alexeyfedorenkofau/Ur-Pak-1269/ИД/Завзаказ/1269/ВД/Пояснение к заказу на Юр.docx

Пояснение к заказу на Юр-Пак.

Состав поставки:

- Шкаф управления главным приводом и приводами намотки;

- Пульт управления приводами намотки ПУ-ПН;

- Пульт управления главным приводом ПУ-ГП;

- Выносной пульт для заправки продукта ВП;

- два индуктивных датчика в квадратном формате.

Требования по шкафу управления.

Включение цепей управления выполняется при помощи переключателя с ключом. Все кнопки аварийной остановки (включая и существующие) интегрируются в схему. Для подключения существующих кнопок установить несколько клемм (например 4 или6 шт.)

Главный привод.

2 режима работы. «НАЛАДКА» и «РАБОТА». Выбор режима выполняется при помощи трехпозиционного переключателя. В режиме «НАЛАДКА» включение от кнопок ПУ-ГП. Обязательная блокировка – при включении главного привода должна быть включена электрическая муфта (предусмотреть различные напряжения управления катушкой муфты. 220В АС, 24В DC и 110 В АС (напряжение берем из существующего шкафа). Регулирование скорости выполняется при помощи 3-х позиционного переключателя с возвратом в среднюю точку (скорость БОЛЬШЕ и МЕНЬШЕ). В Режиме «РАБОТА» включение выполняется нажатием кнопки «ВКЛ. ГЛ. ПРИВОД». Блокировка по тормозу сохраняется.

Контроль включения тормоза выполняется при помощи индуктивного датчика.

При пропадании во время работы сигнала о включении тормоза, главный привод выключается, и система формирует сигнал «АВАРИЯ».

При аварии ЧРС главного привода система формирует сигнал «АВАРИЯ ЧРС».

Режим заправки продукта выполняется при помощи ВП (программируем режим JOG на частотном регуляторе). Значение частоты вращения при заправке определяется во время пуско-наладки.

И читайте ТЗ на машину.

Привода намотки (2 привода).

2 режима работы. «НАЛАДКА» и «РАБОТА». Выбор режима выполняется при помощи трехпозиционного переключателя.

Выбор работающего привода намотки «1 – 1_2 – 2». Выбор при помощи трехпозиционного переключателя. Включение от кнопок ПУ-ПН. В режиме «НАЛАДКА» регулирование скорости выполняется при помощи 3-х позиционного переключателя с возвратом в среднюю точку (скорость БОЛЬШЕ и МЕНЬШЕ). В режиме «РАБОТА» работает ПИД регулятор. Задание на ПИД регулятор задается при помощи резистора. Обратная связь от переменного резистора ЗАКАЗЧИКА.

Если во время работы происходит авария ЧРС приводов намотки – система формирует «АВАРИЮ».

И читайте ТЗ на машину.

По пультам ПУ-ГП и ПУ-ПН я нарисую их схему и расстановку, а вы возможно переведете ее в удобный для цеха вид.
