alexeyfedorenkofau/Ur-Pak-1269/ИД/Завзаказ/1269/КД/1269-1 Шафа/1269-1_ПАСПОРТ v2026 УХЛ4 IP30,31.docx

ISO 9001:2015

ТОВ «Призма Енерджи Груп» т./ф. (057) 752-04-08

Україна, 61037, м. Харків т. (057) 752-04-09

Проспект Героїв Харкова, буд. 199, літ. «АГ-2»

ПАСПОРТ

Шафа управління головним приводом та приводами намотування ФМ ВТ6

ВАХА.656441.946 ПС

ТУ У27.1-38279751-001:20220

Харків 2026 р.

1 ЗАГАЛЬНІ ВІДОМОСТІ ПРО ВИРІБ

Назва виробу | Шафа управління головним приводом та приводами намотування ФМ ВТ6 (далі – виріб)
Позначення | ВАХА.656441.946
Завод-виробник | ТОВ «Призма Енерджи Груп»
Заводський номер | 1269-1
Дата виготовлення | 06.01.2026
Технічні умови | ТУ У27.1-38279751-001:20220

2 ОСНОВНІ ТЕХНІЧНІ ДАНІ Й ХАРАКТЕРИСТИКИ

Номінальна напруга головного кола, В | ~400±10%
Частота, Гц | 50±1Гц
Номінальний струм головного кола, А | 250
Номінальна напруга допоміжного кола, В | ~230±10%/24VDC
Частота, Гц | 50±1Гц/--
Опір ізоляції, МОм, не менш | 1
Ступінь захисту (згідно ДСТУ EN 60529:2018) | IP31
Клас нагрівостійкості ізоляції | В
Клас захисту від ураження електричним струмом (згідно ГОСТ 12.2.007.0-75) | 1
Стійкість до дії механічних чинників зовнішнього середовища М2 (згідно ГОСТ 17516.1) | М2
Маса, кг
Габаритні розміри, мм | (2000+200)x1000x600

3 Умови експлуатації та зберігання

3.1 Виріб має кліматичне виконання УХЛ 4 згідно ГОСТ 15150.

3.2 Місце встановлення виробу має бути захищене від попадання води, масла, емульсії, а також від безпосередньої дії сонячної радіації.

#### 3.3 Виріб повинен зберігатися в штатній тарі в приміщеннях за наступних умов:

- температура повітря довкілля від +1° С до +40°С;

- відносна вологість повітря не більше 90% при температурі +35° С;

- місце зберігання виробу має бути захищене від потрапляння води, мастила, емульсії.

- у приміщеннях для зберігання не повинно бути агресивних домішок, що викликають корозію.

#### 3.4 Електрична мережа для живлення виробу має відповідати вимогам ГОСТ 13109.

4 КОМПЛЕКТНІСТЬ

Найменування | Найменування | Кількість | Примітка
ВАХА.656441.946 | Шафа управління головним приводом та приводами намотування ФМ ВТ6 | 1 | Зав. № 1269-1
ВАХА.656441.946 Е3 | Шафа управління головним приводом та приводами намотування ФМ ВТ6 Схема електрична принципова | 1
ВАХА.656441.946 ПЕ3 | Шафа управління головним приводом та приводами намотування ФМ ВТ6 Перелік елементів | 1
ВАХА.656441.946 ВЗ | Шафа управління головним приводом та приводами намотування ФМ ВТ6 Вигляд загальний | 1
ВАХА.656441.946 ПС | Паспорт | 1
| Ключ від замка шафи | 1

5 ГАРАНТІЙНІ ЗОБОВ'ЯЗАННЯ

5.1 Підприємство-Виробник гарантує відповідність якості виробу вимогам

ТУ У27.1-38279751-001:20220 і цього паспорта за умов виконання вимог транспортування, зберігання, порядку встановлення та експлуатації впродовж 12 місяців з дня введення в експлуатацію, але не більш ніж 18 місяців з дня відвантаження Замовнику.

5.2 Протягом гарантійного терміну підприємство-Виробник зобов'язується здійснювати гарантійний ремонт виробу у випадку виявлення браку підприємства-Виробника. Підприємство-Виробник при цьому залишає за собою право на заміну комплектуючих на рівноцінні (без погіршення параметрів виробу).

5.3 Гарантія діє за умов надання Замовником оригіналу паспорта на виріб, завіреного печаткою підприємства-Виробника.

5.4 У випадку оформлення рекламації на відмову виробу Замовник зобов'язаний у найкоротший термін сповістити про це підприємство-Виробник.

5.5 Виробник залишає за собою право перервати дію гарантії у разі вияву наступних фактів та (або) впливу на працездатність виробу наступних чинників та обставин:

- наявність у зовнішньому вигляді виробу слідів пошкоджень, що сталися за умов транспортування самовивозом;

- неналежні умови зберігання та експлуатації виробу;

- виконання монтажних робіт з встановлення та підключення виробу організаціями, які не мають ліцензії на проведення даного виду робіт;

- наявність пошкоджень обладнання виробу та зменшення ступеню захисту його оболонки в результаті неякісного монтажу виробу на об’єкті Замовника;

- додаткове розміщення Замовником у виробі обладнання, яке не входить до складу ВАХА.656441.946 ПЕ3

- виконання Замовником самостійного ремонту та внесення змін в електричну схему виробу;

- демонтаж Замовником частин устаткування виробу, що вийшли з ладу, без присутності при цьому представника від підприємства-Виробника.

- порушення правил експлуатації і режимів роботи, наведених у паспорті на виріб;

## 6 ВІДОМОСТІ ТА ПРАВИЛА ПРИЙМАННЯ

## 6.1 Відділом технічного контролю ТОВ «Призма Енерджи Груп» були проведені вхідний контроль матеріалів, покупних комплектуючих виробів і приймально-здавальні випробування виробу.

6.2 Вхідний контроль матеріалів, покупних комплектуючих виробів проведено відповідно до вимог ДСТУ ISO 9001:2015 за переліком продукції, що підлягає вхідному контролю, затвердженим у встановленому порядку.

6.3 Правила випробувань і приймання - згідно до чинного ТУ У27.1-38279751-001:20220.

6.4 Шафа управління головним приводом та приводами намотування ФМ ВТ6 ВАХА.656441.946 відповідає вимогам ТУ У27.1-38279751-001:20220 і визнано придатним до експлуатації.

Дата випуску 06.01.2026

Підпис осіб, відповідальних за приймання ____________

7 Підготовка ВИРоБу до використання

7.1 Заходи безпеки при підготовці виробу до використання.

7.1.1 Монтаж (демонтаж) і технічне обслуговування виробу мають проводитися із забезпеченням заходів безпеки, передбачених «Правилами технической эксплуатации электроустановок потребителей» (ПТЭЭП), «Правилами безопасной эксплуатации электроустановок потребителей» (ПБЭЭП), «Правилами безопасной эксплуатации электроустановок потребителей» (НПАОП 40.1-1.21-98)

7.1.2 Перед введенням виробу в роботу необхідно ознайомитись з технічною документацією на виріб.

7.2 Після встановлення виробу на місці необхідно закріпити його, підключити до контуру заземлення приміщення, перевірити усі контактні з'єднання та підтягнути ті, що прослаблено.

7.3 Підключити виріб відповідно до схеми зовнішніх підключень.

8 Заходи безпеки при використанні

8.1 Експлуатація виробу і технічне обслуговування повинні проводитися з забезпеченням заходів безпеки, передбачених «Правилами технической эксплуатации электроустановок потребителей» (ПТЭЭП), «Правилами безопасной эксплуатации электроустановок потребителей» (ПБЭЭП), «Правилами безопасной эксплуатации электроустановок потребителей» (НПАОП 40.1-1.21-98) електротехнічним персоналом з кваліфікаційною групою не нижче за III, який пройшов перевірку згідно з вимогами НПАОП 0.00-4.12-05 «Типовое положение про порядок проведения обучения и проверки знаний по вопросам охраны труда».

8.2 При використанні виробу необхідно періодично перевіряти з'єднання затискача заземлення виробу з контуром заземлення приміщення та надійність підключення.

8.3 У разі зникнення напруги на електроустановці, оперативний персонал має бути готовий до появи напруги у будь-який час без попередження.

9 ВИМОГИ ДО ЕКСПЛУАТАЦІЇ

9.1 При експлуатації виробу Забороняється:

- Допускати до роботи осіб, які не ознайомлені з експлуатаційною документацію на виріб і не мають належної форми допуску до робіт;

- Підключати виріб до мережі живлення без попереднього його заземлення;

- Приєднувати кабелі до працюючого виробу;

- Від’єднувати кабелі від працюючого виробу;

- Відкривати працюючий виріб;

- Проводити зміну режиму роботи (РУЧН.-0-АВТ.) при ввімкненому обладнанні;

- Проводити заміну електрообладнання та апаратів ВИРоБу, а також вносити зміни в електричну схему;

- Піддавати апарати ВИРоБу дії зовнішніх чинників (механічних, ХІМІЧНИХ, термічних та ін.), які можуть впливати на працездатність ВИРоБу;

- Перешкоджати циркуляції повітря всерединиі шафи виробу (затуляти вентиляційні рЕшітки).

- одночасна робота двох вводiв для шаф з пристроями «авр» ТА ЗМІНА НАЛАШТУВАНЬ РЕЛЕ, ЩО ВХОДЯТ ДО СКЛАДУ «авр».

- ПОРУШЕННЯ ОРИГIНАЛЬНОї ПЛОМБИ «ПРИЗМА ЕНЕРДЖИ ГРУП»

9.2 Впродовж дії гарантійного обслуговування також Забороняється:

- Змінювати налаштування регулятора реактивної потужності

9.3 У разі невиконання вимог п.п. 9.1, Виробник залишає за собою право зняти виріб з гарантійного обслуговування.

10 ТЕХНІЧНЕ ОБСЛУГОВУВАННЯ (ТО)

10.1 Для проведення ТО виробу виконайте наступні роботи :

- зніміть напругу з виробу та виключіть можливість її раптової подачі;

- відкрийте двері шафи;

- перевірте відсутність напруги на вхідних затискачах виробу індикатором напруги або переносним вольтметром;

- від'єднайте зовнішні кабелі, які підключені до виробу;

- очистіть внутрішню поверхню шафи від пилу та бруду за допомогою пилососа, пензлика, тканини;

- перевірте відсутність механічних пошкоджень провідників, корозії, слідів підгоряння і при виявленні вказаних пошкоджень усуньте їх;

- підтягніть ослаблені кріпильні і контактні з'єднання;

- перевірте вручну чіткість спрацьовування автоматичних вимикачів при включенні і відключенні;

- замініть несправні автоматичні вимикачі;

- перевірте стан лакофарбових покриттів, пошкоджені покриття відновіть.

10.2 Проведіть контроль перехідного опору між контактом затискача заземлення та металоконструкцією кожної шафи (норма - не більше 0,1 Ω).

10.3 Проведіть перевірку електричного опору ізоляції головних кіл, кіл контролю і сигналізації виробу відносно корпусу виробу (мегаомметром на 500 В), для чого виконайте зазначений нижче обсяг робіт в наступній послідовності:

- від’єднайте від шинки заземлення всі дроти внутрішнього монтажу;

- включіть всі автоматичні вимикачі виробу;

- вийміть з виробу пристрої, що містять напівпровідникові прилади;

- з'єднайте разом струмоведучі елементи вхідних і вихідних електричних кіл, використовуючи мідний луджений дріт, і виміряйте опір ізоляції між ними і контактом затискача для заземлення конструкції шафи.

10.4 Відновіть монтажні з'єднання у виробі.

10.5 Періодичність проведення ТО:

Види робіт | Періодичність | Примітки
Візуальний огляд комплектуючих і видалення пилу | 1 раз на 3 місяці | Або по мірі забруднення
Перевірка стану контактних з'єднань автоматичних вимикачів і плавких вставок | 1 раз на 3 місяці
Огляд і перевірка надійності контактних з’єднань шин (перевірка відсутності нагрівання в місцях з'єднання) | 1 раз на 6 місяців
Перевірка контрольно-вимірювальної й світлосигнальної апаратури | 1 раз на 6 місяців
Перевірка надійності контакту з’єднання захисного заземлення та корпусу шафи | 1 раз на 6 місяців
Вимір опору заземлюючого пристрою | 1 раз на 6 місяців | УВАГА: Виконується атестованим персоналом
Перевірка повного опору петлі «фаза-нуль» | 1 раз на рік

11 ВІДОМОСТІ ПРО РЕКЛАМАЦІЇ

Дата рекламації | Номер рекламаційного акта | Короткий зміст рекламації | Міри, прийняті по рекламації | Посада. ФІБ підпис
