alexeyfedorenkofau/Ur-Pak-1269/ИД/Завзаказ/1269/ВД/2025_11_17_ФГМ.- ИД в схему.xlsx

Sheet: Вариант №2 (2)
АРТИКУЛ | 30% | EUR | 50.00 | 43.00 | UAH | кол. | скидка | ПРАЙС |  | ЗАКУПКА |  | ↓ | ↑
 | НАИМЕНОВАНИЕ | без НДС | c НДС | USD c НДС | c НДС | шт | % | цена | сумма | цена | сумма | 695426.59 | 847550.00
 | Шкаф управления |  |  |  |  | 1 |  | 635832.36 |  | 491746.43 |  | 506146.43 | 639280.00 | 532733.3333
 | Конструктив
 | 2000х800х400
XL55-2084 | Шафа XL55-2084 | 398.38 |  |  |  | 1 | 10% | 23902.81 | 23902.81 | 21512.53 | 21512.53
XL-UM1 | Куток монтажний XL-UM1 | 12.94 |  |  |  | 2 | 10% | 776.65 | 1553.30 | 698.99 | 1397.97
XL-RV18 | Рейка вертикальна XL-RV18 | 40.46 |  |  |  | 1 | 10% | 2427.43 | 2427.43 | 2184.69 | 2184.69
XL-MM28 | Міст монтажний XL-MM28 | 14.97 |  |  |  | 5 | 10% | 897.90 | 4489.51 | 808.11 | 4040.56
XL-MM48 | Міст монтажний XL-MM48 | 23.08 |  |  |  | 2 | 10% | 1384.71 | 2769.41 | 1246.24 | 2492.47
XL-RH14 | Рейка горизонтальна XL-RH14 | 20.63 |  |  |  | 3 | 10% | 1237.80 | 3713.40 | 1114.02 | 3342.06
XL-UM2 | Куток монтажний XL-UM2 | 9.51 |  |  |  | 3 | 10% | 570.86 | 1712.57 | 513.77 | 1541.31
XLE-CB14 | Панель бокова цоколя XLE-CB14 | 5.73 |  |  |  | 1 | 10% | 343.98 | 343.98 | 309.58 | 309.58
XLE-CT18 | Панель торцева цоколя XLE-CT18 | 23.14 |  |  |  | 1 | 10% | 1388.14 | 1388.14 | 1249.33 | 1249.33
XLE-U10 | Кутовий елемент цоколя XLE-U10 | 28.28 |  |  |  | 1 | 10% | 1696.80 | 1696.80 | 1527.12 | 1527.12
XL-RB12 | Рим-болт XL-RB12 | 20.00 |  |  |  | 1 | 10% | 1200.00 | 1200.00 | 1080.00 | 1080.00
XL-UU20 | Куток універсальний XL-UU20 | 43.78 |  |  |  | 1 | 10% | 2626.88 | 2626.88 | 2364.19 | 2364.19
NSYCVF300M230PF | ВЕНТИЛЯТОР 297M3Ч 230В | 114.27 |  |  |  | 1 | 35% | 6856.28 | 6856.28 | 4456.58 | 4456.58
NSYCAG291LPF | РЕШІТКА ВИПУСКНА 291X291 | 32.99 |  |  |  | 2 | 20% | 1979.40 | 3958.80 | 1583.52 | 3167.04
NSYCCOTHO | ТЕРМОСТАТ ВЕНТИЛЯТОРА °C | 10.37 | 0.01 |  |  | 1 | 20% | 622.95 | 622.95 | 498.36 | 498.36 |  |  | 47824.24
 | Питание
 | Рубильник 250 А +.боковая ручка+ штанга 200 мм |  |  |  | 9500.00 | 1 | 0% | 9500.00 | 9500.00 | 9500.00 | 9500.00
 | РБД-250 |  |  |  | 500.00 | 3 | 0% | 500.00 | 1500.00 | 500.00 | 1500.00
 | Разное |  |  |  | 10000.00 | 1 | 0% | 10000.00 | 10000.00 | 10000.00 | 10000.00
 | Работа
 | Цех |  |  |  | 8000.00 | 1 | 0%
 | Техотдел |  |  |  | 4800.00 | 1 | 0%
 | ОТК |  |  |  | 1600.00 | 1 | 0%
 | Главный привод 22 кВт
 | Поз. , Норія, 30 кВт
GV3P65 | АВТ. ВИМ З КОМБ.РОЗЧЕП.65А ГВИНТ.ЗАТИСК. | 173.95 |  |  |  | 1 | 35% | 10436.74 | 10436.74 | 6783.88 | 6783.88
GVAE1 | ДОДАТ.БЛОК КОНТАКТІВ НО АБО НЗ | 5.72 |  |  |  | 1 | 35% | 343.20 | 343.20 | 223.08 | 223.08
atv930D30N4 | ПЕРЕТВОРЮВАЧ ЧАСТОТИ ATV930 30кВт 380В | 2732.40 |  |  |  | 1 | 35% | 163944.00 | 163944.00 | 106563.60 | 106563.60
A9K02106 | Автоматичний вимикач K60N 1P 6A C 6кA | 4.26 |  |  |  | 1 | 35% | 255.60 | 255.60 | 166.14 | 166.14
3012325 | FBSC: Захисний ковпачок | 0.94 |  |  |  | 1 | 35% | 56.40 | 56.40 | 36.66 | 36.66
4520016 | Провід H07V-K 1X16 чорний (струм 85 А) | 4.61 |  |  |  | 12 | 20% | 276.50 | 3318.00 | 221.20 | 2654.40
BM00614 | Наконечник, 16 мм2 |  | 0.08 |  |  | 24 | 20% | 4.15 | 99.64 | 3.32 | 79.71
3044199 | Прохідна клема 16 мм.кв. UT 16 | 1.62 |  |  |  | 3 | 35% | 97.17 | 291.51 | 63.16 | 189.48
3044212 | Клема заземлення 16 мм.кв. UT 16-PE | 4.72 |  |  |  | 1 | 35% | 283.27 | 283.27 | 184.13 | 184.13
0829144 | Маркування для клем UCT-TM 12 | 0.20 |  |  |  | 4 | 35% | 12.00 | 48.00 | 7.80 | 31.20
3047206 | Кінцева кришка D-UT 16 | 0.53 |  |  |  | 1 | 35% | 31.60 | 31.60 | 20.54 | 20.54
3022218 | Кінцевий тримач CLIPFIX 35 | 0.48 |  |  |  | 1 | 35% | 29.04 | 29.04 | 18.88 | 18.88
0811969 | Тримач маркування KLM 3 | 0.23 |  |  |  | 1 | 35% | 14.03 | 14.03 | 9.12 | 9.12
5031388 | Листи з маркувальними етикетками BMK 20X 8 YE | 1.00 |  |  |  | 3 | 35% | 60.00 | 180.00 | 39.00 | 117.00
4510011 | Провід H05V-K 1X0,5 чорний у бухтах по 100 м | 0.22 |  |  |  | 30 | 20% | 13.00 | 390.00 | 10.40 | 312.00
BM00601 | Наконечник, 0,5 мм2 |  | 0.01 |  |  | 20 | 20% | 0.71 | 14.17 | 0.57 | 11.34
3210499 | PT 2,5-3L Прохідна клема | 2.68 |  |  |  | 3 | 35% | 160.61 | 481.84 | 104.40 | 313.20
0828744 | Маркування для клем UCT-TMF 5 | 0.06 |  |  |  | 6 | 35% | 3.60 | 21.60 | 2.34 | 14.04
3211647 | Кінцева кришка D-PT 2,5-3L | 0.52 |  |  |  | 1 | 35% | 30.99 | 30.99 | 20.14 | 20.14
3044092 | Клема заземлення 2,5 мм.кв. UT 2,5-PE | 1.83 |  |  |  | 1 | 35% | 109.63 | 109.63 | 71.26 | 71.26
0828734 | Маркування для клем UCT-TM 5 | 0.05 |  |  |  | 2 | 35% | 3.00 | 6.00 | 1.95 | 3.90
3047028 | Кінцева кришка D-UT 2,5/10 | 0.34 |  |  |  | 1 | 35% | 20.65 | 20.65 | 13.42 | 13.42
3022218 | Кінцевий тримач CLIPFIX 35 | 0.48 |  |  |  | 1 | 35% | 29.04 | 29.04 | 18.88 | 18.88
0811969 | Тримач маркування KLM 3 | 0.23 |  |  |  | 1 | 35% | 14.03 | 14.03 | 9.12 | 9.12
5031388 | Листи з маркувальними етикетками BMK 20X 8 YE | 1.00 |  |  |  | 3 | 35% | 60.00 | 180.00 | 39.00 | 117.00
1163116 | WMS-OT HF 2,4 (EX4)RL: Маркувальний кембрік 120 метрів. | 1.36 |  |  |  | 1 | 35% | 81.43 | 81.43 | 52.93 | 52.93
 | Поз. , Норія, 18,5 кВт
GV3P40 | АВТ. ВИМ З КОМБ.РОЗЧЕП.40А ГВИНТ.ЗАТИСК. | 163.40 |  |  |  | 2 | 35% | 9803.95 | 19607.90 | 6372.57 | 12745.14
GVAE1 | ДОДАТ.БЛОК КОНТАКТІВ НО АБО НЗ | 5.72 |  |  |  | 2 | 35% | 343.20 | 686.40 | 223.08 | 446.16
atv930D18N4 | ПЕРЕТВОРЮВАЧ ЧАСТОТИ ATV930 18,5кВт 380В | 1995.11 |  |  |  | 2 | 25% | 119706.60 | 239413.20 | 89779.95 | 179559.90
A9K02106 | Автоматичний вимикач K60N 1P 6A C 6кA | 4.26 |  |  |  | 2 | 35% | 255.60 | 511.20 | 166.14 | 332.28
ZB5AD3 | ГОЛОВКА ДЛЯ ПЕРЕМИКАЧА | 5.23 |  |  |  | 2 | 35% | 313.80 | 627.60 | 203.97 | 407.94
ZB5AZ009 | ФІКСУЮЧА ПЛАСТИНА ХВ5А | 1.20 |  |  |  | 2 | 35% | 72.00 | 144.00 | 46.80 | 93.60
ZBE101 | БЛОК-КОНТ для XB5, 1НО | 2.94 |  |  |  | 6 | 35% | 176.40 | 1058.40 | 114.66 | 687.96
4520014 | Провід H07V-K 1X6 чорний (струм 46 А) | 1.72 |  |  |  | 24 | 20% | 103.50 | 2484.00 | 82.80 | 1987.20
BM00610 | Наконечник, 6 мм2 |  | 0.04 |  |  | 48 | 20% | 2.01 | 96.36 | 1.61 | 77.09
3044199 | Прохідна клема 16 мм.кв. UT 16 | 1.62 |  |  |  | 6 | 35% | 97.17 | 583.02 | 63.16 | 378.96
3044212 | Клема заземлення 16 мм.кв. UT 16-PE | 4.72 |  |  |  | 2 | 35% | 283.27 | 566.54 | 184.13 | 368.25
0829144 | Маркування для клем UCT-TM 12 | 0.20 |  |  |  | 8 | 35% | 12.00 | 96.00 | 7.80 | 62.40
3047206 | Кінцева кришка D-UT 16 | 0.53 |  |  |  | 2 | 35% | 31.60 | 63.20 | 20.54 | 41.08
3022218 | Кінцевий тримач CLIPFIX 35 | 0.48 |  |  |  | 2 | 35% | 29.04 | 58.08 | 18.88 | 37.75
0811969 | Тримач маркування KLM 3 | 0.23 |  |  |  | 2 | 35% | 14.03 | 28.06 | 9.12 | 18.24
5031388 | Листи з маркувальними етикетками BMK 20X 8 YE | 1.00 |  |  |  | 6 | 35% | 60.00 | 360.00 | 39.00 | 234.00
4510011 | Провід H05V-K 1X0,5 чорний у бухтах по 100 м | 0.22 |  |  |  | 60 | 20% | 13.00 | 780.00 | 10.40 | 624.00
BM00601 | Наконечник, 0,5 мм2 |  | 0.01 |  |  | 40 | 20% | 0.71 | 28.34 | 0.57 | 22.67
3210499 | PT 2,5-3L Прохідна клема | 2.68 |  |  |  | 6 | 35% | 160.61 | 963.68 | 104.40 | 626.39
0828744 | Маркування для клем UCT-TMF 5 | 0.06 |  |  |  | 12 | 35% | 3.60 | 43.20 | 2.34 | 28.08
3211647 | Кінцева кришка D-PT 2,5-3L | 0.52 |  |  |  | 2 | 35% | 30.99 | 61.98 | 20.14 | 40.28
3044092 | Клема заземлення 2,5 мм.кв. UT 2,5-PE | 1.83 |  |  |  | 2 | 35% | 109.63 | 219.25 | 71.26 | 142.51
0828734 | Маркування для клем UCT-TM 5 | 0.05 |  |  |  | 4 | 35% | 3.00 | 12.00 | 1.95 | 7.80
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
 | Робота з программування |  |  |  | 50000.00 | 1 | 0% | 50000.00 | 50000.00 | 50000.00 | 50000.00 |  |  | 86000 | 71666.66667
 | Робота з программування |  |  |  | 16000.00 | 1 | 0% | 16000.00 | 16000.00 | 16000.00 | 16000.00 |  |  | 72000 | 14400 | 86400
 | Пуско-налогоджувальні роботи |  |  |  | 20000.00 | 1 | 0% | 20000.00 | 20000.00 | 20000.00 | 20000.00 |  |  | 36000 | 7200 | 43200
 | Шеф-монтаж |  |  |  | 20000.00 | 1 | 0% | 20000.00 | 20000.00 | 20000.00 | 20000.00 |  |  |  | 21600 | 129600
 | Командировочные расходы |  |  |  | 20000.00 | 1 | 0% | 20000.00 | 20000.00 | 20000.00 | 20000.00
 | Кабель |  |  |  |  | 1 |  | 0.00 |  | 0.00 |  | 0.00 | 0.00
 | Для приводов намотки КГ НВ 4х6 |  |  |  |  | 22 | 0% | 0.00 | 0.00 | 0.00 | 0.00 |  |  | 86000 | 71666.66667
 | Для главного привода КГ НВ 4х10 |  |  |  |  | 15 | 0% | 0.00 | 0.00 | 0.00 | 0.00 |  |  | 72000 | 14400 | 86400
 | Датчик инжуктивній 3х1 єкран |  |  |  |  | 25 | 0% | 0.00 | 0.00 | 0.00 | 0.00 |  |  | 36000 | 7200 | 43200
 | Виносний пульт |  |  |  |  | 1 | 0% | 0.00 | 0.00 | 0.00 | 0.00 |  |  |  | 21600 | 129600
 | Командировочные расходы |  |  |  |  | 1 | 0% | 0.00 | 0.00 | 0.00 | 0.00
 | Розподільна клема PTFIX 6/18X2,5 BU

Sheet: Вариант №2 (3)
АРТИКУЛ
 | НАИМЕНОВАНИЕ | шт
 | Шкаф управления | 1
 | Конструктив
 | 2000х800х400
 | Шафа 2000х800х400 КУБ IP 54 | 1
NSYCVF300M230PF | ВЕНТИЛЯТОР 297M3Ч 230В | 1
NSYCAG291LPF | РЕШІТКА ВИПУСКНА 291X291 | 2
NSYCCOTHO | ТЕРМОСТАТ ВЕНТИЛЯТОРА °C | 1
GV3P65 | АВТ. ВИМ З КОМБ.РОЗЧЕП.65А ГВИНТ.ЗАТИСК. | 1
atv930D30N4 | ПЕРЕТВОРЮВАЧ ЧАСТОТИ ATV930 30кВт 380В | 1
GV3P40 | АВТ. ВИМ З КОМБ.РОЗЧЕП.40А ГВИНТ.ЗАТИСК. | 2
atv930D18N4 | ПЕРЕТВОРЮВАЧ ЧАСТОТИ ATV930 18,5кВт 380В | 2
TM241CE40T | ПЛК M241 40 ВХ/ВИХ ТРАНЗ 2RS485 1ETH | 1
TM3DI16 | МОДУЛЬ TM3 16 ВХ =24В | 1
TM3AI8 | МОДУЛЬ TM3 8 АНАЛОГ ВХ 12 БІТ | 1
TM3AQ4G | МОДУЛЬ TM3 4 АНАЛОГ ВИХ 12 БІТ ПРУЖ | 1
TM3XFHSC202G | МОДУЛЬ TM3 ЕКСПЕРТ, 2 ЛІЧ.+ПОДІЯ, ПРУЖ. (для енкодера) | 1
 | Разное (Монтажные материалы, маркировка, ввод питания в шкафа, промежуточные, клеммы, разработка схемы, проверка ОТК) | 1

Sheet: Кабель
Силовой
Главній привод | 4х6 мм2
Привод намотки | 4х4 мм2
Контрольній
Датчики

Sheet: Доработка 17_11
АРТИКУЛ | 30% | EUR | 50.00 | 43.00 | UAH | кол. | скидка | ПРАЙС |  | ЗАКУПКА |  | ↓ | ↑
 | НАИМЕНОВАНИЕ | без НДС | c НДС | USD c НДС | c НДС | шт | % | цена | сумма | цена | сумма | 22830.00 | 29680.00
 | Комплектация ПУ1 заправка |  |  |  |  | 1 |  | 22830.00 |  | 22830.00 |  | 22830.00 | 29680.00 | 24733.33333
DLAP2 B | Пульт RAVIOLI | 43.00 |  |  |  | 1 | 0% | 2580.00 | 2580.00 | 2580.00 | 2580.00 |  |  | 4946.666667
Разьем 4-пін |  | 45.00 |  |  |  | 1 | 0% | 2700.00 | 2700.00 | 2700.00 | 2700.00 |  |  | 29680 | 14840
Источник питания | NDR-24-120 | 60.00 |  |  |  | 1 | 0% | 3600.00 | 3600.00 | 3600.00 | 3600.00
 | клеммы соединительные |  |  |  | 500 | 5 | 0% | 500.00 | 2500.00 | 500.00 | 2500.00
 | Мотнатжні роботи |  |  |  | 10000.00 | 1 | 0% | 10000.00 | 10000.00 | 10000.00 | 10000.00
 | Реле времени |  | 29.00 |  |  | 1 | 0% | 1450.00 | 1450.00 | 1450.00 | 1450.00
 | Кабель |  |  |  |  | 1 |  | 0.00 |  | 0.00 |  | 0.00 | 0.00
 | Для приводов намотки КГ НВ 4х6 |  |  |  |  | 22 | 0% | 0.00 | 0.00 | 0.00 | 0.00
 | Для главного привода КГ НВ 4х10 |  |  |  |  | 15 | 0% | 0.00 | 0.00 | 0.00 | 0.00 |  |  |  |  | 0
 | Датчик индуктивній+резистор 3х1 єкран |  |  |  |  | 37 | 0% | 0.00 | 0.00 | 0.00 | 0.00 |  |  |  |  | 0
 | Пульт головного приводу |  |  |  |  | 1 | 0% | 0.00 | 0.00 | 0.00 | 0.00 |  |  |  |  | 0
 | Командировочные расходы |  |  |  |  | 1 | 0% | 0.00 | 0.00 | 0.00 | 0.00
