alexeyfedorenkofau/Ur-Pak-1269/(list of files, cad)

Other CAD files:
ИД/Завзаказ/1269/ВД/Разметка пультов.dwg
