alexeyfedorenkofau/Ur-Pak-1269/ИД/Завзаказ/1269/ВД/Разметка пультов-Модель.pdf

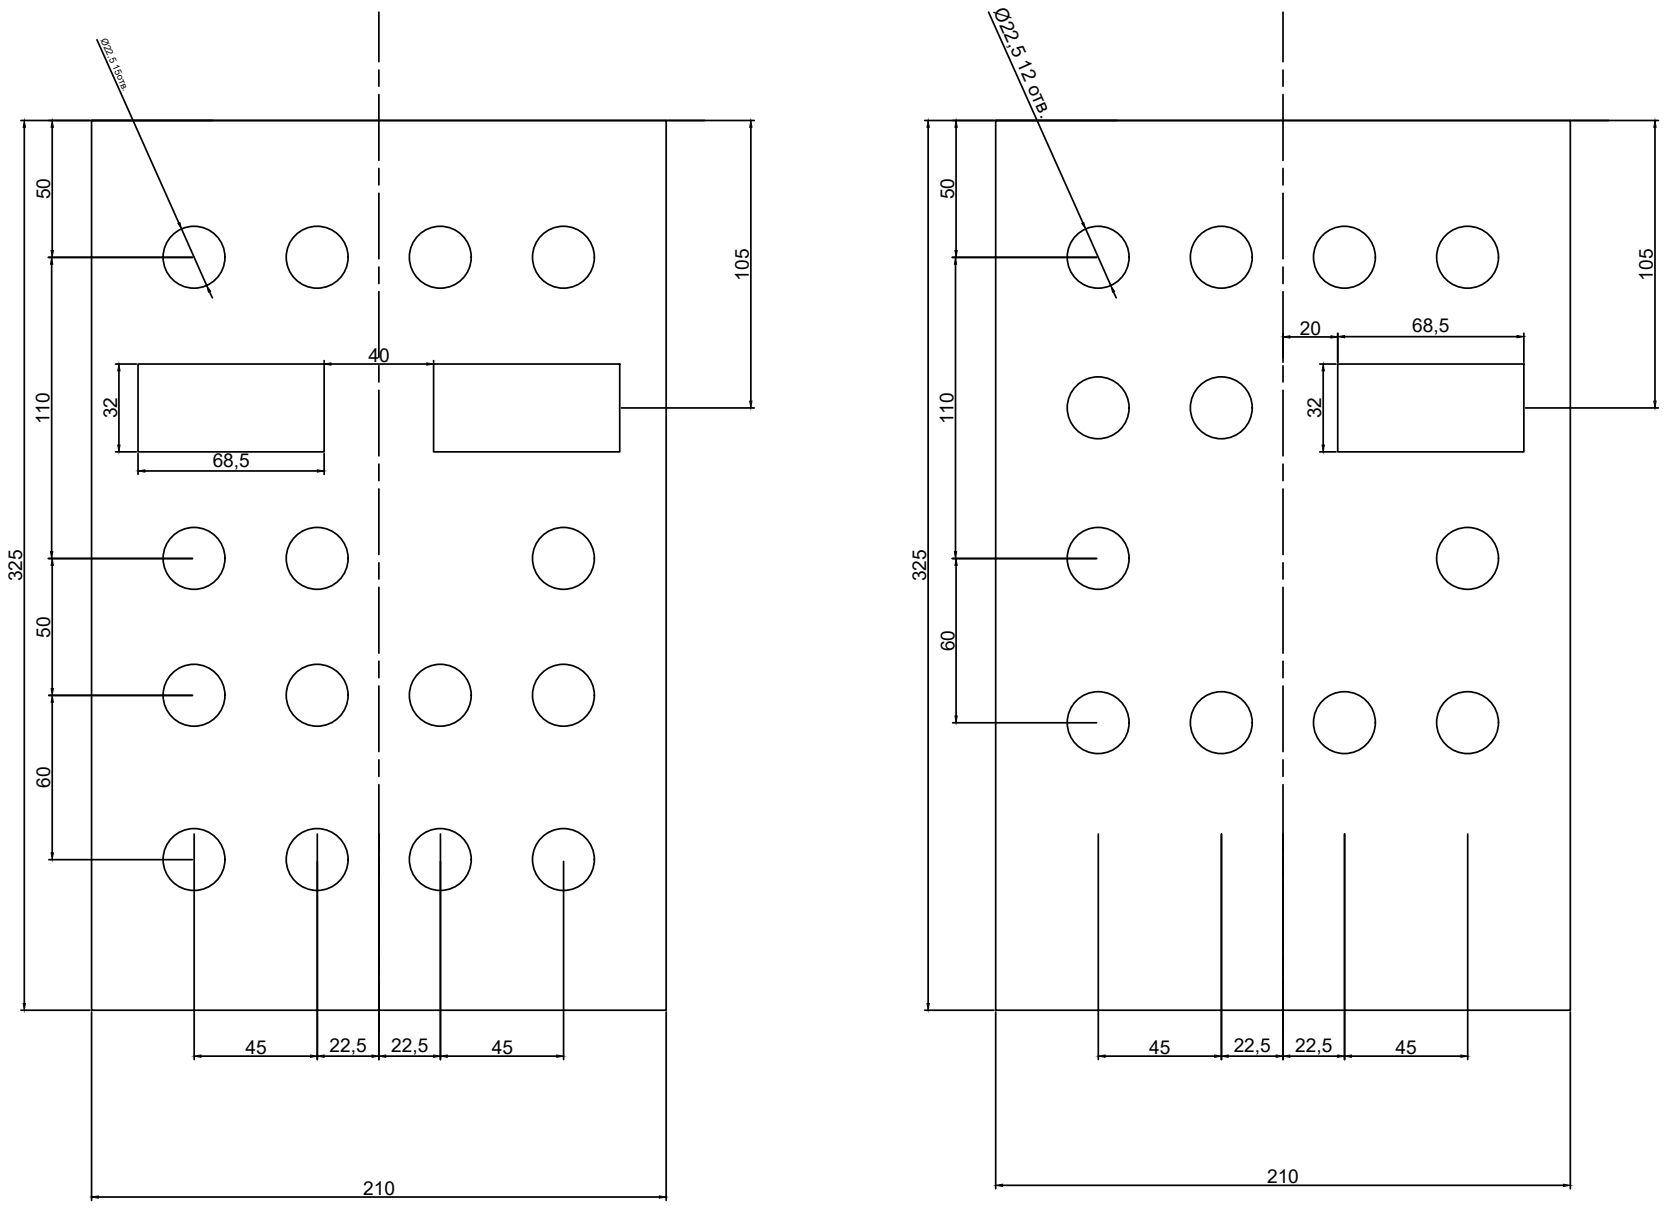
[picture p1: page 1]
Ø22,5 15отв.; 325 45 22,5 22,5 45 Ø22,5 12 отв.
