alexeyfedorenkofau/Ur-Pak-1269/ИД/Завзаказ/1269/КД/1269-1 Шафа/1269-1 Шафа керування.pdf

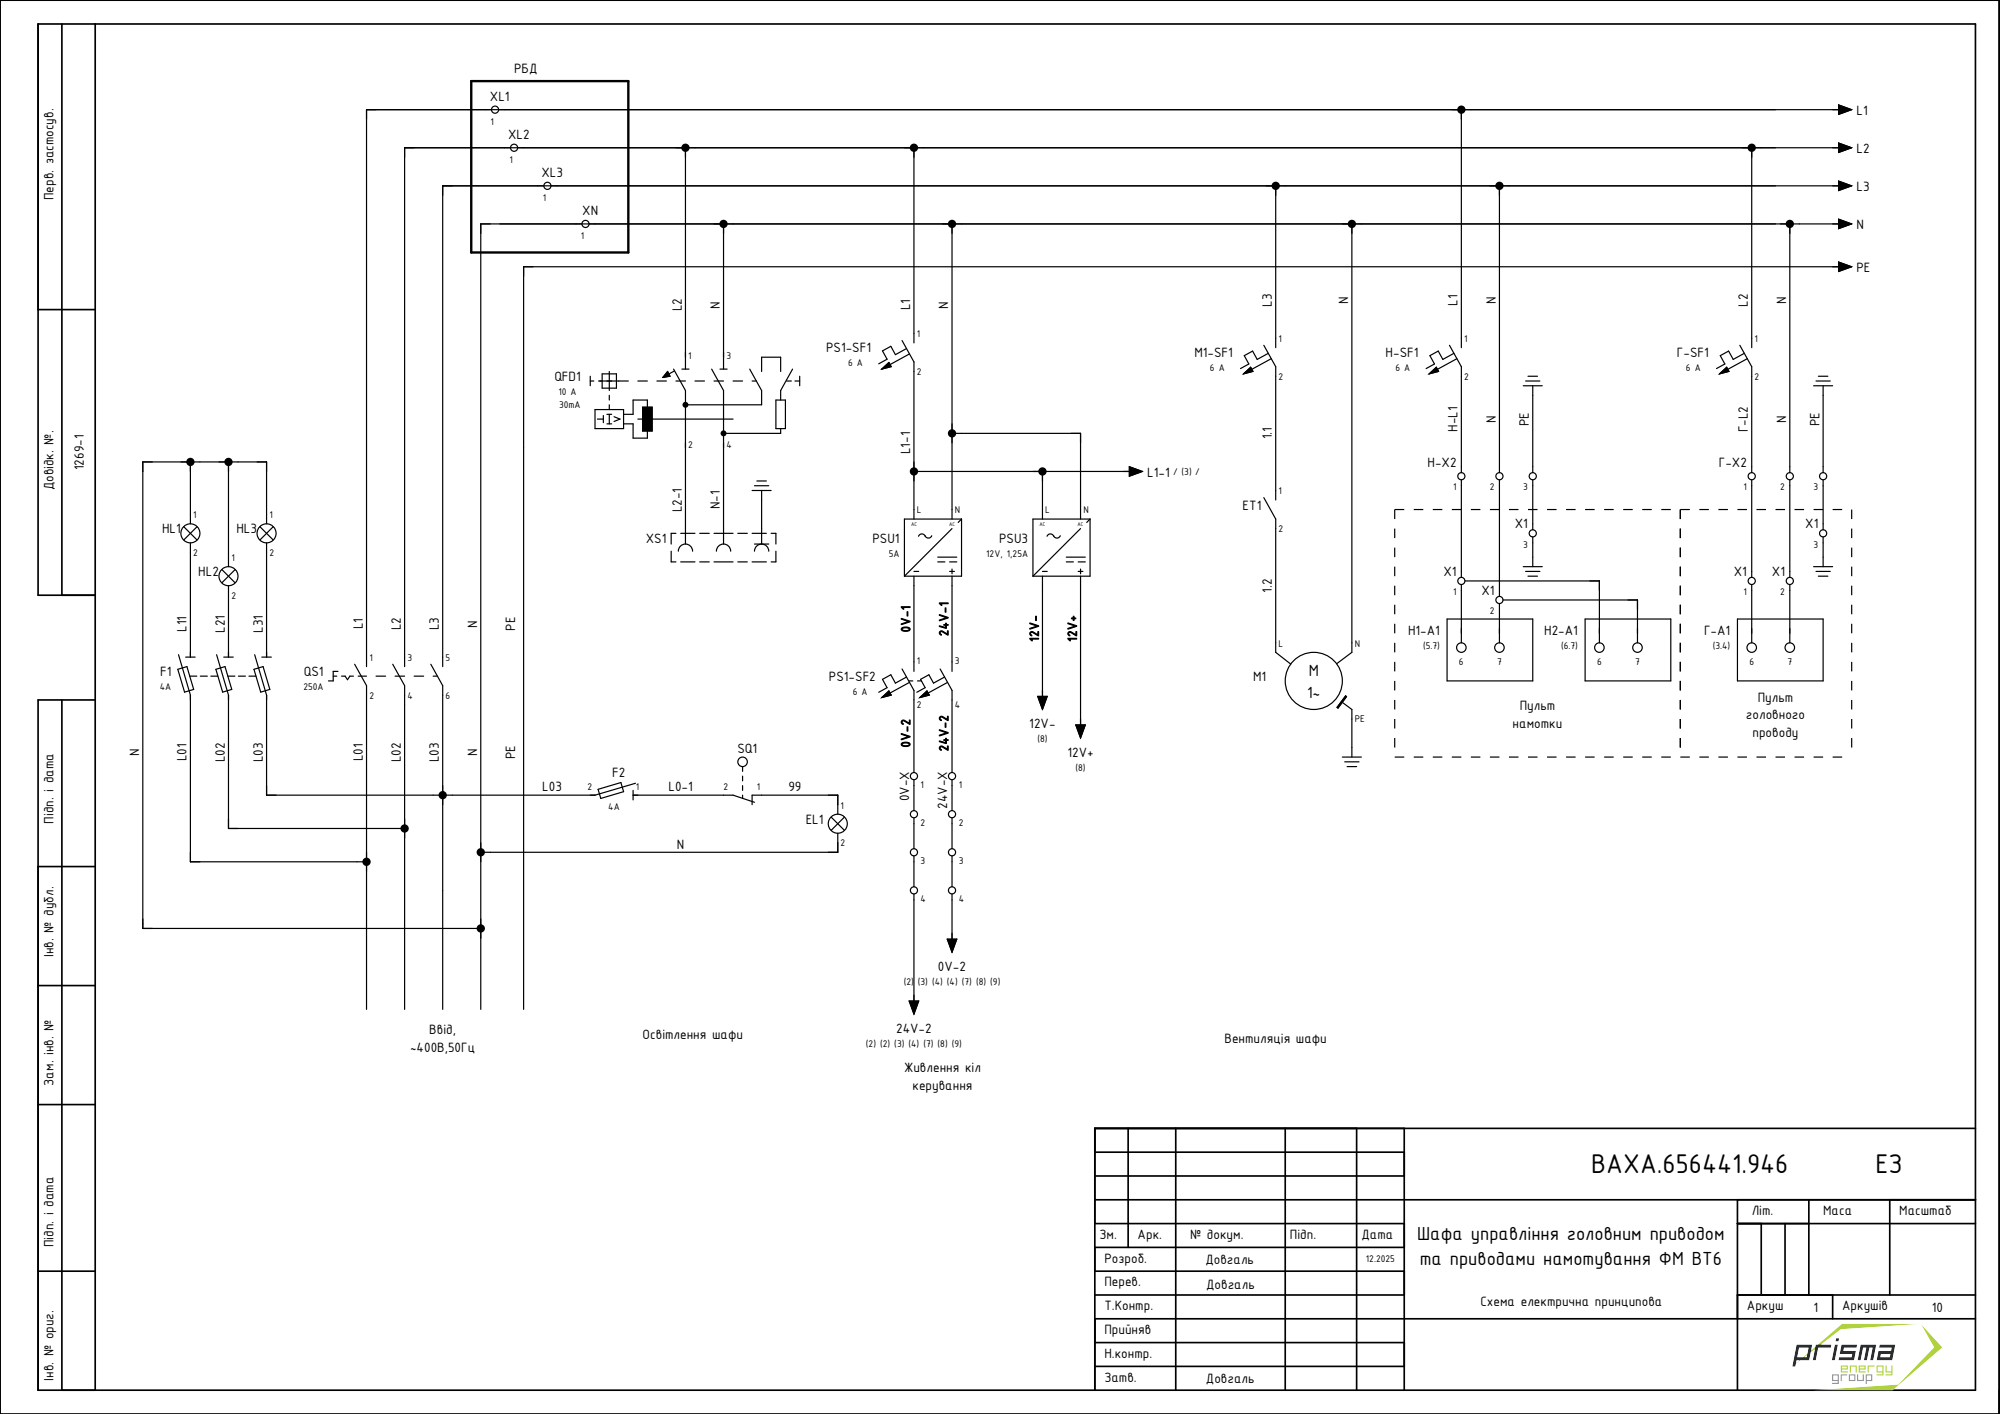
[picture p2: page 1]

Довідк. №. Перв. застосув. Інв. № ориг. Підп. і дата Зам. інв. № Інв. № дубл. Підп. і дата

ВАХА.656441.946 ЕЗ

Шафа управління головним приводом та приводами намотування ФМ ВТ6 | Літ. | Маса | Масштаб

Зм. | Арк. | № докум. | Підп. | Дата
Розроб. | | Довгаль | | 12.2025
Перев. | | Довгаль
Т.Контр. | | | | | Аркуш | 10 Схема електрична принципова Аркушів

Прийняв
Н.контр.
Затв. | Довгаль

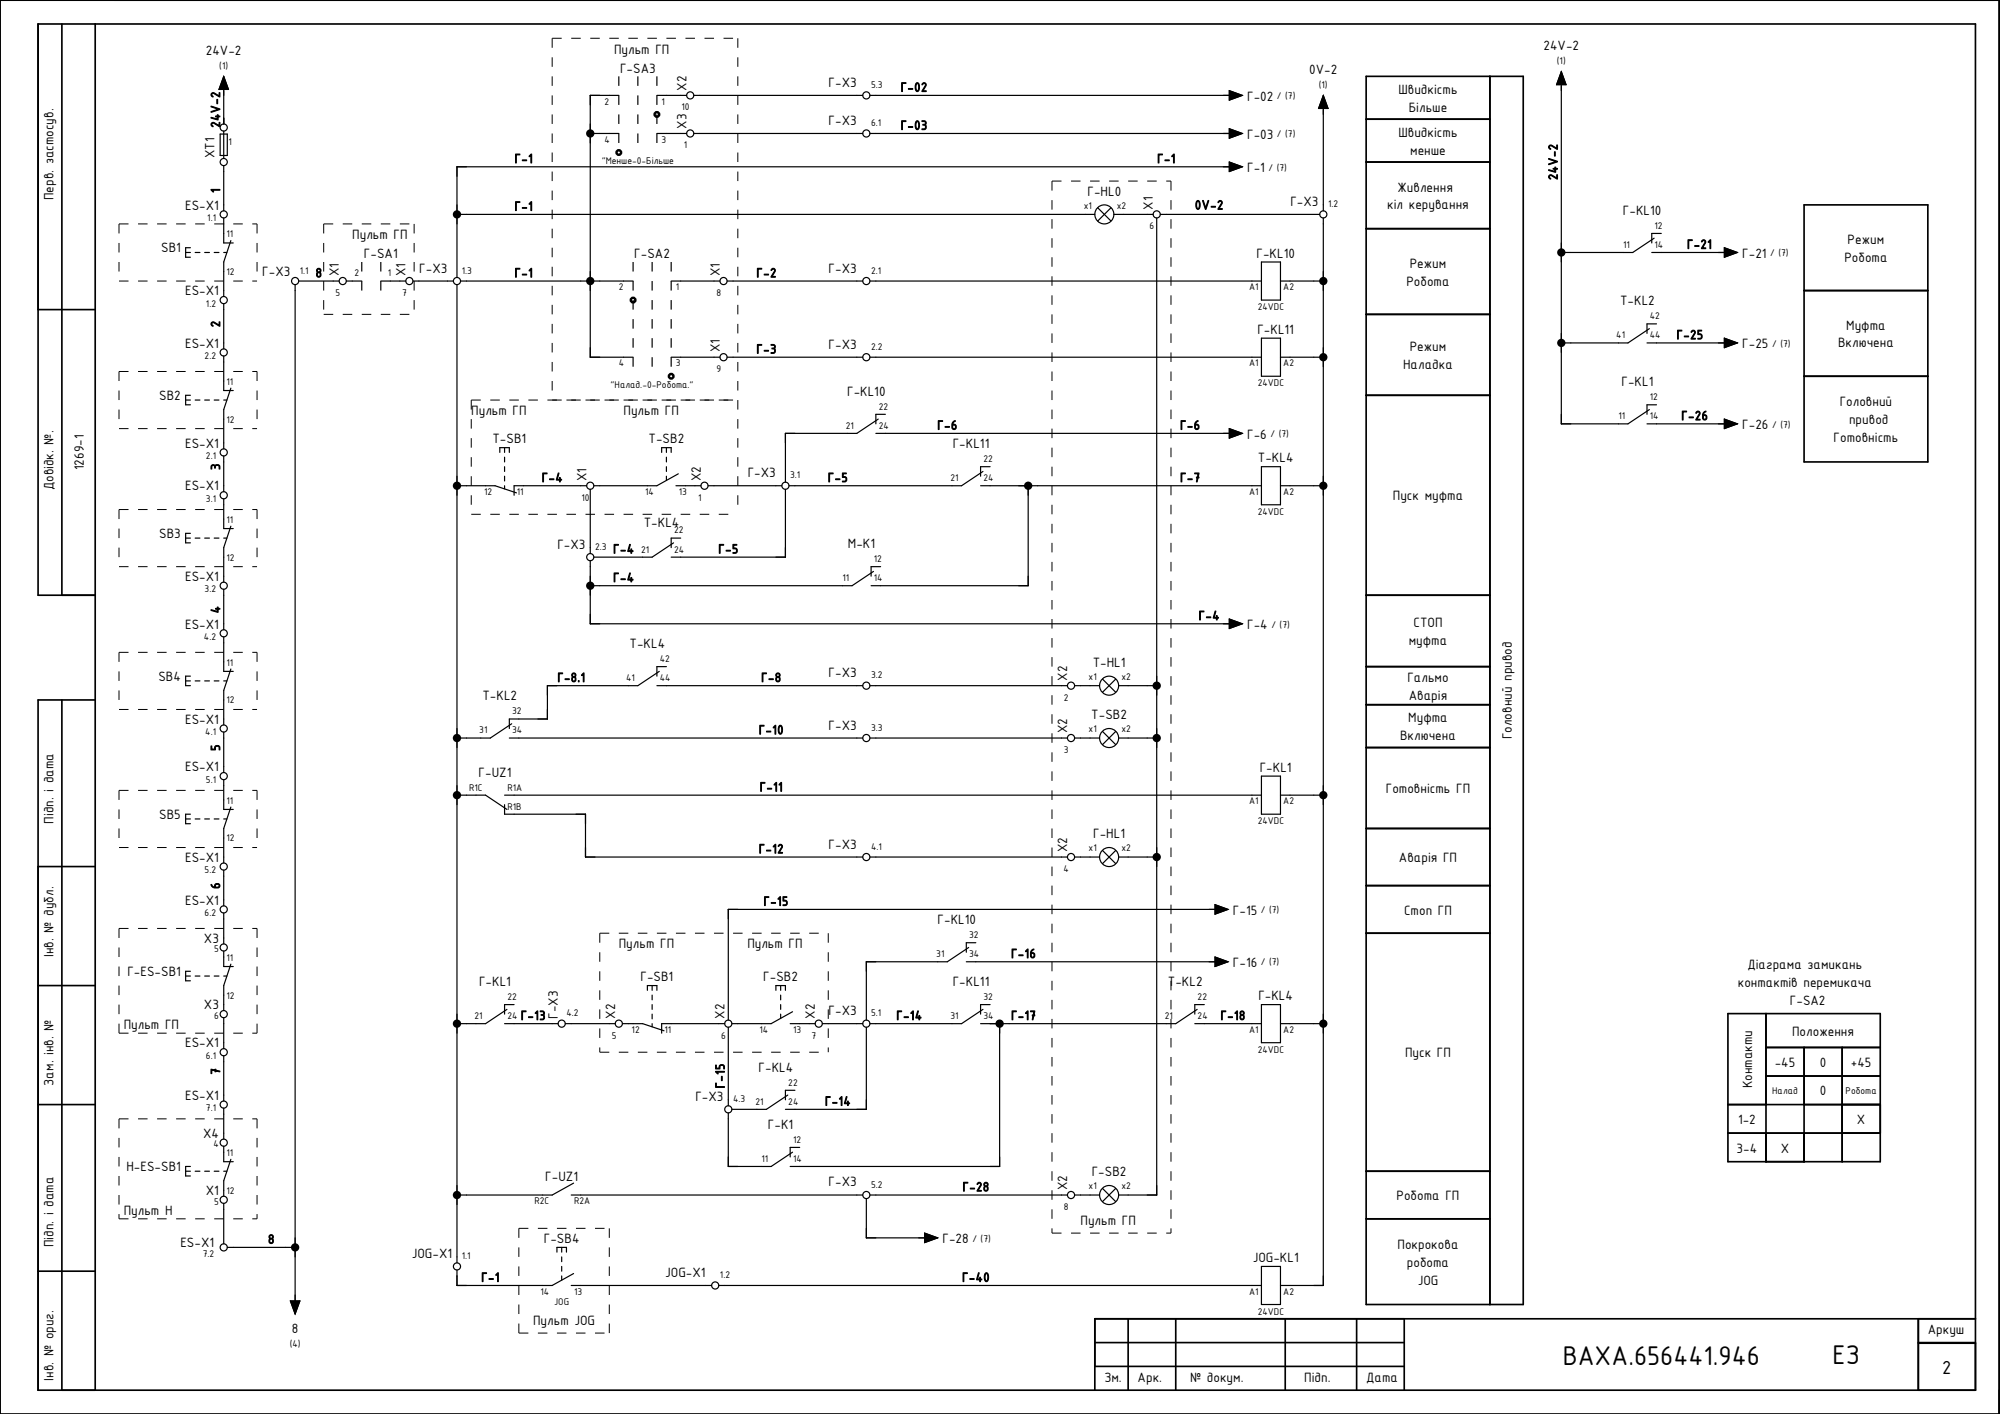
[picture p3: page 2]
Арк.; № докум.; Підп.; Дата; Аркуш; ВАХА.656441.946; Живлення кіл керування; Режим Робота; СТОП муфта; Пуск муфта; Стоп ГП; Робота ГП; Готовність ГП; Пуск ГП; Головний привод; Аварія ГП; Муфта Включена; Діаграма замикань контактів перемикача Г-SA2; Режим Наладка; Гальмо Аварія; Головний привод Готовність; Пульт ГП; Пульт Н; Пульт JOG; Покрокова робота JOG; Швидкість менше; Швидкість Більше; 24VDC; "Налад.-0-Робота."; JOG; JOG-X1 1.2; JOG-X1; JOG-KL1; "Менше-0-Більше

Пульт ГП | Г-SA3

Довідк. №. Перв. застосув. Інв. № ориг. Підп. і дата Зам. інв. № Інв. № дубл. Підп. і дата

3-4Контакти | Положення

Налад | 0 | Робота

8 Пульт ГП

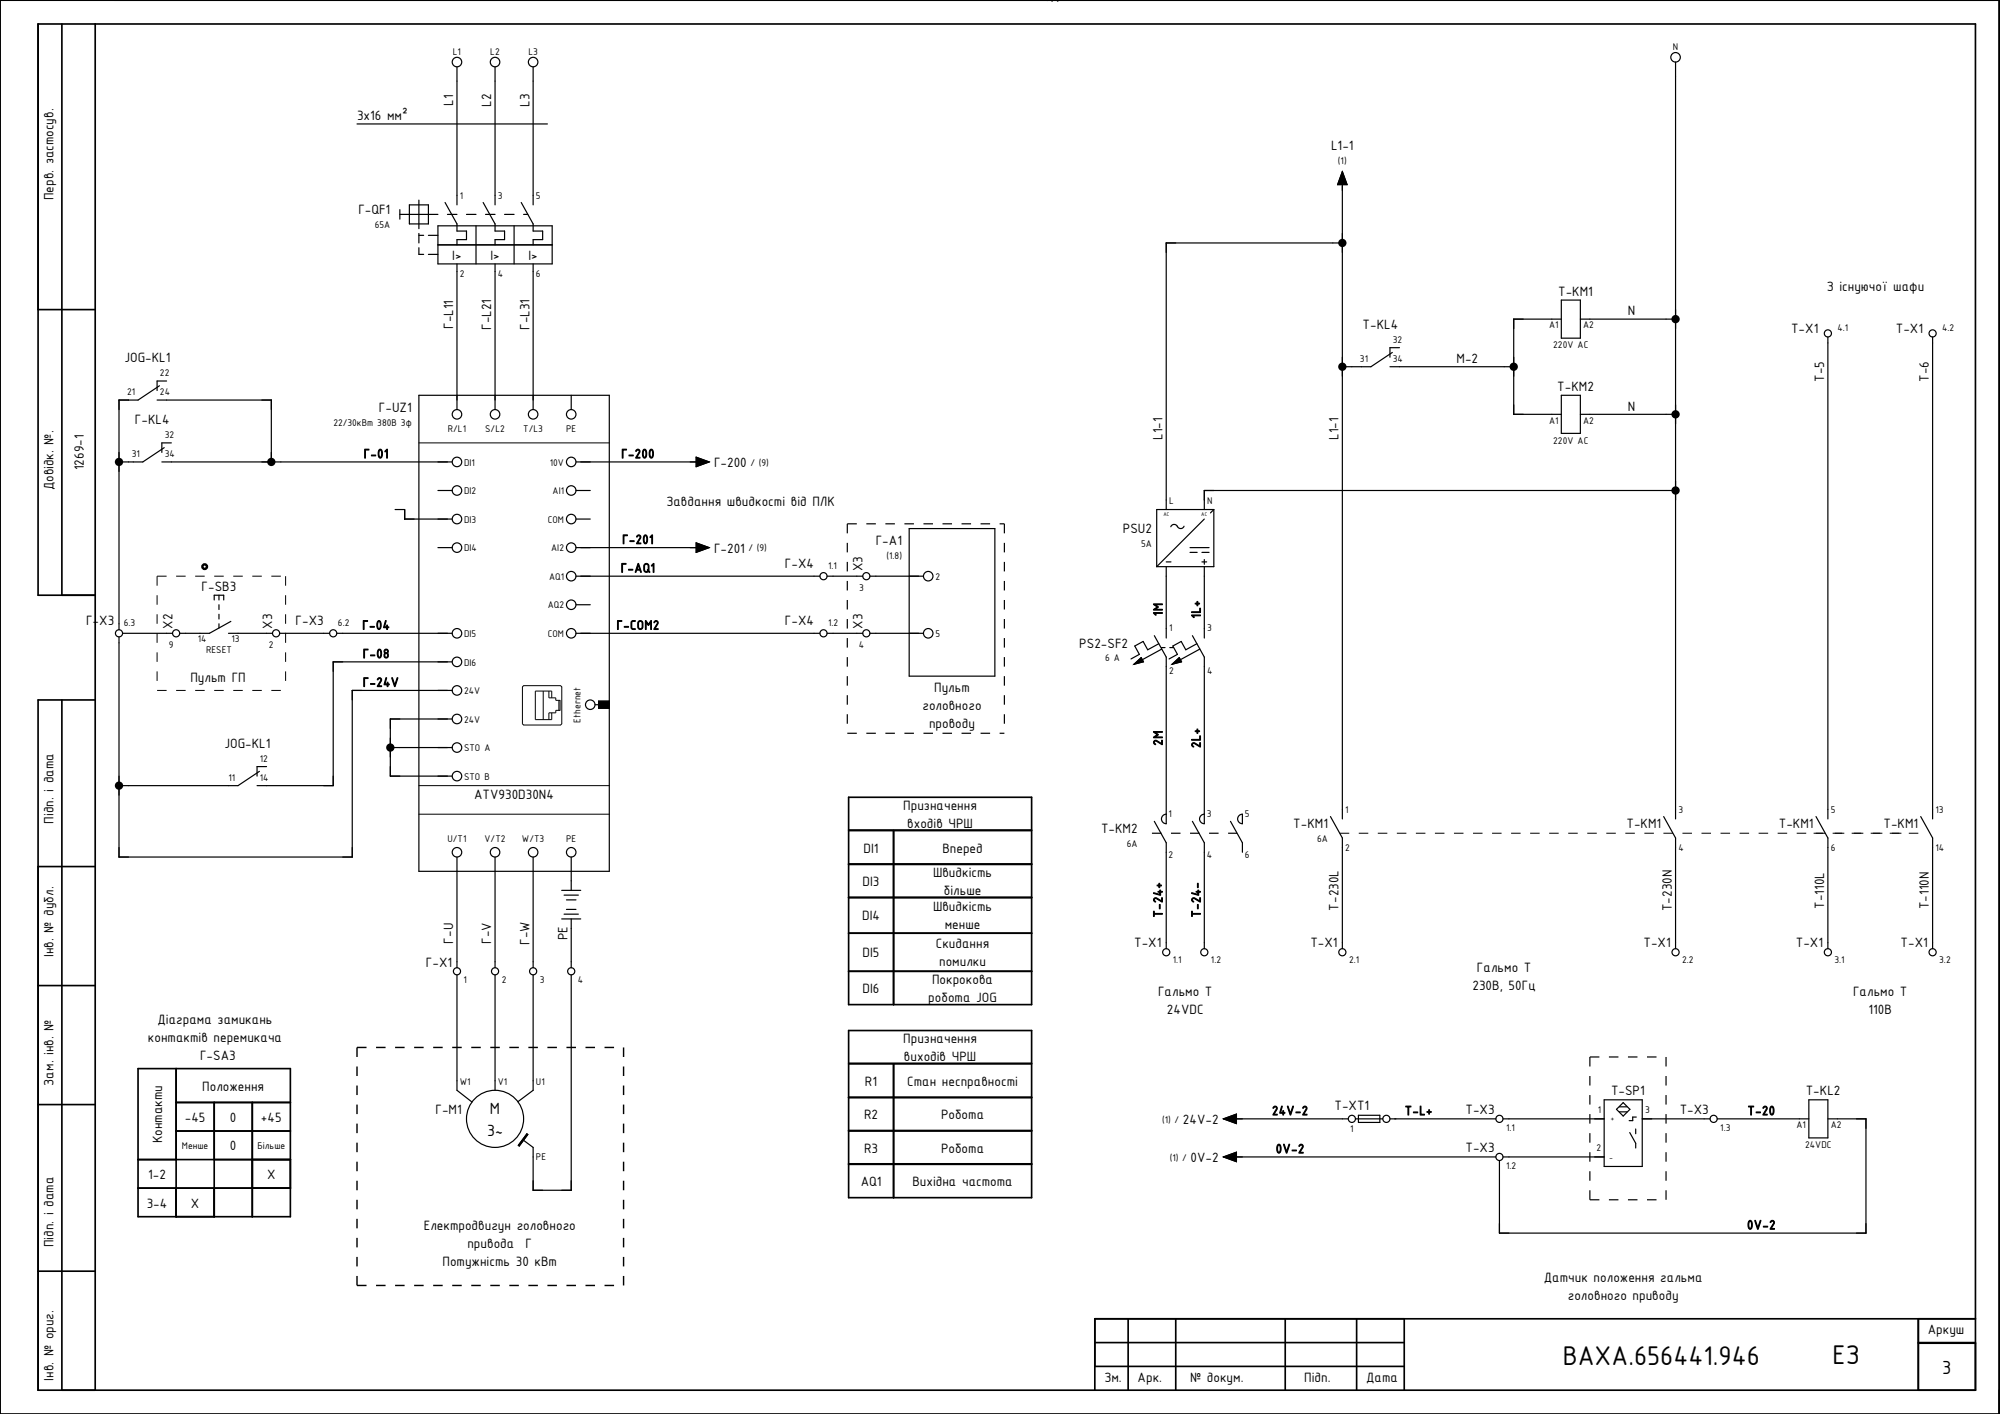
[picture p4: page 3]
Електродвигун головного привода Г Потужність 30 кВт; Гальмо Т; З існуючої шафи; Гальмо Т 24VDC; Призначення входів ЧРШ; Призначення виходів ЧРШ; Робота; Вихідна частота; Діаграма замикань контактів перемикача Г-SA3; Менше; Більше; Пульт головного проводу; Пульт ГП; 3x16 мм²; STO A; COM; 22/30кВт 380В 3ф; ATV930D30N4; Ethernet; ‎Г-COM2 Г-X3; PSU2; RESET; 24VDC; JOG-KL1; STO B

Довідк. №. Перв. застосув. Інв. № ориг. Підп. і дата Зам. інв. № Інв. № дубл. Підп. і дата

Завдання швидкості від ПЛК

DI1 | Вперед

DI3 | Швидкість більше

DI4 | Швидкість менше

DI5 | Скидання помилки

DI6 | Покрокова робота JOG

3-4Контакти | Положення

R1 | Стан несправності

Датчик положення гальма
головного приводу

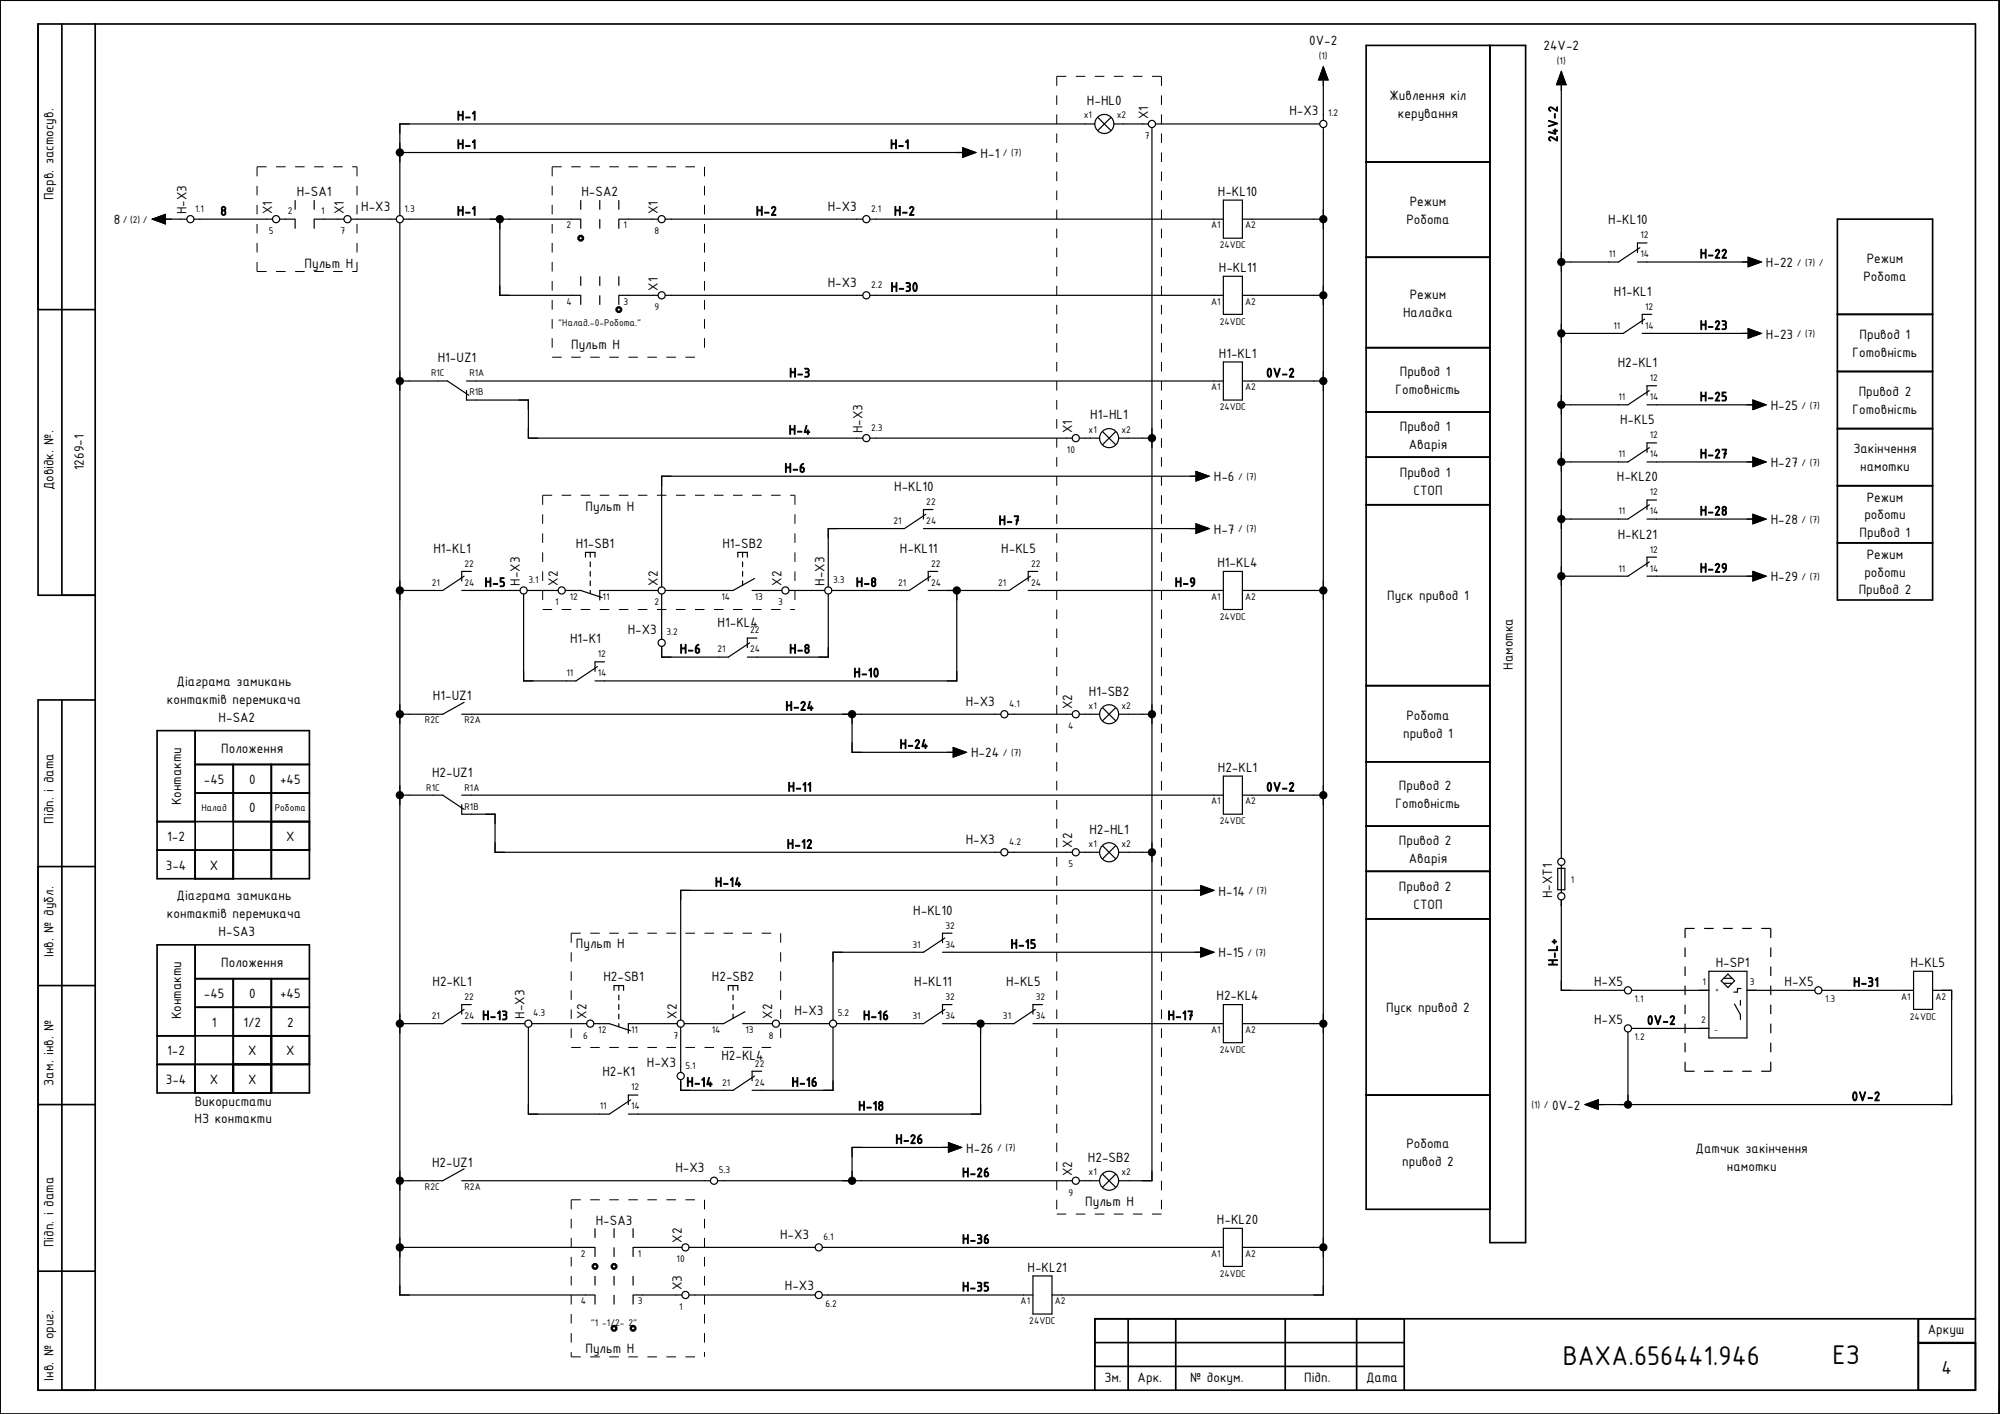
[picture p5: page 4]
Живлення кіл керування; Режим Робота; Привод 1 Готовність; Пуск привод 1; Намотка; Привод 1 Аварія; Робота привод 1; Пуск привод 2; Привод 2 Аварія; Привод 2 Готовність; Робота привод 2; Привод 1 СТОП; Привод 2 СТОП; Діаграма замикань контактів перемикача Н-SA2; Налад; Робота; 3-4Контакти; Положення; Режим Наладка; Датчик закінчення намотки; Закінчення намотки; Пульт Н; Режим роботи Привод 1; Режим роботи Привод 2; Діаграма замикань контактів перемикача Н-SA3; Використати НЗ контакти; 24VDC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

Довідк. №. Перв. застосув. Інв. № ориг. Підп. і дата Зам. інв. № Інв. № дубл. Підп. і дата

3-4Контакти | Положення

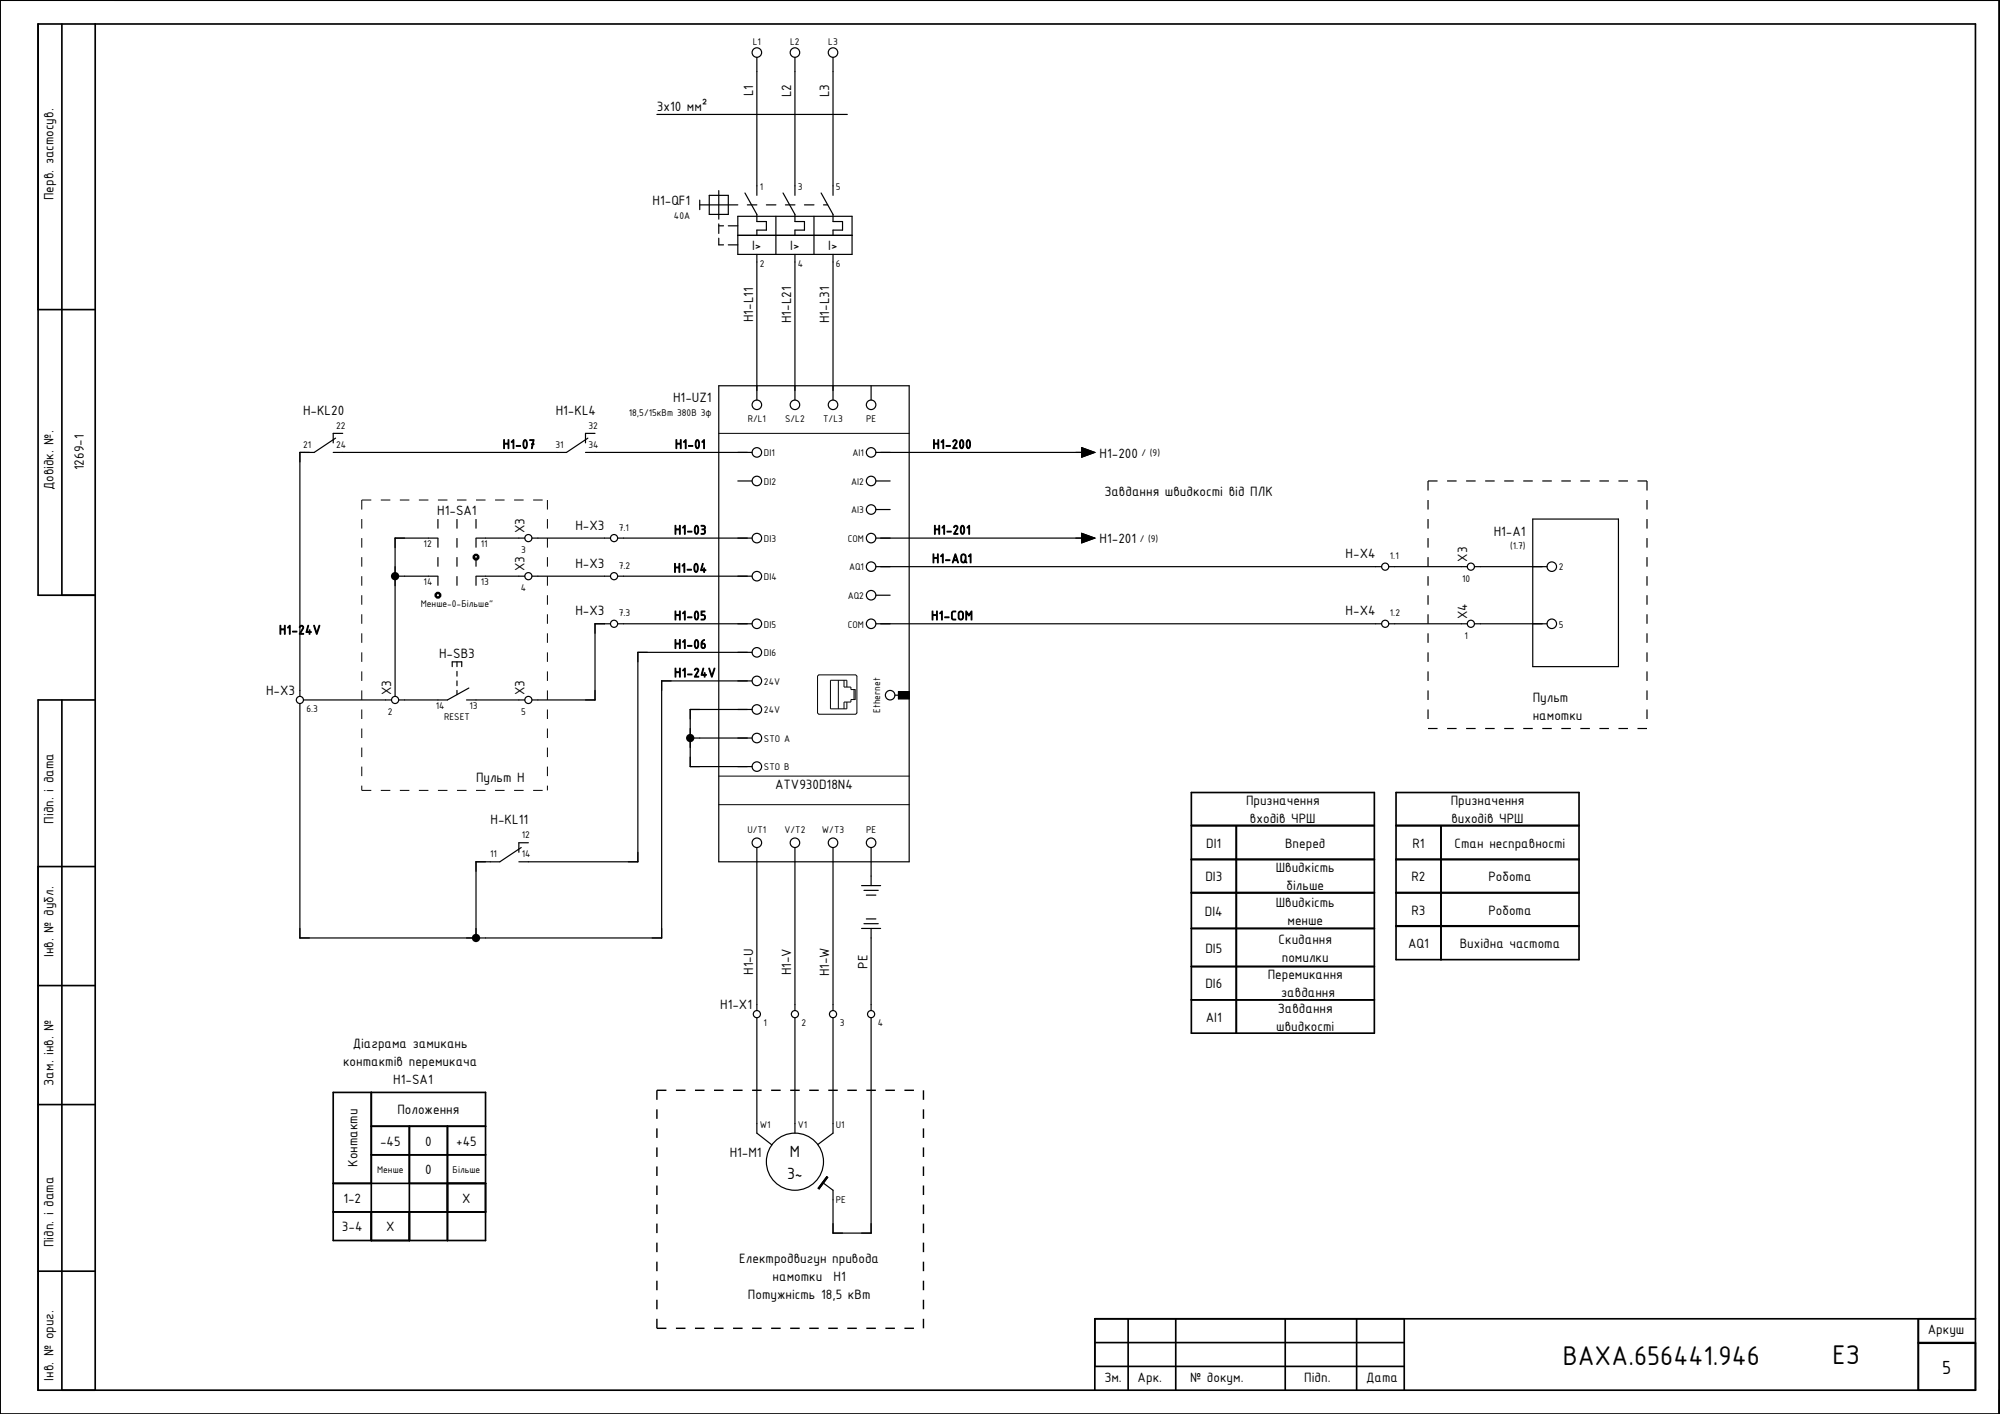
[picture p6: page 5]
Електродвигун привода намотки Н1 Потужність 18,5 кВт; Пульт намотки; Призначення входів ЧРШ; Вперед; Швидкість; менше; Скидання помилки; більше; Призначення виходів ЧРШ; Робота; Стан несправності; Вихідна частота; 3-4Контакти; Положення; Діаграма замикань контактів перемикача Н1-SA1; Пульт Н; 3x10 мм²; COM; 18,5/15кВт 380В 3ф; ATV930D18N4; Ethernet; ‎Н1-COM; Менше-0-Більше"; RESET; STO A; STO B

Довідк. №. Перв. застосув. Інв. № ориг. Підп. і дата Зам. інв. № Інв. № дубл. Підп. і дата

Завдання швидкості від ПЛК

DI6 | Перемикання завдання

AI1 | Завдання швидкості

Менше | | Більше

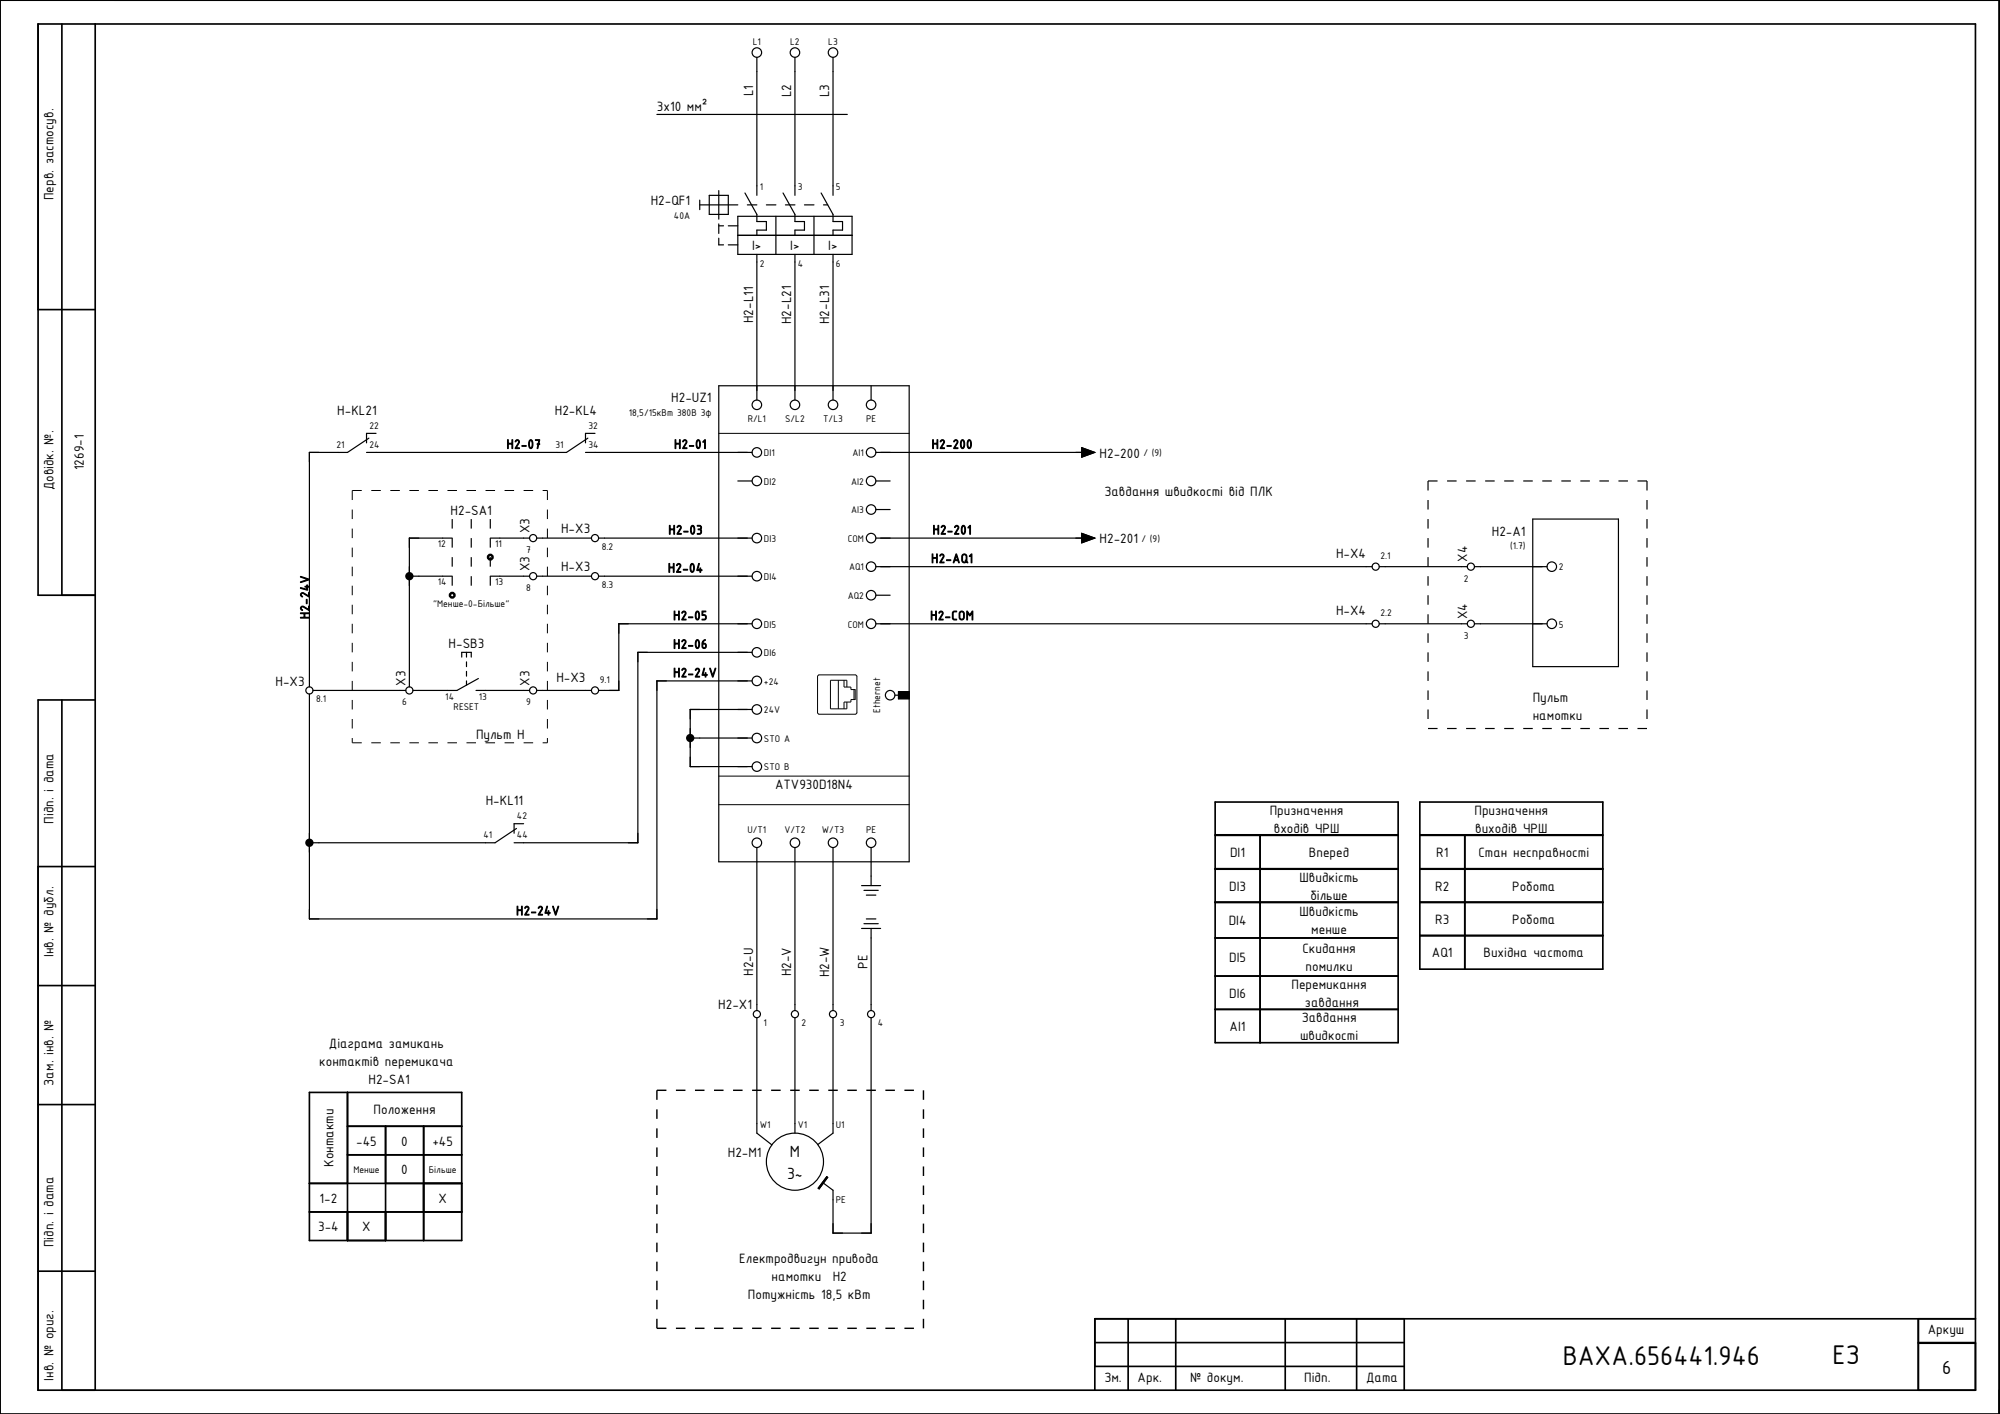
[picture p7: page 6]
Електродвигун привода намотки Н2 Потужність 18,5 кВт; 3-4Контакти; Положення; Діаграма замикань контактів перемикача Н2-SA1; Призначення входів ЧРШ; Вперед; Призначення виходів ЧРШ; Робота; Стан несправності; Вихідна частота; Швидкість; менше; Скидання помилки; більше; Пульт намотки; Пульт Н; 3x10 мм²; COM; 18,5/15кВт 380В 3ф; ATV930D18N4; Ethernet; ‎Н2-COM; "Менше-0-Більше"; RESET; STO A; STO B

Довідк. №. Перв. застосув. Інв. № ориг. Підп. і дата Зам. інв. № Інв. № дубл. Підп. і дата

Завдання швидкості від ПЛК

DI6 | Перемикання завдання

AI1 | Завдання швидкості

Менше | | Більше

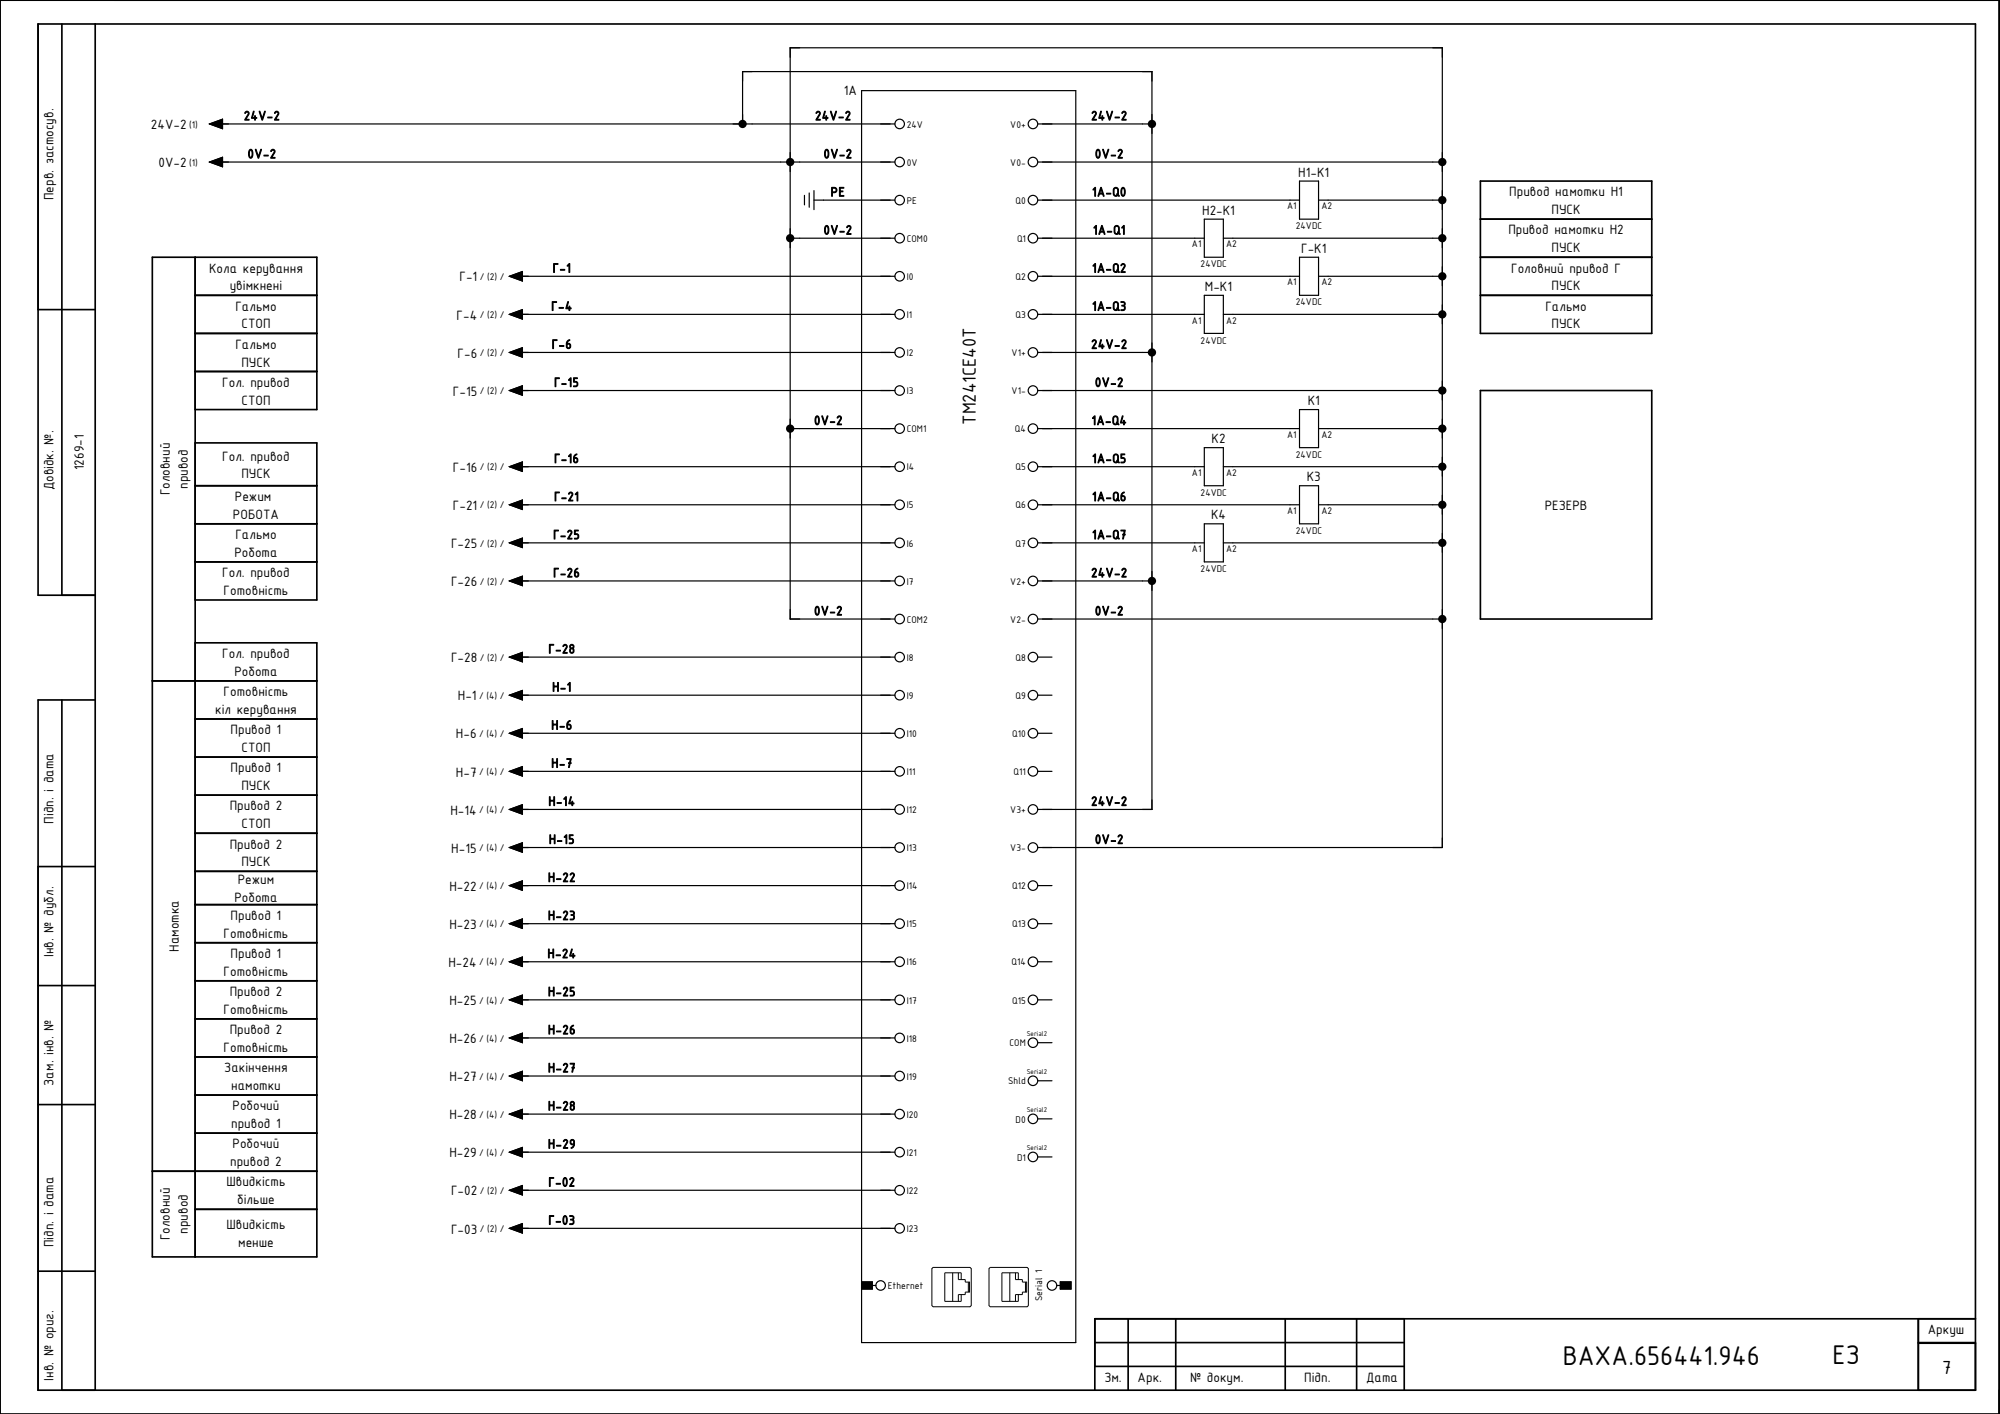
[picture p8: page 7]

Довідк. №. Перв. застосув. Інв. № ориг. Підп. і дата Зам. інв. № Інв. № дубл. Підп. і дата

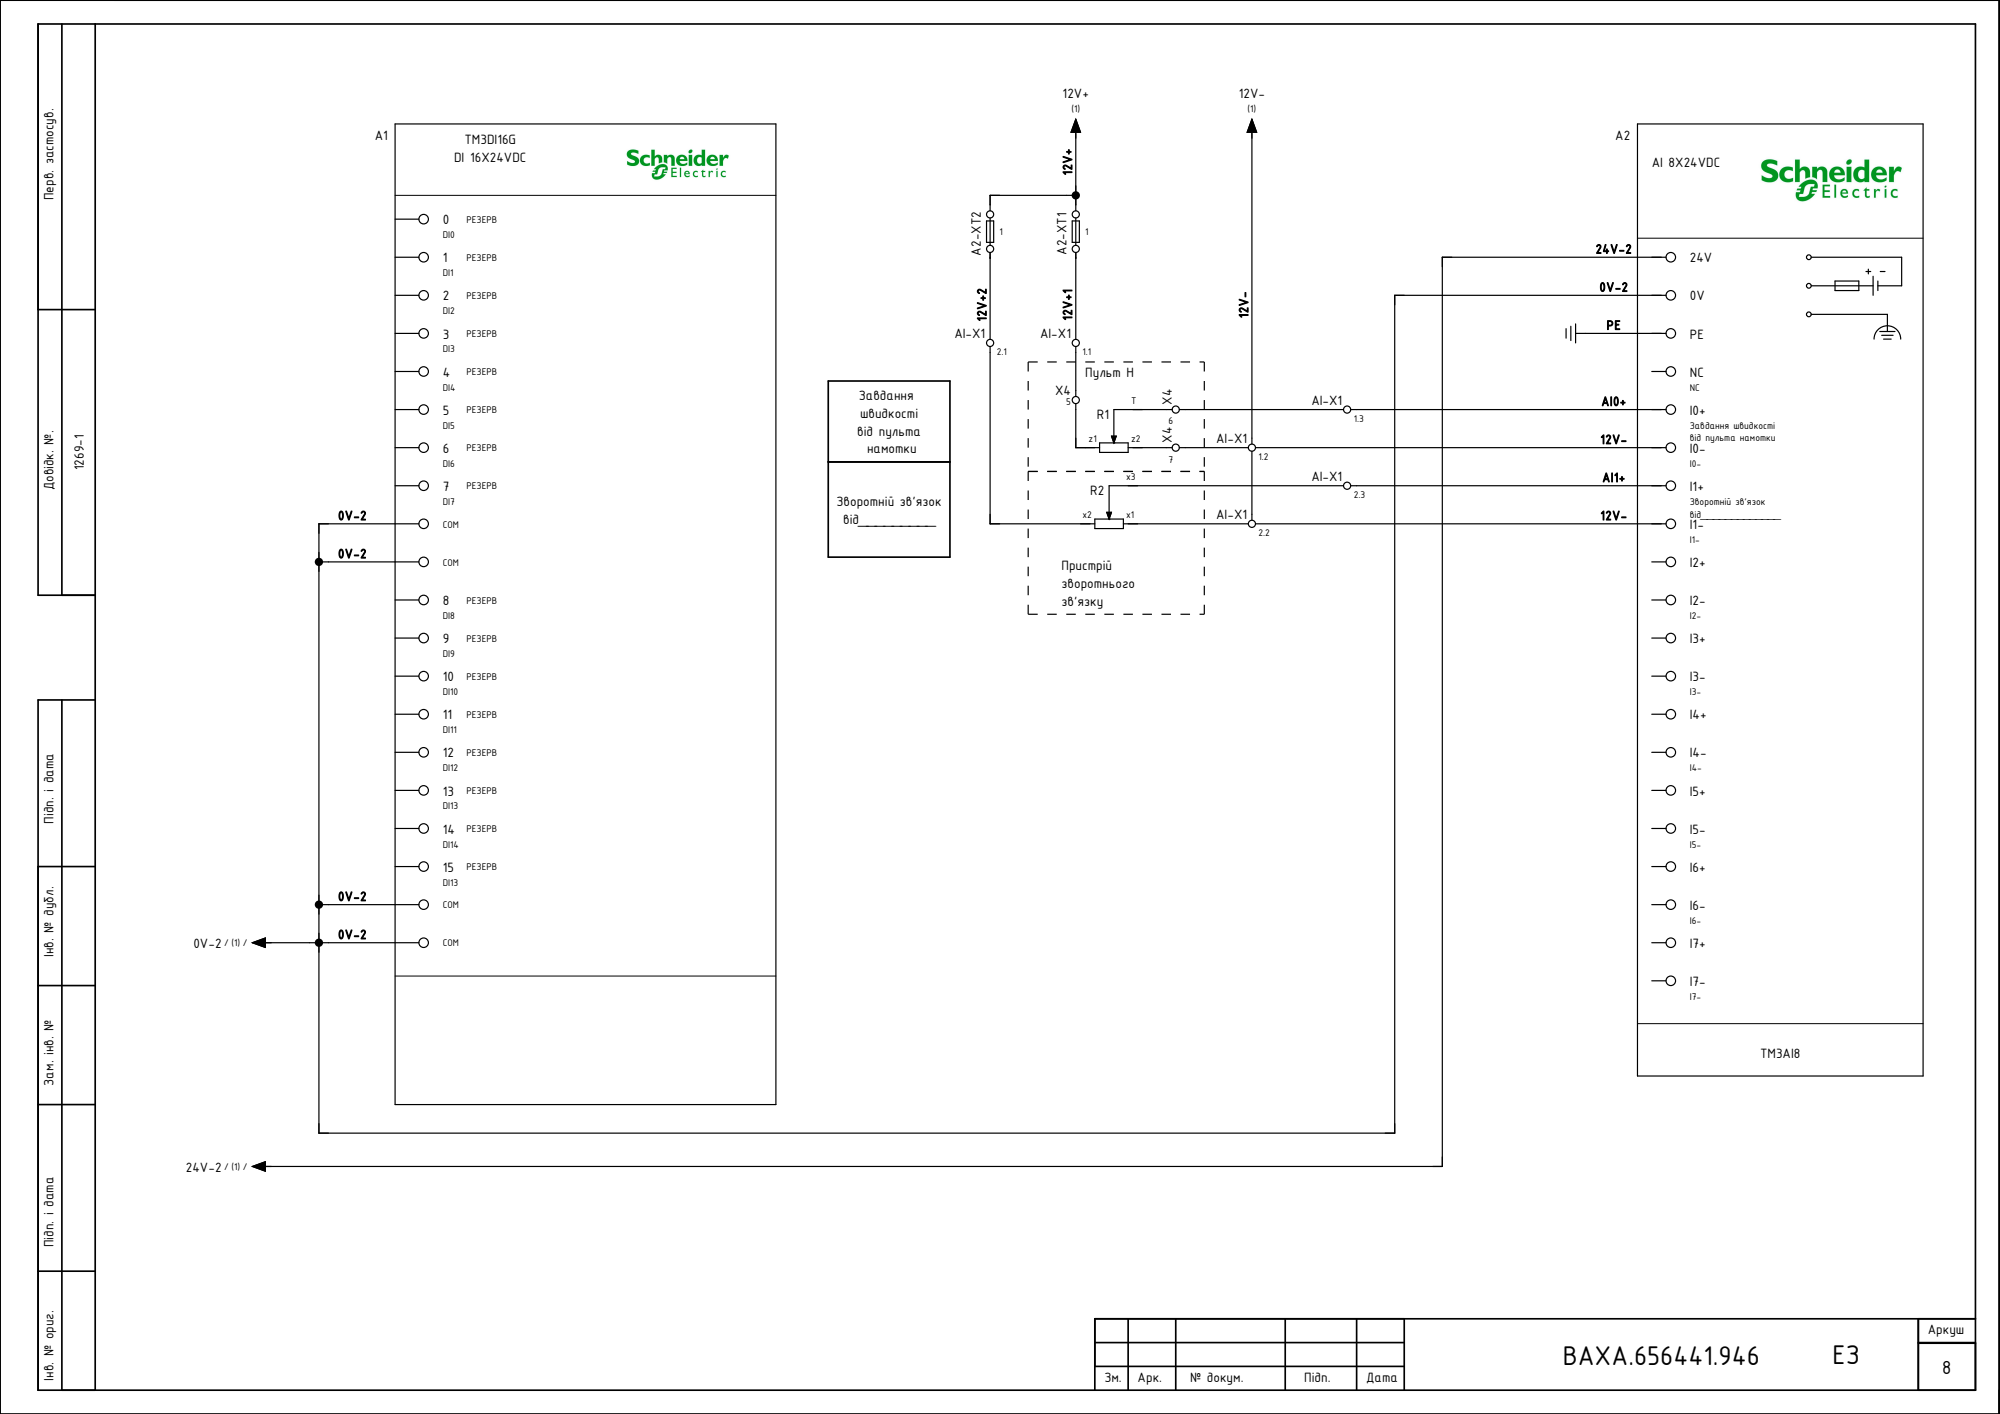
[picture p9: page 8]
AI 8X24VDC; Завдання швидкості від пульта намотки; Пульт Н; Пристрій зворотнього зв'язку; DI 16X24VDC; РЕЗЕРВ; 15 РЕЗЕРВ; COM; COM 8; 10 РЕЗЕРВ; 11 РЕЗЕРВ; 12 РЕЗЕРВ; 13 РЕЗЕРВ; 14 РЕЗЕРВ; Завдання швидкості; від пульта намотки; Зворотній зв'язок; від_____________

Довідк. №. Перв. застосув. Інв. № ориг. Підп. і дата Зам. інв. № Інв. № дубл. Підп. і дата

Зворотній зв'язок
від_________

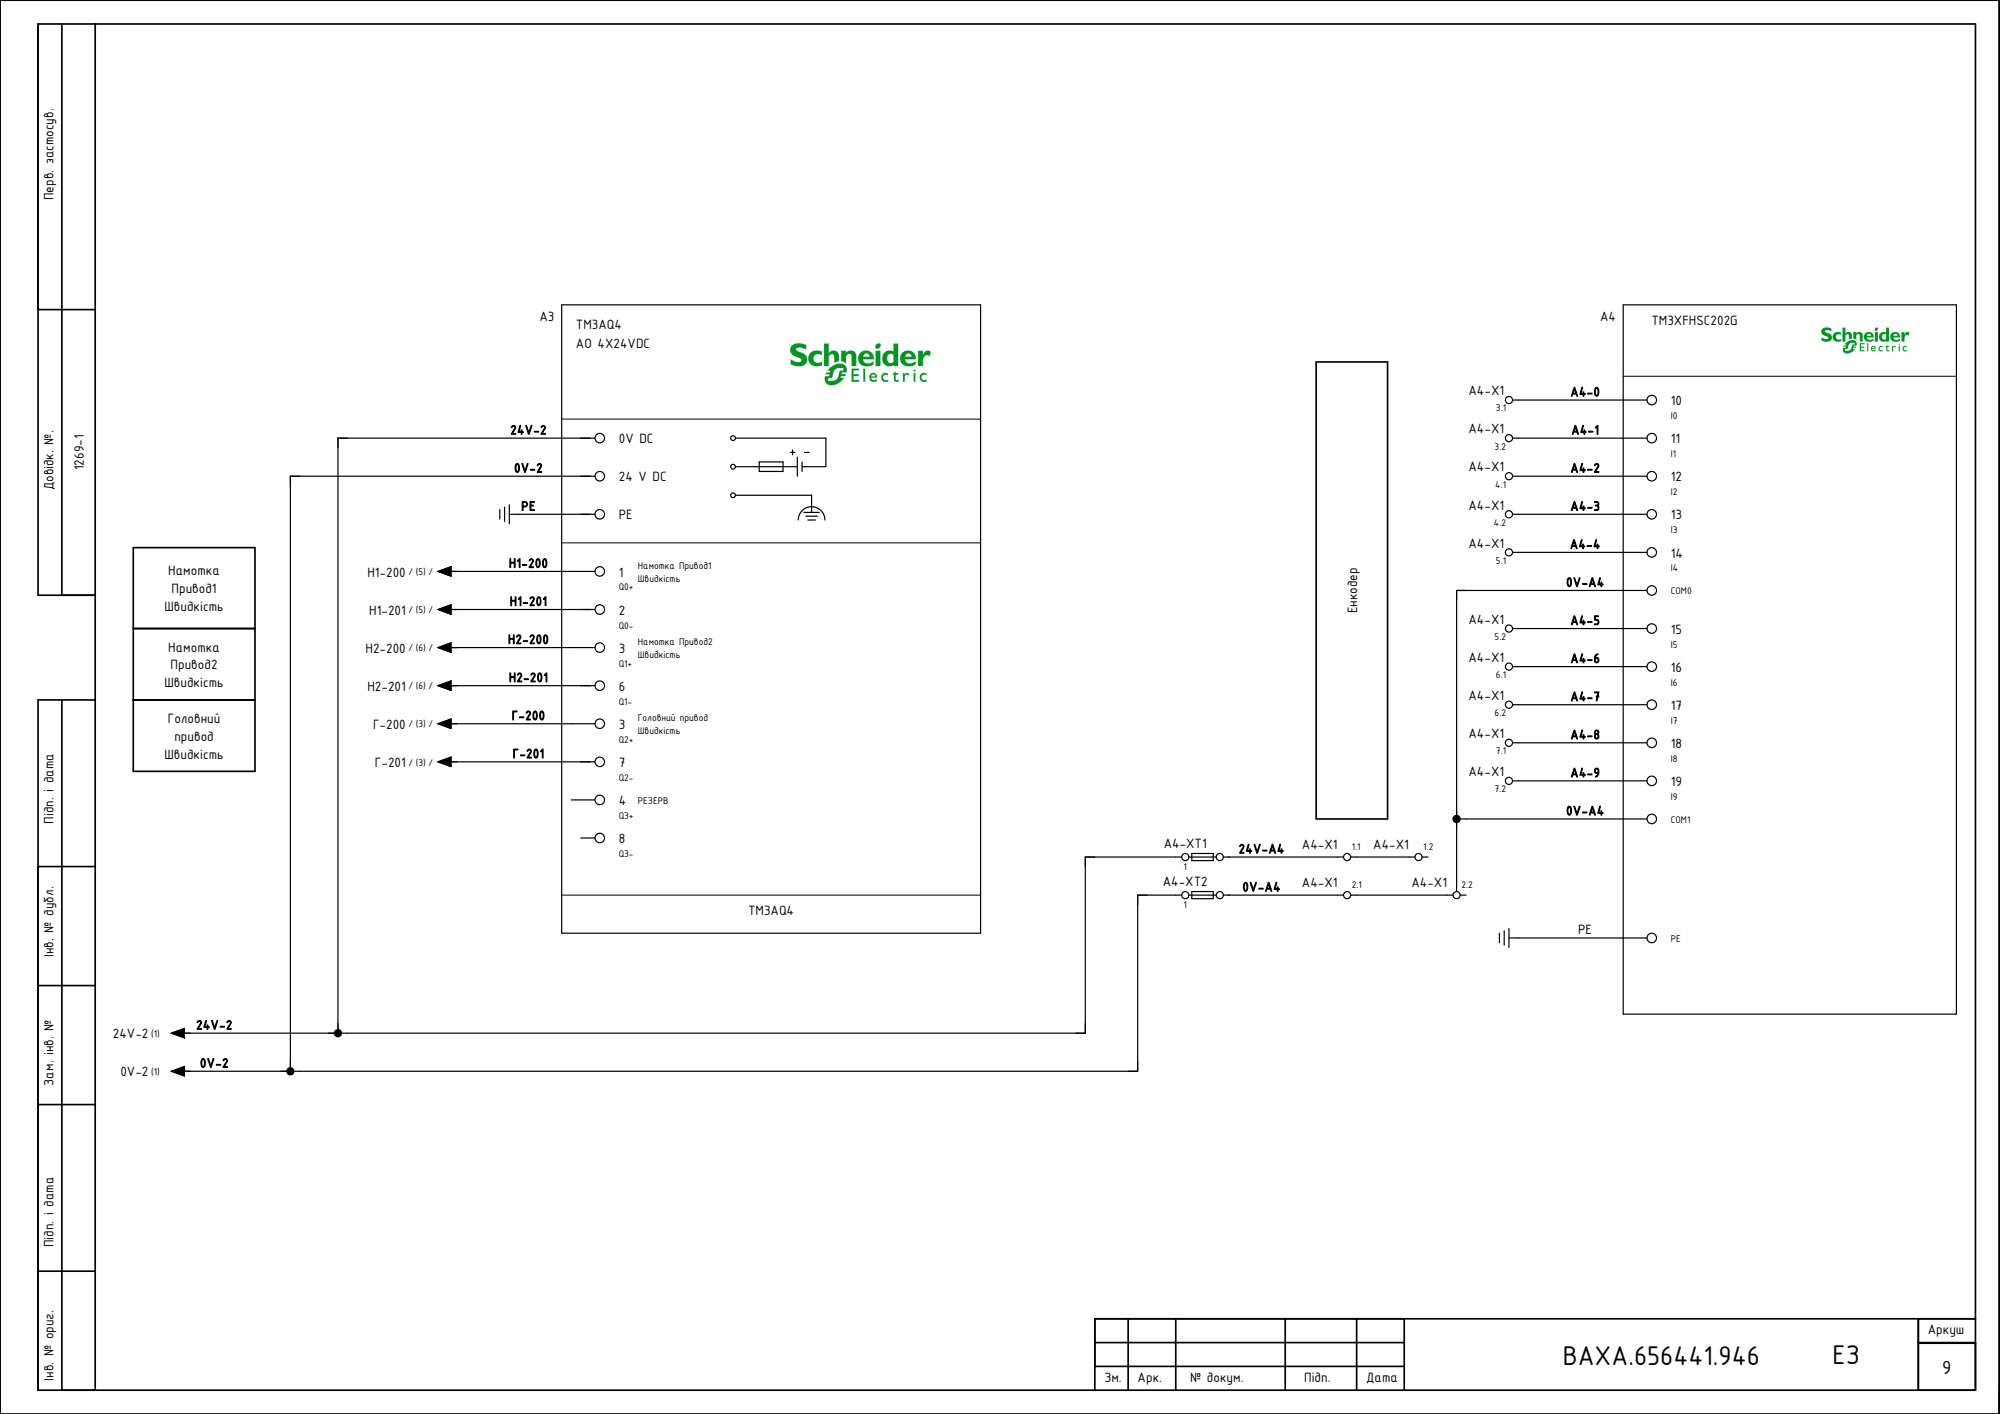
[picture p10: page 9]
AO 4X24VDC; Намотка Привод1 Швидкість; Намотка Привод2 Швидкість; Енкодер; Головний привод Швидкість; TM3XFHSC202G; COM1; COM0; Намотка Привод1; Швидкість; Намотка Привод2; Головний привод; Q2- 4 РЕЗЕРВ

Довідк. №. Перв. застосув. Інв. № ориг. Підп. і дата Зам. інв. № Інв. № дубл. Підп. і дата

### ES-X1

### А4-XT1

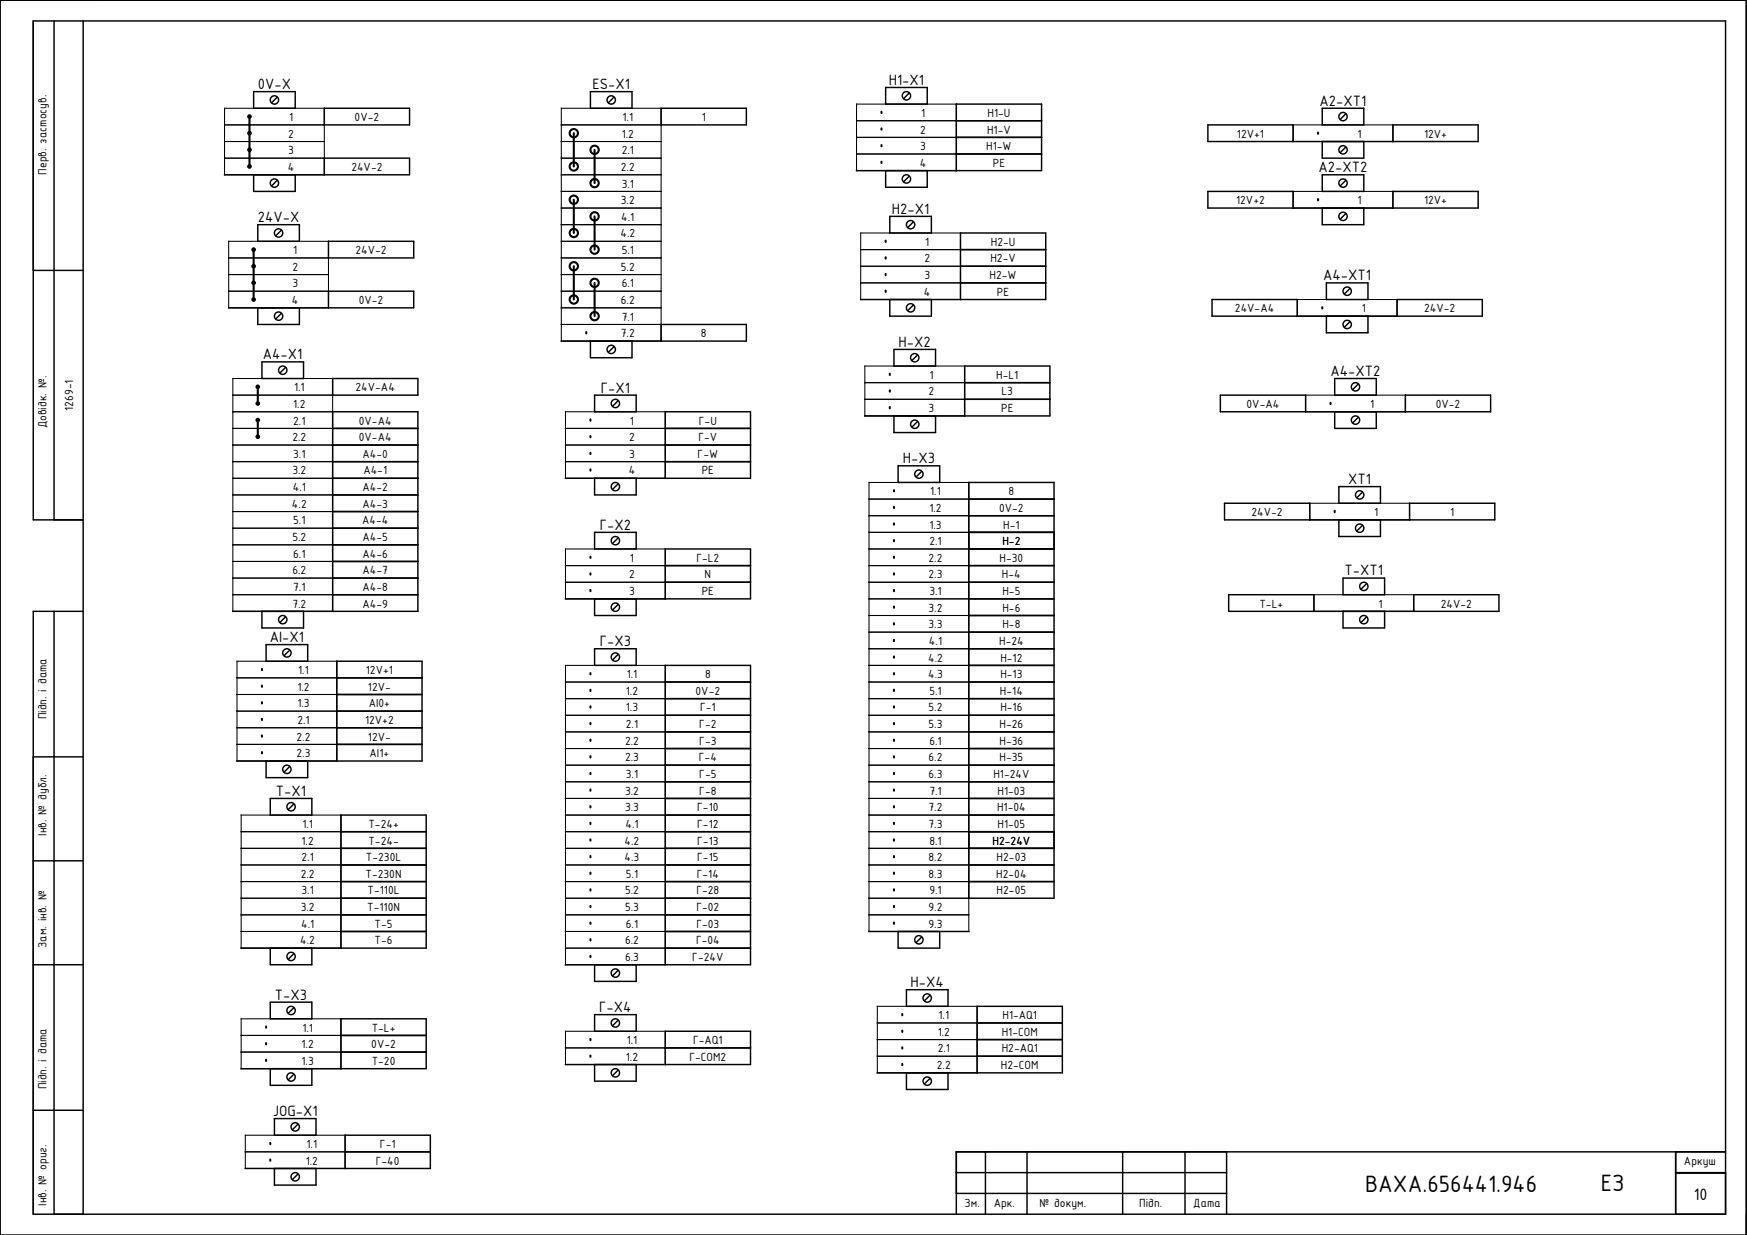
[picture p11: page 10]
Н1-COM; JOG-X1

Довідк. №. Перв. застосув. Інв. № ориг. Підп. і дата Зам. інв. № Інв. № дубл. Підп. і дата

6.2
7.1
7.2 | 8

3.1 | A4-0
3.2 | A4-1
4.1 | A4-2
4.2 | A4-3 | Г-X2
5.1 | A4-4
5.2 | A4-5
6.1 | A4-6
6.2 | A4-7
7.1 | A4-8

1.1 | 8
1.2 | 0V-2
1.3 | Н-1
2.1 | Н-2
2.2 | Н-30

3.1 | Н-5
3.2 | Н-6

4.1 | Н-24
4.2 | Н-12

1.1 | 12V+1
1.2 | 12V-
1.3 | AI0+
2.1 | 12V+2
2.2 | 12V-

1.1 | Г-AQ1
1.2 | Г-COM2

1.3 | Т-20

2.1 | Н2-AQ1
2.2 | Н2-COM

Зм. | Арк. | № докум. | Підп. | Дата
| | Розроб. | Довгаль | | 12.2025 | Шафа управління головним приводом та приводами намотування ФМ ВТ6 Перелік елементів | Літ. | Аркуш | Аркушів
| | Перев. | Довгаль
| | Прийняв
| | Н.контр.
| | Затв. | Довгаль

# ВАХА.656441.946 ПЕ3

Довідк. №. Перв. застосув. Інв. № ориг. Підп. і дата Зам. інв. № Інв. № дубл. Підп. і дата

1269-1

Позиц. познач. | Найменування | Артікул | Кіл-ть | Примітка
| DIN рейка
U29;U31;U34;U36;U39 | DIN-рейка перфорована 35х15 | PFTS35-CF6B | 5 | PROFILATI
U37;U38 | Тримач DIN-рейки TSTW 6/M6 | 0164000000 | 2 | Weidmuller
| Автоматичний вимикач
| Автоматичний вимикач K60N 1P 6A кр.C | A9K02106 | 4 | Schneider Electric M1-SF1;PS1-SF1;Г-SF1;Н-SF1
PS1-SF2;PS2-SF2 | Автоматичний вимикач C60H-DC =500В 6А 2Р кр.С | A9N61526 | 2 | Schneider Electric
| Автоматичний вимикач захисту двигуна
Г-QF1 | Автоматичний вимикач 3Р 65А | GV3L65 | 1 | Schneider Electric
Н1-QF1;Н2-QF1 | Автоматичний вимикач 3Р 40А | GV3L40 | 2 | Schneider Electric
| Апарати диф захисту
QFD1 | Автоматичний вимикач диференціального струму Resi9 10A C 30мА AC | R9D25610 | 1 | Schneider Electric
| Джерела живлення
PSU1;PSU2 | Блок живлення на Din-рейку Mean Well 120вт, 24в, 5А | XDR-120-24 | 2 | Mean Well
PSU3 | Блок живлення Mean Well HDR-15-12 на Din-рейку 15вт, 12в, 1,25А | HDR-15-12 | 1 | Mean Well
| Запобіжники
F1;F2 | Запобіжник CH 10x38 gG 4A 500В ETI | 2651014 | 4 | ETI
| Кабельні канали
U23...U26 | Перфорований кабель-канал 60х80 | ECS6080 | 4 | Elettrocanali
U32;U33;U35;U42 | Перфорований кабель-канал 40х80 | ECS4080 | 5 | Elettrocanali
| Клімат контроль
ET1 | Термостат N/О для вентиляторів | NSYCCOTHO | 1 | Schneider Electric
M1 | Вентилятор с фильтром 262x269x118 261m3, 230V, 29W, 0,8А, (223х223мм) | FULL3000 | 1 | ESEN
M1 | Решітка вентиляційна з фільтром FIL2500 262х269х35мм, (223х223мм) ІР54 | FIL2500 | 1 | ESEN
| Контактори
Т-KM1;Т-KM2 | Контактор 3Р 2,2кВт (6A) 1NO 400V AC-3, кола керування 220V АC | LC1E0610M5 | 2 | Schneider Electric

Довідк. №. Перв. застосув. Інв. № ориг. Підп. і дата Зам. інв. № Інв. № дубл. Підп. і дата

1269-1

ПЕ3

Зм.

1.1

Позиц. познач. | Найменування | Артікул | Кіл-ть | Примітка
| Контактори
| Додатковий блок контактів 2NO+2NC E 09...32 | LAEN22 | 2 | Schneider Electric Т-KM1;Т-KM2
| Логічний контролер
A1 | Модуль TM3 16 вх =24В пружний зажим | TM3DI16G | 1 | Schneider Electric
| Модуль TM3 8 аналогових входів 12біт | TM3AI8 | 1 | Schneider Electric A2
A3 | Модуль TM3 4 аналогових виходів 12біт | TM3AQ4 | 1 | Schneider Electric
A4 | Модуль TM3 швидкісного підрахунку, пружні затиски | TM3XFHSC202G | 1 | Schneider Electric
1A | Базовий блок M241 40 входів/виходів транзисторні, 2 RS485, 1 Eth | TM241CE40T | 1 | Schneider Electric
| Освітлення
EL1 | Світильник LED T5-600-4000K-9W-220V-800L | TNSy5000699 | 1 | TechnoSystems
SQ1 | Кінцевий вимикач 10A | NSYDCM20 | 1 | Schneider Electric
| Реле
K1...K4;M-K1;Г-K1;Н1-K1;Н2-K1 | Релейный модуль PLC-RPT- 24DC/21 | 2900299 | 8 | Phoenix Contact
Г-KL11;Н1-KL1;Н1-KL4;Н2-KL1 Н2-KL4;Н-KL5;Н-KL10;Н-KL11 Н-KL20;Н-KL21;Т-KL2;Т-KL4 | Реле 4CO, 24V DC | 7760056079 | 16 | Weidmuller JOG-KL1;Г-KL1;Г-KL4;Г-KL10
JOG-KL1;Г-KL1;Г-KL4;Г-KL10 Г-KL11;Н1-KL1;Н1-KL4;Н2-KL1 Н2-KL4;Н-KL5;Н-KL10;Н-KL11 Н-KL20;Н-KL21;Т-KL2;Т-KL4 | Маркування ESG 9/26 SCM | 1520980000 | 16 | Weidmuller
JOG-KL1;Г-KL1;Г-KL4;Г-KL10 Г-KL11;Н1-KL1;Н1-KL4;Н2-KL1 Н2-KL4;Н-KL5;Н-KL10;Н-KL11 Н-KL20;Н-KL21;Т-KL2;Т-KL4 | Колодка реле 4CO SCM 4CO | 7760056264 | 16 | Weidmuller
| Розетка на DIN-рейку
XS1 | Розетка 16А 220В | A9A15035 | 1 | Schneider Electric
| Роз’єднувач
F1 | Роз’єднувач EFD10 3P, 32А 10х38 | 2540004 | 1 | ETI
F2 | Роз’єднувач запобіжниківEFD 10 1p 10х38 | 2540001 | 1 | ETI
QS1 | Вимикач навантаження Sirco 250 Ампер | 2600 3026 | 1 | Socomec
QS1 | Подовжувальна штанга для виносного управління для SIRCO 3/4 P для рукоятки S2 320mm | 14001032 | 1 | Socomec
QS1 | Рукоятка виносна чорна тип S2 IP55 | 1421 2111 | 1 | Socomec

Довідк. №. Перв. застосув. Інв. № ориг. Підп. і дата Зам. інв. № Інв. № дубл. Підп. і дата

1269-1

ПЕ3

Зм.

1.2

Позиц. познач. | Найменування | Артікул | Кіл-ть | Примітка
| Сигнальна лампа
HL1...HL3 | Сигнальна лампа 22 мм 230-240В біла | XA2EVM1LC | 3 | Schneider Electric
| Частотний перетворювач
Г-UZ1 | Перетворювач частоти ATV930 30/22кВт 380В 3ф | ATV930D30N4 | 1 | Schneider Electric
Н1-UZ1;Н2-UZ1 | Перетворювач частоти ATV930 18,5/15кВт 380В 3ф | ATV930D18N4 | 2 | Schneider Electric
| Шафа
U1 | Шафа МКК ООКЧП 20104 IP54, 2 двері, зад.ст, рим.б, тяг.зам, кр.люка, покриття (2000x1000x400 мм ВхШхГ) | МКК ООКЧП 20104 | 1 | KONTUR
U17 | A4 кишеня для документації пластик 234x278x40 | NSYDPA44 | 1 | Schneider Electric
U18 | Панель монтажна 2010, для шафи 2000х1000 мм (ВхШ), цинк.(Туреччина) з кріпленням | МП-2010 | 1 | KONTUR
U19 | та покриттям (фланцев плата для шафи 1000х400 мм ШхГ) | ФП-104 | 1 | KONTUR Кришка люка каб.ввода ниж.IP-54 - 10.4 розсувна з кріпл.гумою
U20;U21 | Стінка бічна 204 IP54 з покриттям та кріпленням (для шафи 2000х400 мм ВхГ) | БС-204 | 2 | KONTUR
U22 | Цоколь 200 мм для шафи 1000х400 мм | ЦК-2104 | 1 | KONTUR
U43 | Шафа МКК ООКЧП 20126 IP54, 2 двері, зад.ст, рим.б, тяг.зам, кр.люка, покриття (2000x1200x600 мм ВхШхГ) | МКК ООКЧП 20126 | 1 | KONTUR
U53...U58 | Рейка горизонтальна для шафи Г=600 мм. | бн | 6 | KONTUR
U59 | Панель монтажна 2012, для шафи 2000х1200 мм (ВхШ), цинк.(Туреччина) з кріпленням | МП-2012 | 1 | KONTUR
U60 | Кришка люка каб.ввода ниж.IP-54 - 12.6 розсувна з кріпл.гумою та покриттям (фланцев плата для шафи 1200х600 мм ШхГ) | ФП-126 | 1 | KONTUR
U61 | Стінка бічна 206 IP54 з покриттям та кріпленням (для шафи 2000х600 мм ВхГ) | БС-206 | 1 | KONTUR
U62 | | ЦК-2126 | 1 | KONTUR
| Швеллер перфорований
U40;U41 | Швеллер перфорований, для механічної фіксації кабелів, розміри 30х30 (ШхВ) | Шв.Перф. 30х30 | 2 | KONTUR
| Шина
PE | Шина мідна 25х5 (433А) | | 1

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

# ВАХА.656441.946 ПЕ3(К)

Довідк. №. Перв. застосув. Інв. № ориг. Підп. і дата Зам. інв. № Інв. № дубл. Підп. і дата

1269-1

Найменування | Артікул | Кіл-ть | Примітка

0V-X

Кінцевий стопор CLIPFIX 35-9,5мм | 3022218 | 1 | Phoenix Contact
Тримач маркування KLM 3 | 0811969 | 1 | Phoenix Contact
Прохідна клемма, гвинтові зажими, 2.5 mm², колір сірий | 3044076 | 4 | Phoenix Contact
Кінцева пластина D-UT 2,5/10 | 3047028 | 1 | Phoenix Contact
| | 24V-X
Кінцевий стопор CLIPFIX 35-9,5мм | 3022218 | 1 | Phoenix Contact
Тримач маркування KLM 3 | 0811969 | 1 | Phoenix Contact
Прохідна клемма, гвинтові зажими, 2.5 mm², колір сірий | 3044076 | 4 | Phoenix Contact
Кінцева пластина D-UT 2,5/10 | 3047028 | 1 | Phoenix Contact
Кінцевий стопор CLIPFIX 35-9,5мм | 3022218 | 1 | Phoenix Contact
Тримач маркування KLM 3 | 0811969 | 1 | Phoenix Contact
Двохярусна прохідна клемма PTTB2,5 колір сірий | 3210567 | 7 | Phoenix Contact
Кінцева пластина D-PTTB 2,5 | 3211634 | 1 | Phoenix Contact
Кінцевий стопор CLIPFIX 35-9,5мм | 3022218 | 1 | Phoenix Contact
Тримач маркування KLM 3 | 0811969 | 1 | Phoenix Contact
Прохідна клемма, гвинтові зажими, 2.5 mm², колір сірий | 3044076 | 2 | Phoenix Contact
Клема для захисного дроту, гвинтові зажими, 2.5 mm², колір жовто-зелений | 3044092 | 1 | Phoenix Contact
Кінцева пластина D-UT 2,5/10 | 3047028 | 1 | Phoenix Contact

Н-X2

Г-X2

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

A4-X1

Довідк. №. Перв. застосув. Інв. № ориг. Підп. і дата Зам. інв. № Інв. № дубл. Підп. і дата

1269-1

# ПЕ3(К)

Зм.

1.1

Артікул | Кіл-ть | Примітка Найменування

AI-X1

Кінцевий стопор CLIPFIX 35-9,5мм | 3022218 | 1 | Phoenix Contact
Тримач маркування KLM 3 | 0811969 | 1 | Phoenix Contact
Триярусна прохідна клемми PT 2,5-3L 2.5 mm², | 3210499 | 2 | Phoenix Contact
Кінцева пластина D-PT 2,5-3L | 3211647 | 1 | Phoenix Contact
| | А2-XT1
Клема для встановлення запобіжників 5X20 | 3046032 | 1 | Phoenix Contact
Запобіжник CH 5x20 F 100mA 250V | 6710009 | 1 | ETI
Клема для встановлення запобіжників 5X20 | 3046032 | 1 | Phoenix Contact
Запобіжник CH 5x20 F 100mA 250V | 6710009 | 1 | ETI
Кінцевий стопор CLIPFIX 35-9,5мм | 3022218 | 1 | Phoenix Contact
Тримач маркування KLM 3 | 0811969 | 1 | Phoenix Contact
Триярусна прохідна клемми PT 2,5-3L 2.5 mm², | 3210499 | 1 | Phoenix Contact
Кінцева пластина D-PT 2,5-3L | 3211647 | 1 | Phoenix Contact
Клема для встановлення запобіжників 5X20 | 3046032 | 1 | Phoenix Contact
Запобіжник CH 5x20 F 100mA 250V | 6710009 | 1 | ETI
Кінцевий стопор CLIPFIX 35-9,5мм | 3022218 | 1 | Phoenix Contact
Тримач маркування KLM 3 | 0811969 | 1 | Phoenix Contact
Двохярусна прохідна клемма PTTB2,5 колір сірий | 3210567 | 4 | Phoenix Contact
Кінцева пластина D-PTTB 2,5 | 3211634 | 1 | Phoenix Contact

А4-XT1

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

А2-XT2

Клема для встановлення запобіжників 5X20 | 3046032 | 1 | Phoenix Contact
Запобіжник CH 5x20 F 2А 250V | 6710031 | 1 | ETI

А4-XT2

Т-X1

Т-X3

Т-XT1

Довідк. №. Перв. застосув. Інв. № ориг. Підп. і дата Зам. інв. № Інв. № дубл. Підп. і дата

1269-1

# ПЕ3(К)

Зм.

1.2

Артікул | Кіл-ть | Примітка Найменування

ES-X1

Кінцевий стопор CLIPFIX 35-9,5мм | 3022218 | 1 | Phoenix Contact
Тримач маркування KLM 3 | 0811969 | 1 | Phoenix Contact
Двохярусна прохідна клемма PTTB2,5 колір сірий | 3210567 | 7 | Phoenix Contact
Кінцева пластина D-PTTB 2,5 | 3211634 | 1 | Phoenix Contact
| | JOG-X1
Кінцевий стопор CLIPFIX 35-9,5мм | 3022218 | 1 | Phoenix Contact
Тримач маркування KLM 3 | 0811969 | 1 | Phoenix Contact
Двохярусна прохідна клемма PTTB2,5 колір сірий | 3210567 | 1 | Phoenix Contact
Кінцева пластина D-PTTB 2,5 | 3211634 | 1 | Phoenix Contact
Кінцевий стопор CLIPFIX 35-9,5мм | 3022218 | 1 | Phoenix Contact
Тримач маркування KLM 3 | 0811969 | 1 | Phoenix Contact
Прохідна клемма, гвинтове з'єднання, 16 mm², 1000 V, 76 A, Темно-бежевый | 1020400000 | 3 | Weidmuller
Клемма заземлення, гвинтове з'єднання, 16 mm² | 1010400000 | 1 | Weidmuller
Кінцевий стопор CLIPFIX 35-9,5мм | 3022218 | 1 | Phoenix Contact
Тримач маркування KLM 3 | 0811969 | 1 | Phoenix Contact
Триярусна прохідна клемми PT 2,5-3L 2.5 mm², | 3210499 | 6 | Phoenix Contact
Кінцева пластина D-PT 2,5-3L | 3211647 | 1 | Phoenix Contact
Кінцевий стопор CLIPFIX 35-9,5мм | 3022218 | 1 | Phoenix Contact
Тримач маркування KLM 3 | 0811969 | 1 | Phoenix Contact
Двохярусна прохідна клемма PTTB2,5 колір сірий | 3210567 | 1 | Phoenix Contact
Кінцева пластина D-PTTB 2,5 | 3211634 | 1 | Phoenix Contact
Клема для встановлення запобіжників 5X20 | 3046032 | 1 | Phoenix Contact
Запобіжник CH 5x20 F 2А 250V | 6710031 | 1 | ETI
Кінцевий стопор CLIPFIX 35-9,5мм | 3022218 | 1 | Phoenix Contact
Тримач маркування KLM 3 | 0811969 | 1 | Phoenix Contact

Г-X1

Г-X3

Г-X4

Н1-X1

XT1

Довідк. №. Перв. застосув. Інв. № ориг. Підп. і дата Зам. інв. № Інв. № дубл. Підп. і дата

1269-1

# ПЕ3(К)

Зм.

1.3

Артікул | Кіл-ть | Примітка Найменування

Н1-X1

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

Н2-X1

Н-X3

Кінцевий стопор CLIPFIX 35-9,5мм | 3022218 | 1 | Phoenix Contact
Тримач маркування KLM 3 | 0811969 | 1 | Phoenix Contact
Триярусна прохідна клемми PT 2,5-3L 2.5 mm², | 3210499 | 9 | Phoenix Contact
Кінцева пластина D-PT 2,5-3L | 3211647 | 1 | Phoenix Contact

Н-X4

Кінцевий стопор CLIPFIX 35-9,5мм | 3022218 | 1 | Phoenix Contact
Тримач маркування KLM 3 | 0811969 | 1 | Phoenix Contact
Двохярусна прохідна клемма PTTB2,5 колір сірий | 3210567 | 2 | Phoenix Contact
Кінцева пластина D-PTTB 2,5 | 3211634 | 1 | Phoenix Contact

Н-X5

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

Н-XT1

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

## Кіл. Номер рамки 1

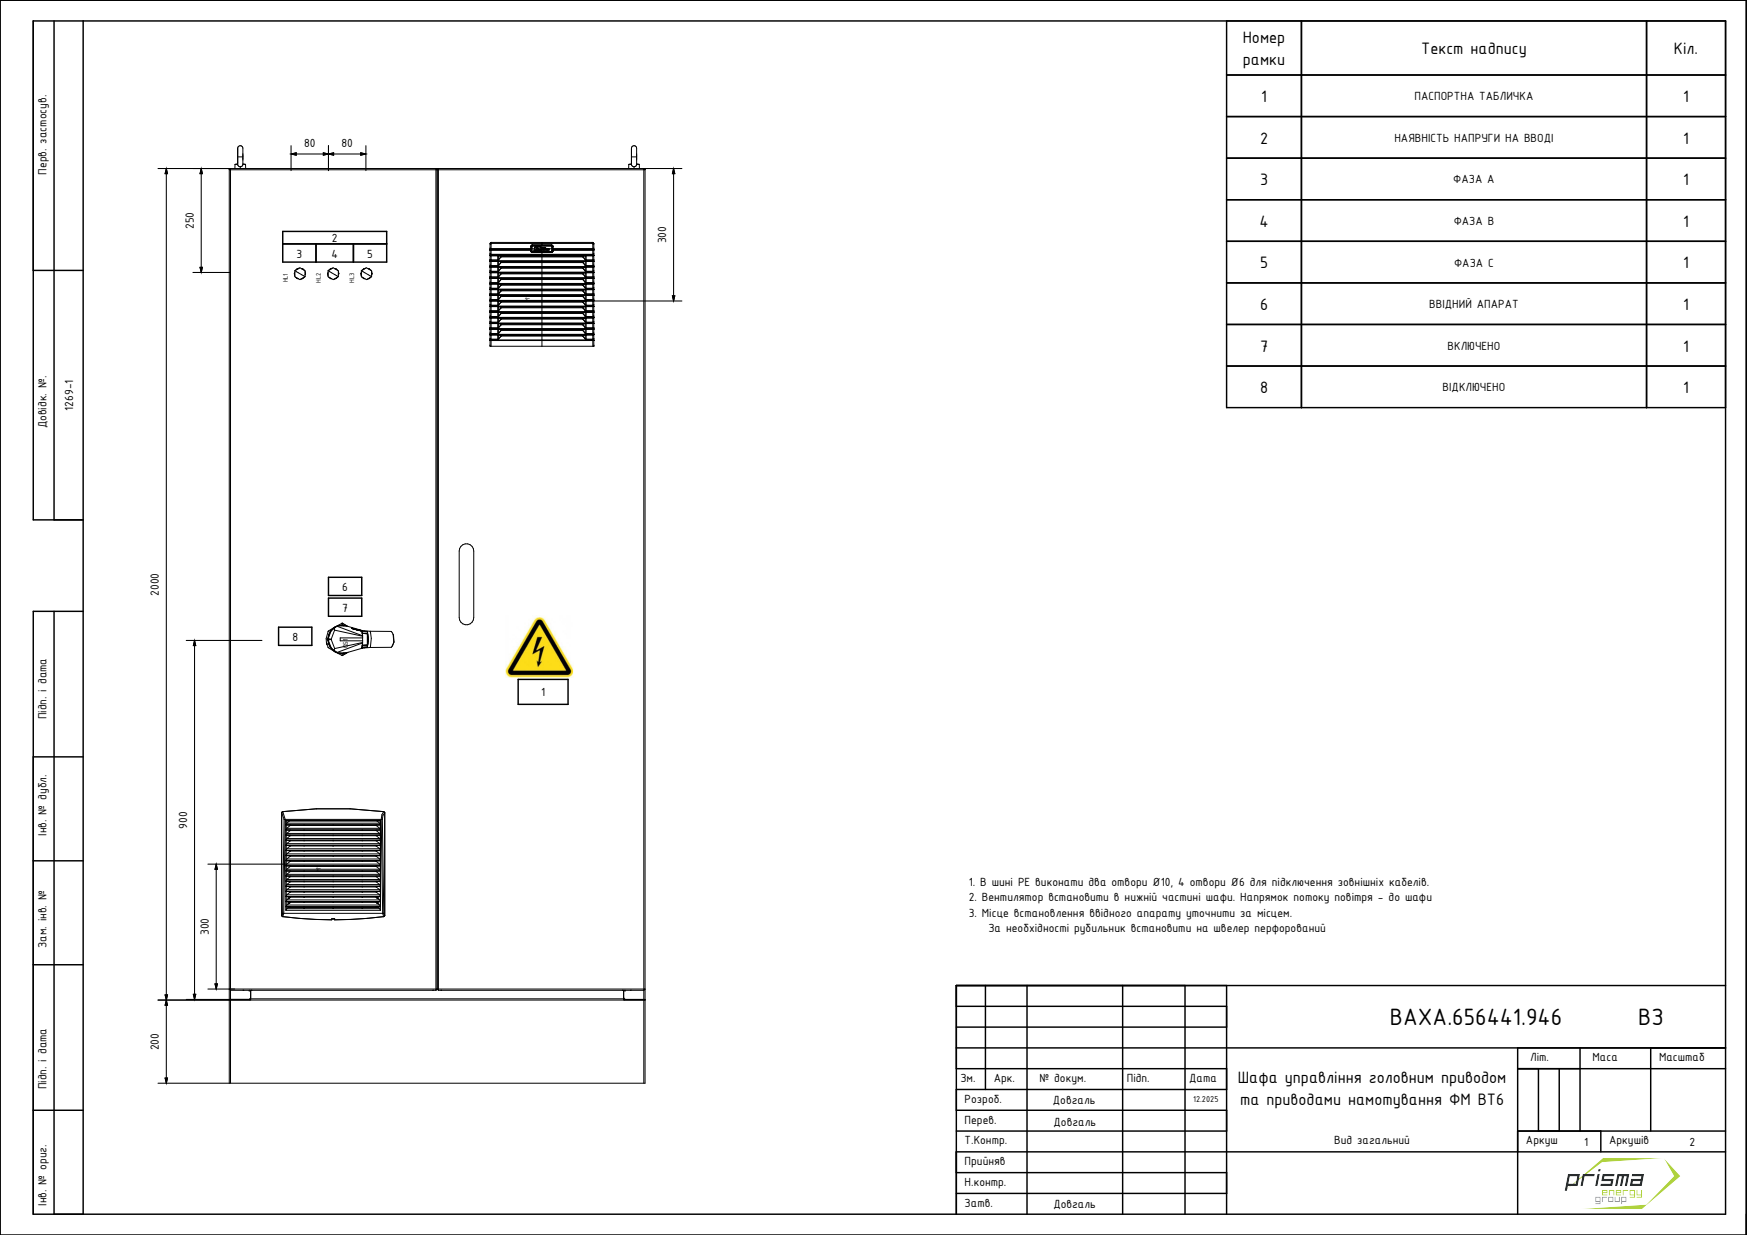
[picture p12: page 18]
Текст надпису; ПАСПОРТНА ТАБЛИЧКА; НАЯВНІСТЬ НАПРУГИ НА ВВОДІ; ФАЗА А; ФАЗА В; ВВІДНИЙ АПАРАТ; ВКЛЮЧЕНО; ВІДКЛЮЧЕНО; ФАЗА С

Довідк. №. Перв. застосув. Інв. № ориг. Підп. і дата Зам. інв. № Інв. № дубл. Підп. і дата

1. В шині РЕ виконати два отвори Ø10, 4 отвори Ø6 для підключення зовнішніх кабелів.
2. Вентилятор встановити в нижній частині шафи. Напрямок потоку повітря - до шафи
3. Місце встановлення ввідного апарату уточнити за місцем.
За необхідності рубильник встановити на швелер перфорований

ВАХА.656441.946 ВЗ

Шафа управління головним приводом та приводами намотування ФМ ВТ6 Вид загальний | Літ. | Маса | Масштаб

Зм. | Арк. | № докум. | Підп. | Дата
Розроб. | | Довгаль | | 12.2025
Перев. | | Довгаль
Т.Контр. | | | | | Аркуш | Аркушів
Прийняв
Н.контр.
Затв. | Довгаль

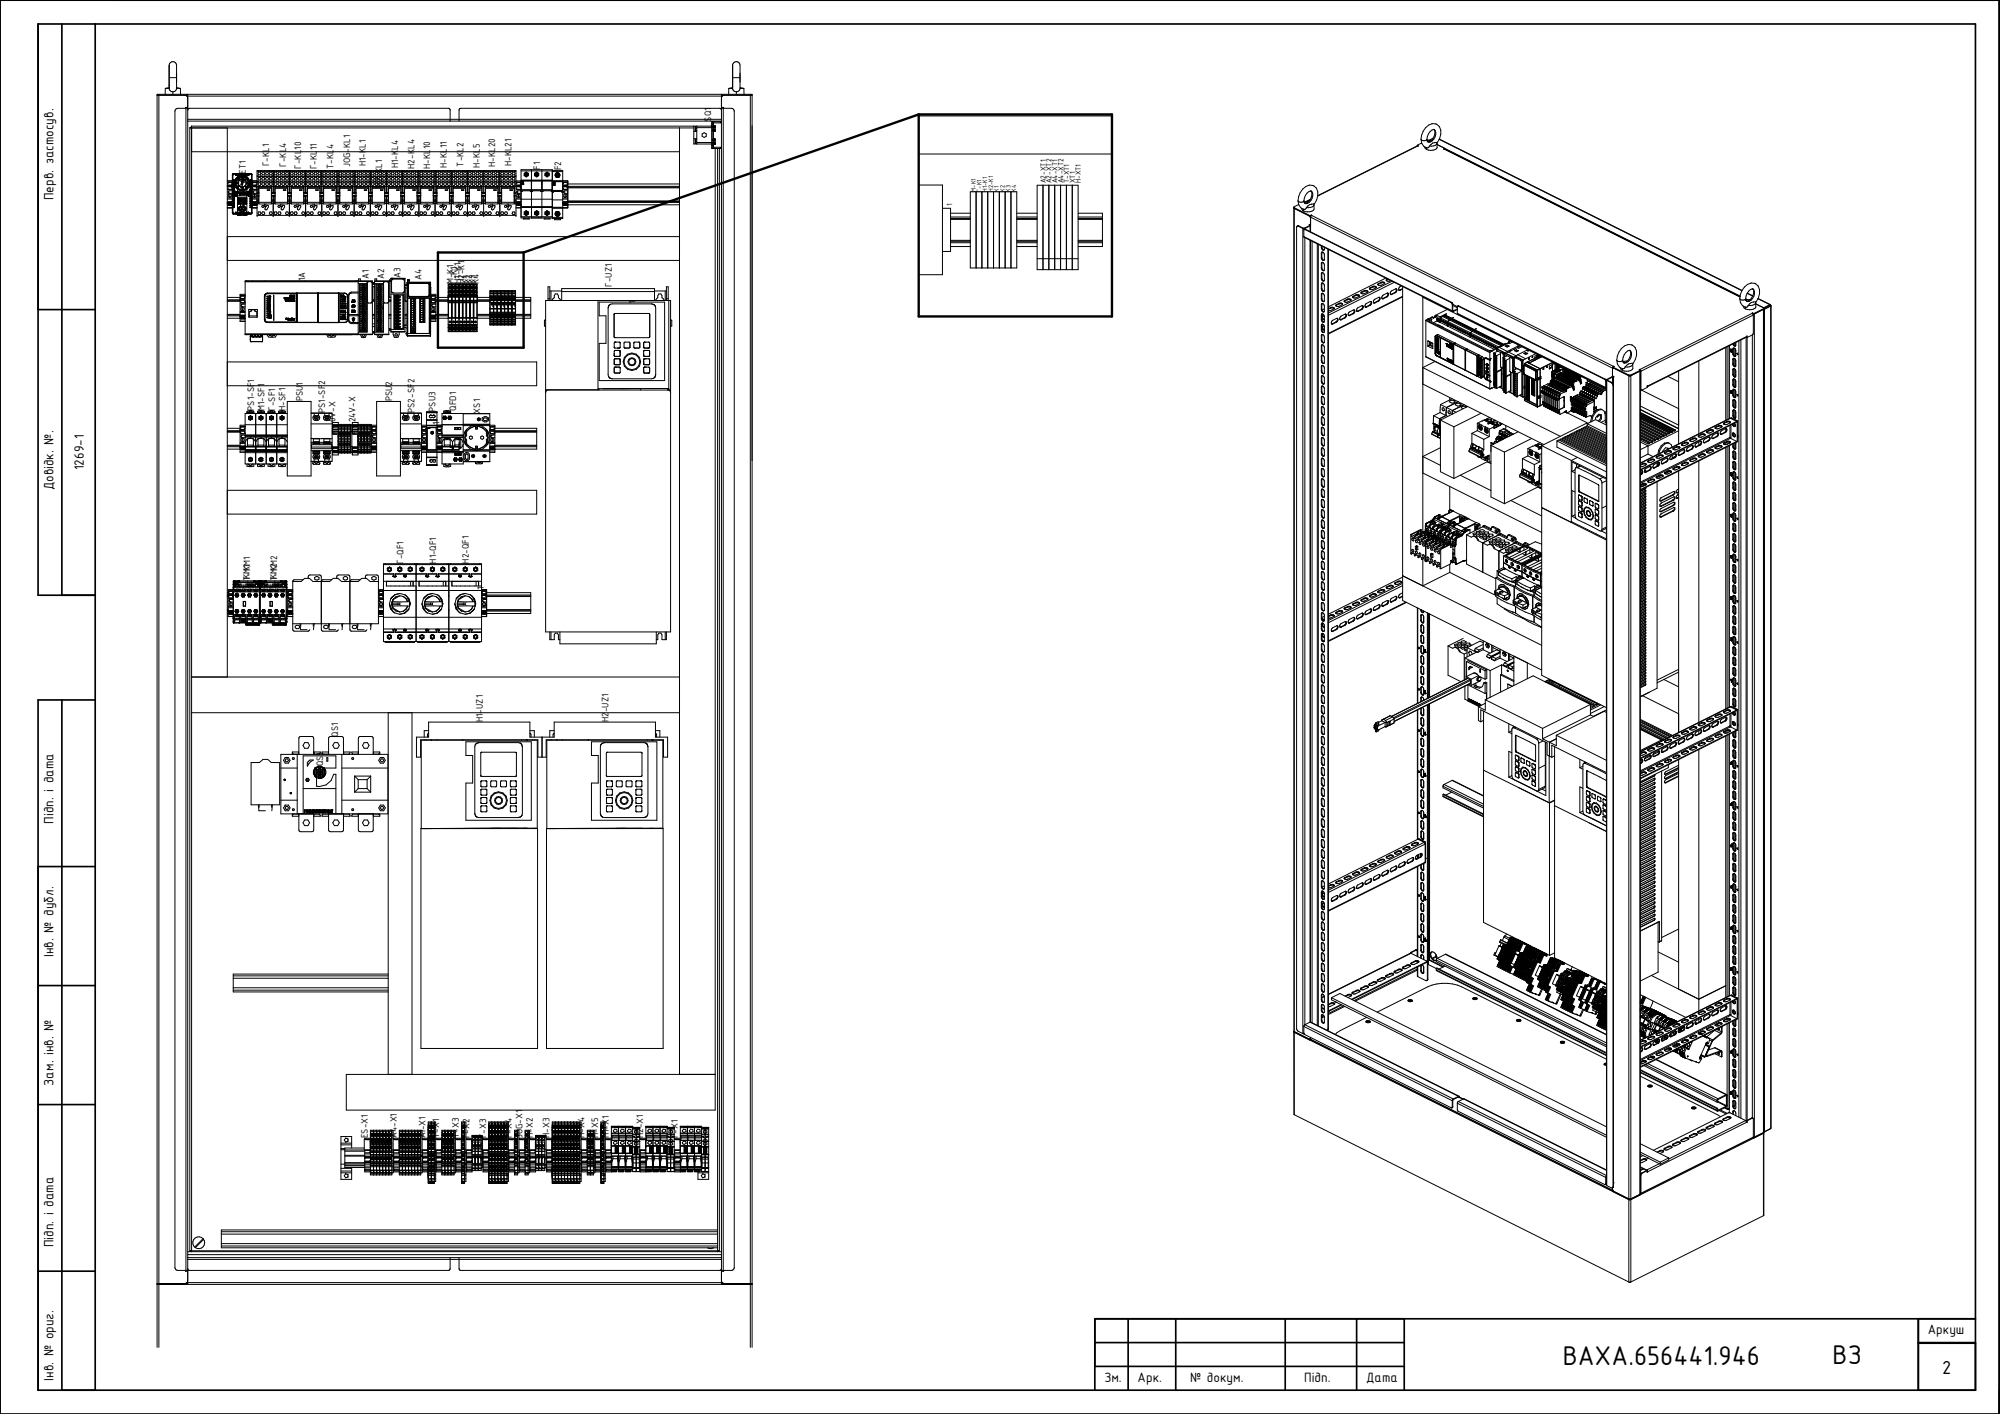
[picture p13: page 19]
PSU1; PSU2; PSU3 1; JOG-X1; JOG-KL1; QFD1

Довідк. №. Перв. застосув. Інв. № ориг. Підп. і дата Зам. інв. № Інв. № дубл. Підп. і дата
