alexeyfedorenkofau/Ur-Pak-1269/ИД/Завзаказ/1269/КД/1269-2 Пульт ГП/1269-2 Пульт керування головним приводом.pdf

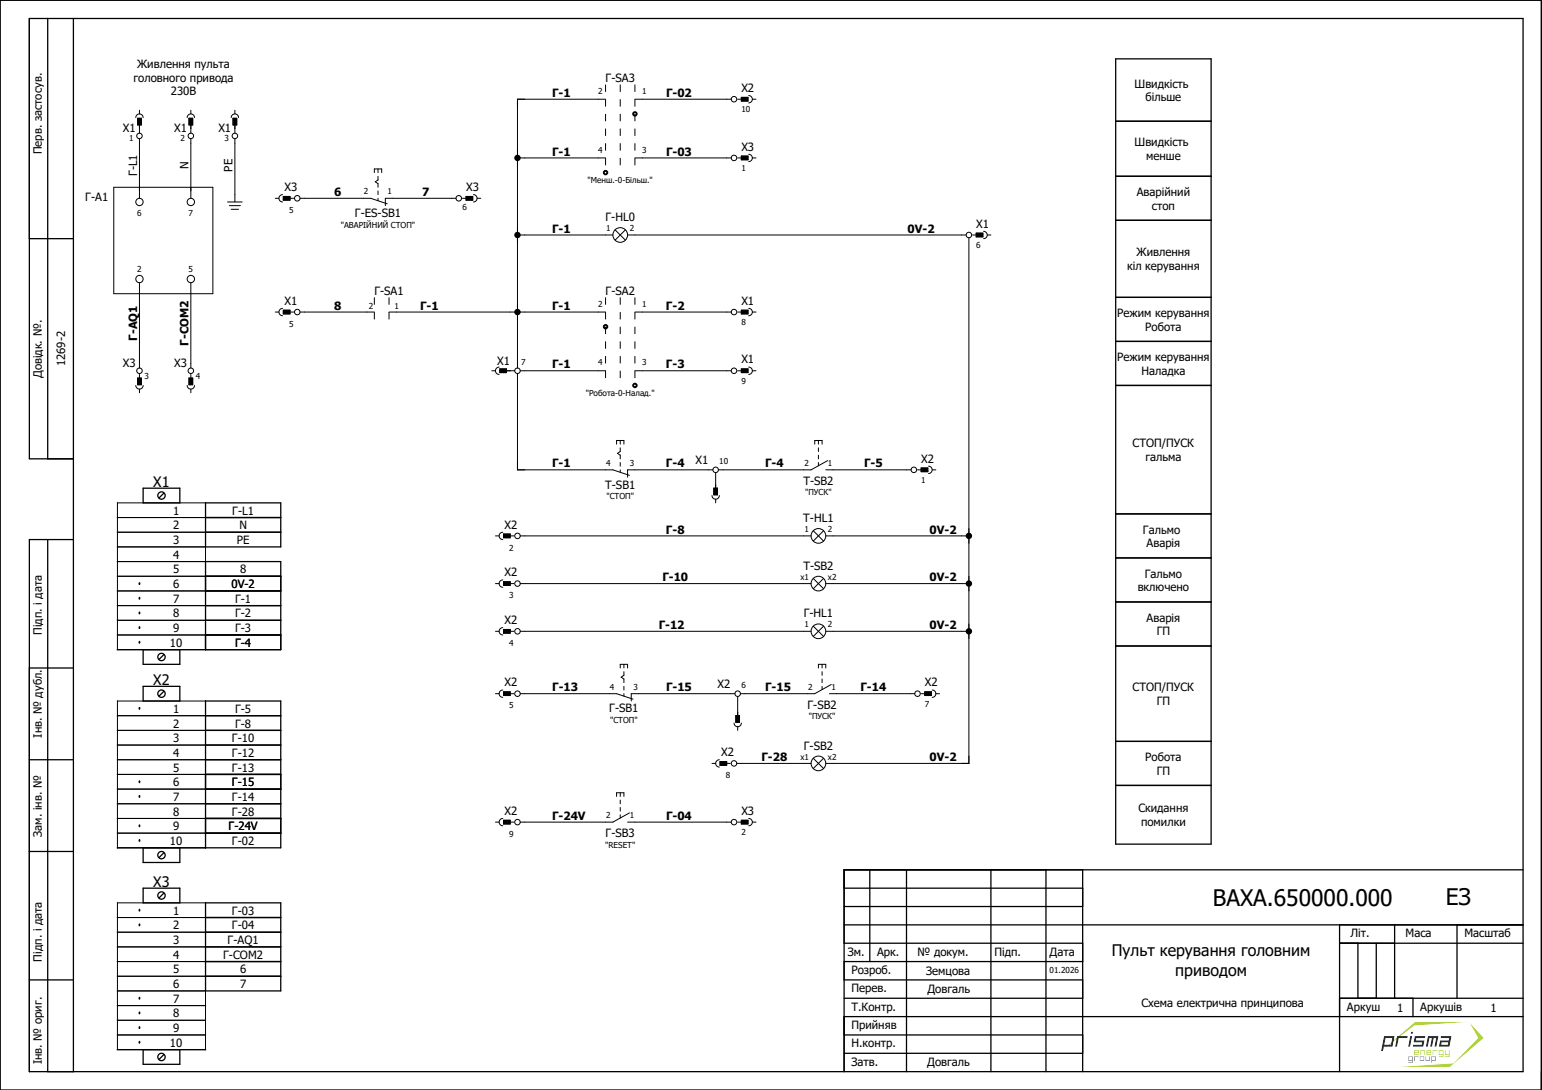
[picture p14: page 1]
Г-COM2 5; Живлення пульта головного привода 230В; Живлення кіл керування; Режим керування Робота; Режим керування Наладка; СТОП/ПУСК гальма; Гальмо Аварія; Гальмо включено; Аварія ГП; СТОП/ПУСК ГП; Робота ГП; Швидкість менше; Швидкість більше; Скидання помилки; Аварійний стоп; "СТОП" 4; "ПУСК" 2; Г-COM2; "АВАРІЙНИЙ СТОП" 2; "Робота-0-Налад."; "ПУСК"; "Менш.-0-Більш." 4; "RESET" 2

Довідк. №. Перв. застосув. Інв. № ориг. Підп. і дата Зам. інв. № Інв. № дубл. Підп. і дата

ВАХА.650000.000 ЕЗ

Пульт керування головним приводом Схема електрична принципова | Літ. | Маса | Масштаб

Зм. | Арк. | № докум. | Підп. | Дата
Розроб. | | Земцова | | 01.2026
Перев. | | Довгаль
Т.Контр. | | | | | Аркуш | Аркушів
Прийняв
Н.контр.
Затв. | Довгаль

Зм. | Арк. | № докум. | Підп. | Дата
| | Розроб. | Земцова | | 01.2026 | Пульт керування головним приводом Перелік елементів | Літ. | Аркуш | Аркушів
| | Перев.

# ВАХА.650000.000 ПЕ3

Довідк. №. Перв. застосув. Інв. № ориг. Підп. і дата Зам. інв. № Інв. № дубл. Підп. і дата

1269-2

Позиц. познач. | Найменування | Артікул | Кіл-ть Примітка
| Вимірювач
Г-A1 | Вимірювач цифровий. Мультиметр Індикатор постійної напруги цифровий MT4Y-DV-4N | MT4Y-DV-4N | 1 | Autonics
| Кнопка
T-SB1;Г-SB1 | Кнопка 22 мм червона з поверненням, 1NC | XA2EA42 | 2 | Schneider Electric
T-SB2;Г-SB2 | Кнопка 22мм 24В зелена з підсвічуванням, 1NO | XA2EW33B1 | 2 | Schneider Electric
Г-SB3 | Кнопка без фіксації XB2-BA21, 1NO, чорний | 505051 | 1 | Takel
Г-ES-SB1 | Кнопка аварійного останову 22 мм червона, повернення поворотом 1NC | XA2ES542 | 1 | Schneider Electric
| Монтажна плата
U1 | Фальшпанель 325*210 з покриттям | Монтажна панель 352х210 | 1 | Контур
| Перемикач
Г-SA2 | Перемикач 22 мм 3 позиції | XA2ED33 | 1 | Schneider Electric
Г-SA3 | Селекторний перемикач з короткою ручкою, 3 положення, повернення в центр, 2 NO | XA2ED53 | 1 | Schneider Electric
Г-SА1 | Перемикач 22 мм 2 позицій | XA2ED21 | 1 | Schneider Electric
| Сигнальна лампа
T-HL1;Г-HL1 | Сигнальна лампа 22мм 24В червона XA2EVB4LC | XA2EVB4LC | 2 | Schneider Electric
Г-HL0 | Сигнальна лампа 22 мм 24В зелена | XA2EVB3LC | 1 | Schneider Electric

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

# ВАХА.650000.000 ПЕ3(К)

Довідк. №. Перв. застосув. Інв. № ориг. Підп. і дата Зам. інв. № Інв. № дубл. Підп. і дата

1269-2

Найменування | Артікул | Кіл-ть Примітка

X1

Двохярусна клемма UKK 3-MSTB-5,08 колір сірий | 2770888 | 1

Phoenix
Contact
Двохярусна клемма UKK 3-MSTB-5,08 колір сірий | 2770888 | 1

Phoenix
Contact
Двохярусна клемма UKK 3-MSTB-5,08 колір сірий | 2770888 | 1

Phoenix
Contact

X3

X2

рамки 1 | Текст надпису | Кіл. Номер
2 | ГАЛЬМО АВАРІЯ | 1

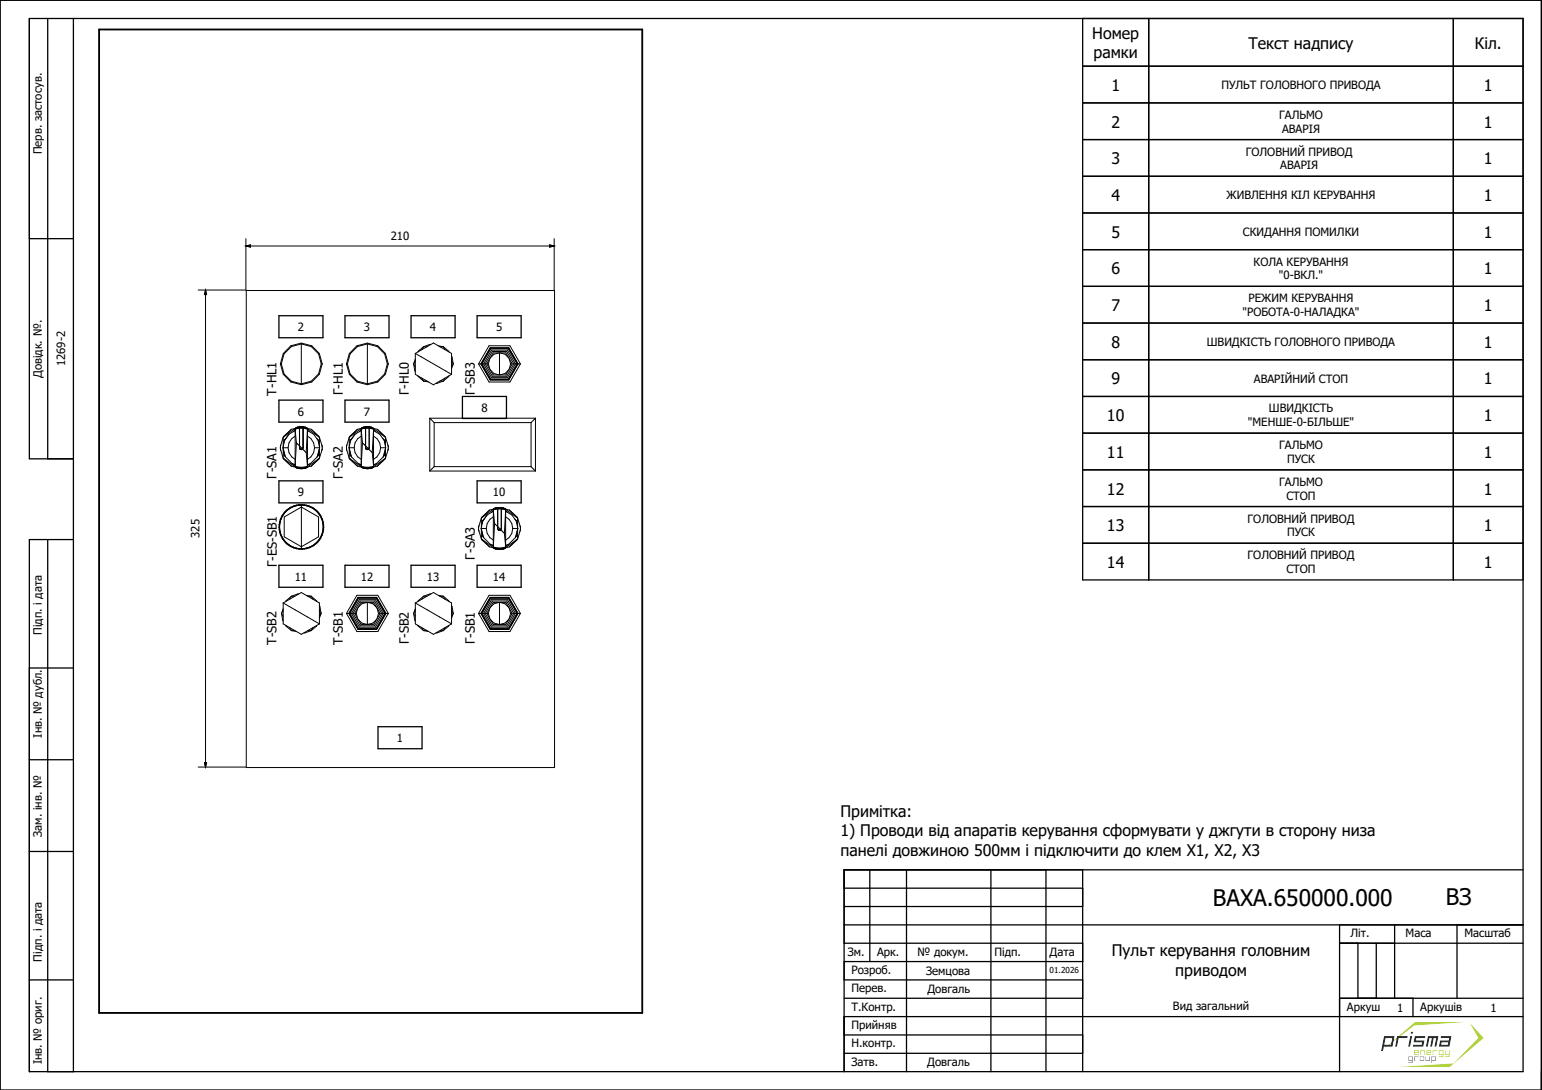
[picture p15: page 4]
ШВИДКІСТЬ "МЕНШЕ-0-БІЛЬШЕ"

Довідк. №. Перв. застосув. Інв. № ориг. Підп. і дата Зам. інв. № Інв. № дубл. Підп. і дата

ПУЛЬТ ГОЛОВНОГО ПРИВОДА

3 | ГОЛОВНИЙ ПРИВОД АВАРІЯ | 1

4 | ЖИВЛЕННЯ КІЛ КЕРУВАННЯ | 1

5 | СКИДАННЯ ПОМИЛКИ | 1

6 | КОЛА КЕРУВАННЯ "0-ВКЛ." | 1

7 | РЕЖИМ КЕРУВАННЯ "РОБОТА-0-НАЛАДКА" | 1

8 | ШВИДКІСТЬ ГОЛОВНОГО ПРИВОДА | 1

9 | АВАРІЙНИЙ СТОП | 1

11 | ГАЛЬМО ПУСК | 1

12 | ГАЛЬМО СТОП | 1

13 | ГОЛОВНИЙ ПРИВОД ПУСК | 1

ГОЛОВНИЙ ПРИВОД СТОП 14 | 1

Примітка:
1) Проводи від апаратів керування сформувати у джгути в сторону низа
панелі довжиною 500мм і підключити до клем Х1, Х2, Х3

ВАХА.650000.000 ВЗ

Пульт керування головним приводом Вид загальний | Літ. | Маса | Масштаб

Зм. | Арк. | № докум. | Підп. | Дата
Розроб. | | Земцова | | 01.2026
Перев. | | Довгаль
Т.Контр. | | | | | Аркуш | Аркушів
