alexeyfedorenkofau/Ur-Pak-1269/ИД/Завзаказ/1269/КД/1269-3 Пульт керування намоткою/1269-3 Пульт керування намоткою.pdf

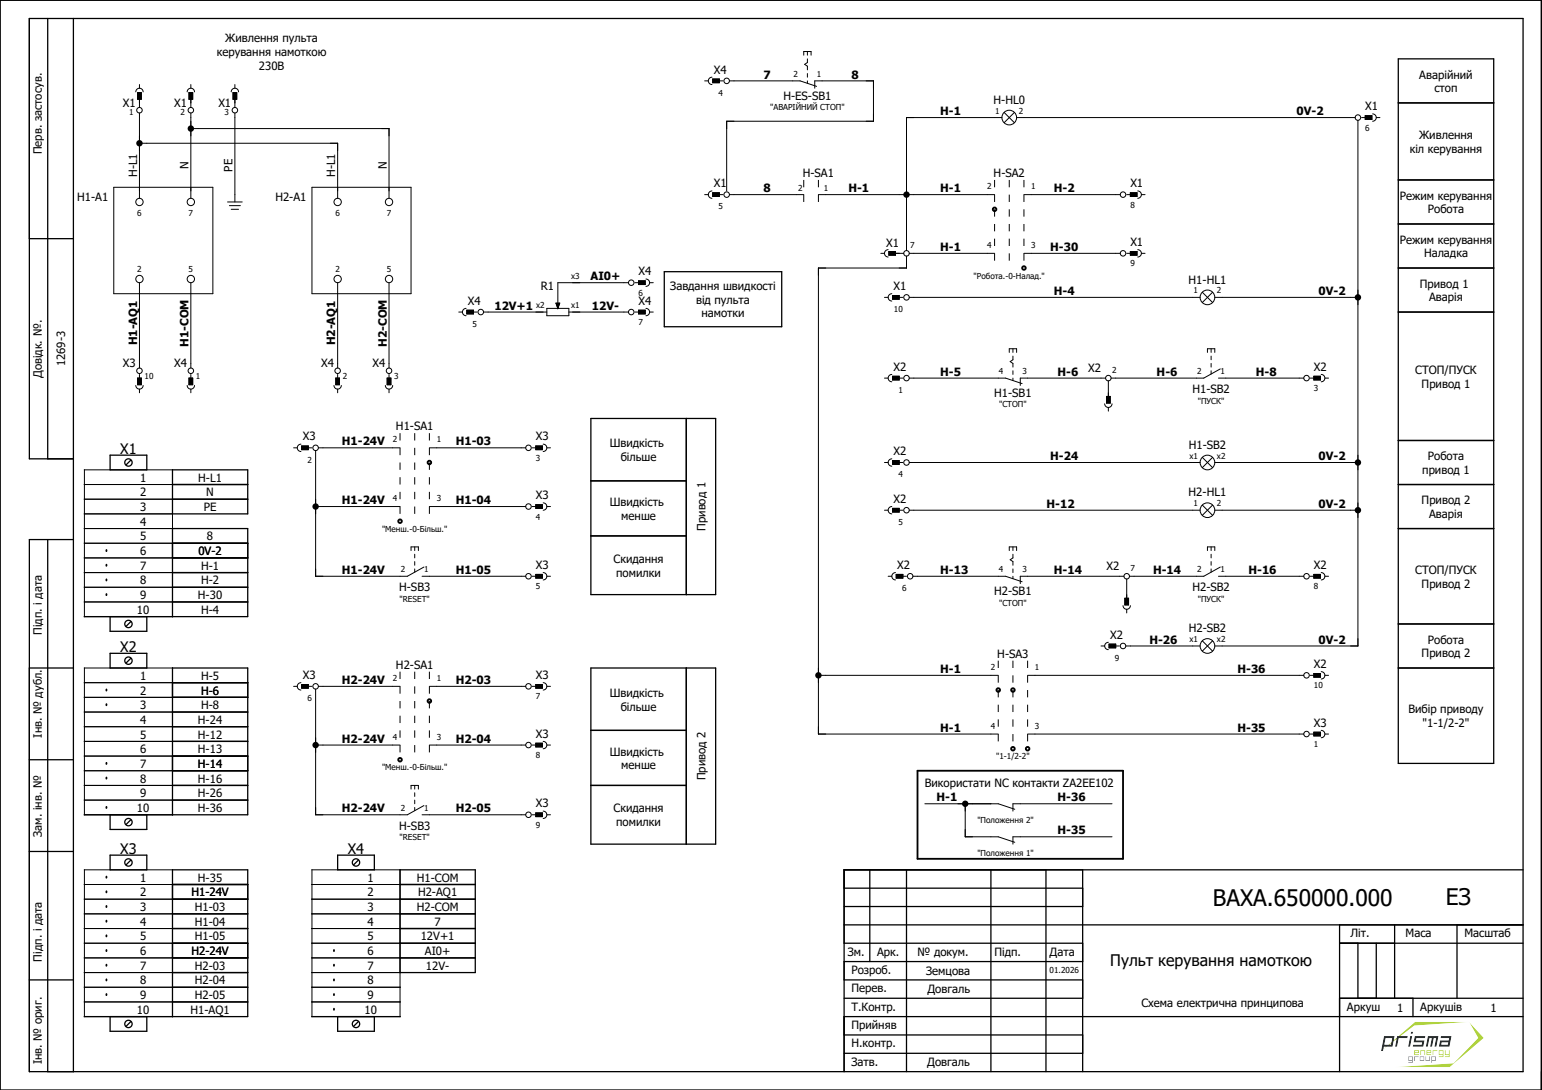
[picture p16: page 1]
Арк.; № докум.; Підп.; Дата; Літ.; Маса; Масштаб; ВАХА.650000.000; Н1-COM; Н2-COM; Живлення пульта керування намоткою 230В; Живлення кіл керування; Режим керування Робота; Режим керування Наладка; СТОП/ПУСК Привод 1; Привод 1 Аварія; Робота привод 1; Привод 2 Аварія; СТОП/ПУСК Привод 2; Робота Привод 2; Швидкість менше; Скидання помилки; Аварійний стоп; Швидкість більше; Привод 1 Привод 2; Вибір приводу "1-1/2-2"; Завдання швидкості від пульта намотки; "СТОП"; "ПУСК"; Н-ES-SB1 "АВАРІЙНИЙ СТОП"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

Довідк. №. Перв. застосув. Інв. № ориг. Підп. і дата Зам. інв. № Інв. № дубл. Підп. і дата

Швидкість більше

6 | 0V-2
7 | Н-1
8 | Н-2
9 | Н-30
10 | Н-4

2 | Н-6
3 | Н-8
4 | Н-24
5 | Н-12
6 | Н-13
7 | Н-14

Використати NC контакти ZA2EE102

Пульт керування намоткою

Розроб. | Земцова | 01.2026
Перев. | Довгаль
Т.Контр. | | | Аркуш | Аркушів
Прийняв
Н.контр.
Затв. | Довгаль

Схема електрична принципова

Зм. | Арк. | № докум. | Підп. | Дата
| | Розроб. | Земцова | | 01.2026 | Перелік елементів | Літ. | Аркуш | Аркушів
| | Перев.

# ВАХА.650000.000 ПЕ3

Пульт керування намоткою | 1

Довідк. №. Перв. застосув. Інв. № ориг. Підп. і дата Зам. інв. № Інв. № дубл. Підп. і дата

1269-3

Позиц. познач. | Найменування | Артікул | Кіл-ть Примітка
| Вимірювач
Н1-A1;Н2-A1 | Вимірювач цифровий. Мультиметр Індикатор постійної напруги цифровий MT4Y-DV-4N | MT4Y-DV-4N | 2 | Autonics
| Кнопка
Н1-SB1;Н2-SB1 | Кнопка 22 мм червона з поверненням, 1NC | XA2EA42 | 2 | Schneider Electric
Н1-SB2;Н2-SB2 | Кнопка 22мм 24В зелена з підсвічуванням, 1NO | XA2EW33B1 | 2 | Schneider Electric
Н-SB3 | Кнопка без фіксації XB2-BA21, 1NO, чорний | 505051 | 1 | Takel
Н-SB3 | Контактный блок 1НО | ZA2EE101 | 1 | Schneider Electric
Н-ES-SB1 | Кнопка аварійного останову 22 мм червона, повернення поворотом 1NC | XA2ES542 | 1 | Schneider Electric
| Монтажна плата
U1 | Фальшпанель 325*210 з покриттям | Монтажна панель 352х210 | 1 | Контур
| Перемикач
R1 | Потенціометр 4,7k LA42DWQ-22 TNSy | TNSy5505574 | 1 | TNSy
Н1-SA1;Н2-SA1 | Селекторний перемикач з короткою ручкою, 3 положення, повернення в центр, 2 NO | XA2ED53 | 2 | Schneider Electric
Н-SA2;Н-SA3 | Перемикач 22 мм 3 позиції | XA2ED33 | 2 | Schneider Electric
Н-SA3 | Контактний блок 1НЗ | ZA2EE102 | 2 | Schneider Electric
Н-SА1 | Перемикач 22 мм 2 позицій | XA2ED21 | 1 | Schneider Electric
| Сигнальна лампа
Н1-HL1;Н2-HL1 | Сигнальна лампа 22мм 24В червона XA2EVB4LC | XA2EVB4LC | 2 | Schneider Electric
Н-HL0 | Сигнальна лампа 22 мм 24В зелена | XA2EVB3LC | 1 | Schneider Electric

Зм. | Арк. | № докум. | Підп. | Дата
| | Розроб. | Земцова | | 01.2026 | Перелік елементів | Літ. | Аркуш | Аркушів
| | Перев.

# ВАХА.650000.000 ПЕ3(К)

Пульт керування намоткою | 1

Довідк. №. Перв. застосув. Інв. № ориг. Підп. і дата Зам. інв. № Інв. № дубл. Підп. і дата

1269-3

Найменування | Артікул | Кіл-ть Примітка

X1

Двохярусна клемма UKK 3-MSTB-5,08 колір сірий | 2770888 | 1

Phoenix
Contact
Двохярусна клемма UKK 3-MSTB-5,08 колір сірий | 2770888 | 1

Phoenix
Contact
Двохярусна клемма UKK 3-MSTB-5,08 колір сірий | 2770888 | 1

Phoenix
Contact
Двохярусна клемма UKK 3-MSTB-5,08 колір сірий | 2770888 | 1

Phoenix
Contact

X3

X4

X2

рамки 1 | Текст надпису | Кіл. Номер
2 | ПРИВОД 1 АВАРІЯ | 1

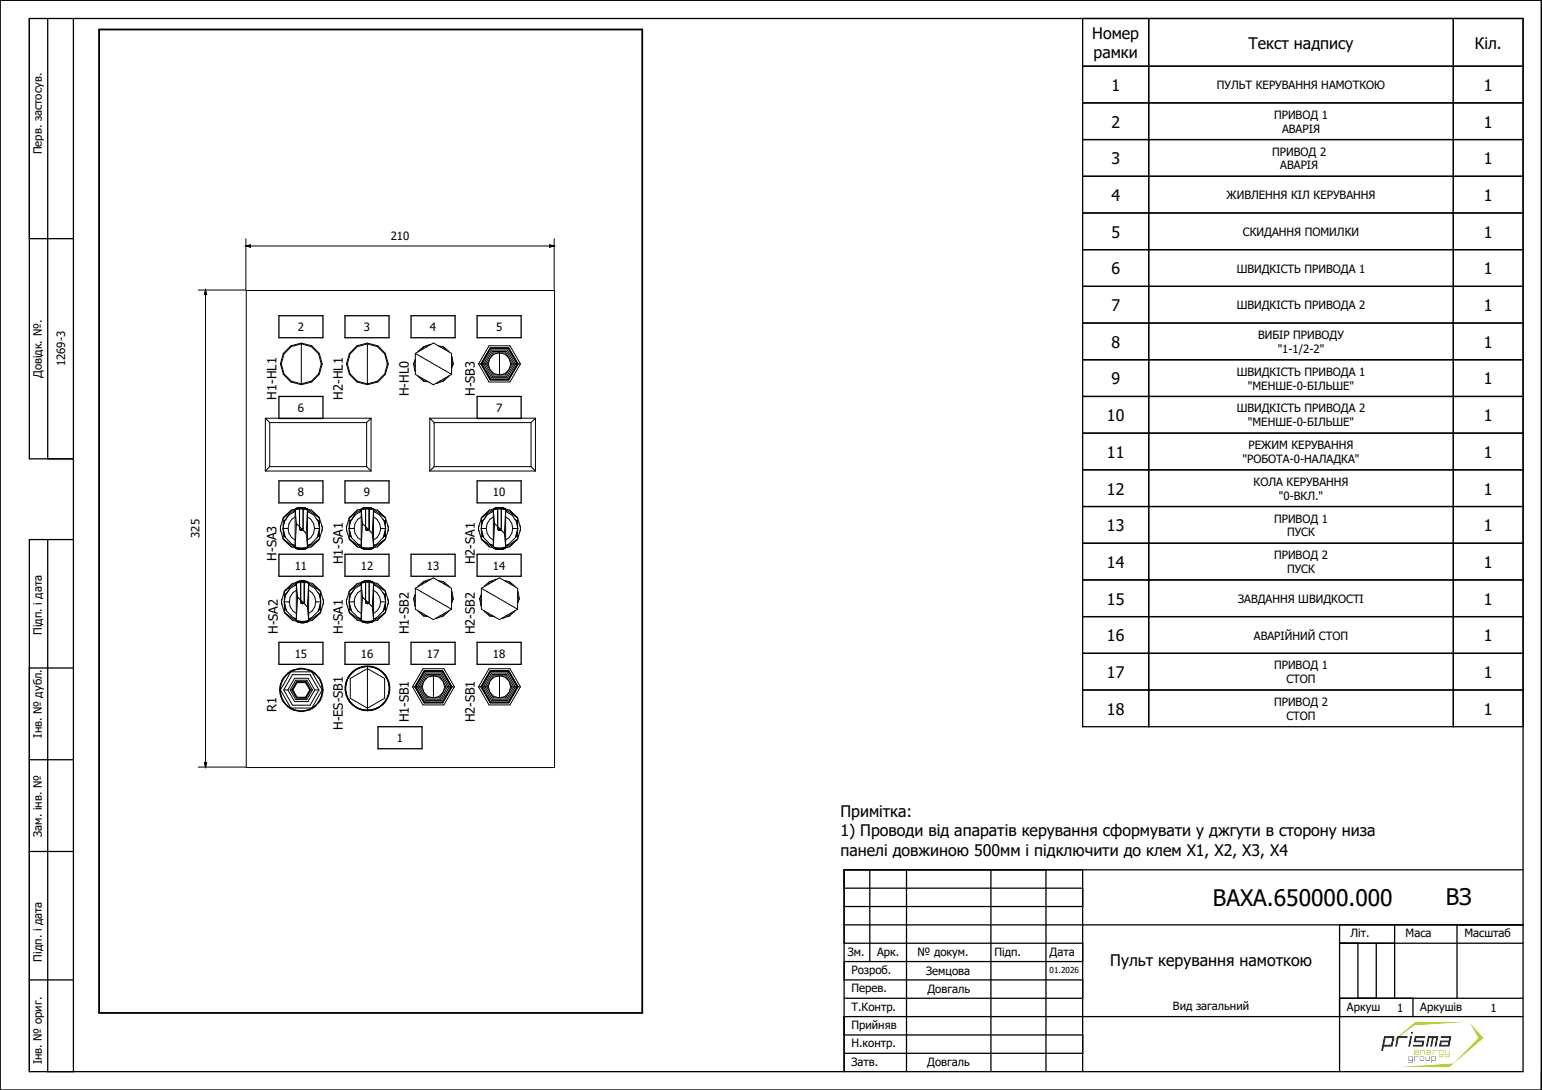
[picture p17: page 4]
ШВИДКІСТЬ ПРИВОДА 2 "МЕНШЕ-0-БІЛЬШЕ"

Довідк. №. Перв. застосув. Інв. № ориг. Підп. і дата Зам. інв. № Інв. № дубл. Підп. і дата

ПУЛЬТ КЕРУВАННЯ НАМОТКОЮ

3 | ПРИВОД 2 АВАРІЯ | 1

4 | ЖИВЛЕННЯ КІЛ КЕРУВАННЯ | 1

5 | СКИДАННЯ ПОМИЛКИ | 1

6 | ШВИДКІСТЬ ПРИВОДА 1 | 1

7 | ШВИДКІСТЬ ПРИВОДА 2 | 1

8 | ВИБІР ПРИВОДУ "1-1/2-2" | 1

9 | ШВИДКІСТЬ ПРИВОДА 1 "МЕНШЕ-0-БІЛЬШЕ" | 1

11 | РЕЖИМ КЕРУВАННЯ "РОБОТА-0-НАЛАДКА" | 1

12 | КОЛА КЕРУВАННЯ "0-ВКЛ." | 1

13 | ПРИВОД 1 ПУСК | 1

14 | ПРИВОД 2 ПУСК | 1

15 | ЗАВДАННЯ ШВИДКОСТІ

16 | АВАРІЙНИЙ СТОП | 1111

17 | ПРИВОД 1 СТОП

18 | ПРИВОД 2 СТОП

Примітка:
1) Проводи від апаратів керування сформувати у джгути в сторону низа
панелі довжиною 500мм і підключити до клем Х1, Х2, Х3, Х4

ВАХА.650000.000 ВЗ

Пульт керування намоткою Вид загальний | Літ. | Маса | Масштаб

Зм. | Арк. | № докум. | Підп. | Дата
Розроб. | | Земцова | | 01.2026
Перев. | | Довгаль
Т.Контр. | | | | | Аркуш | Аркушів
