alexeyfedorenkofau/Ur-Pak-1269/ИД/Завзаказ/1269/КД/1269-2 Пульт ГП/1269-2 ЗАМЕЧАНИЯ.pdf

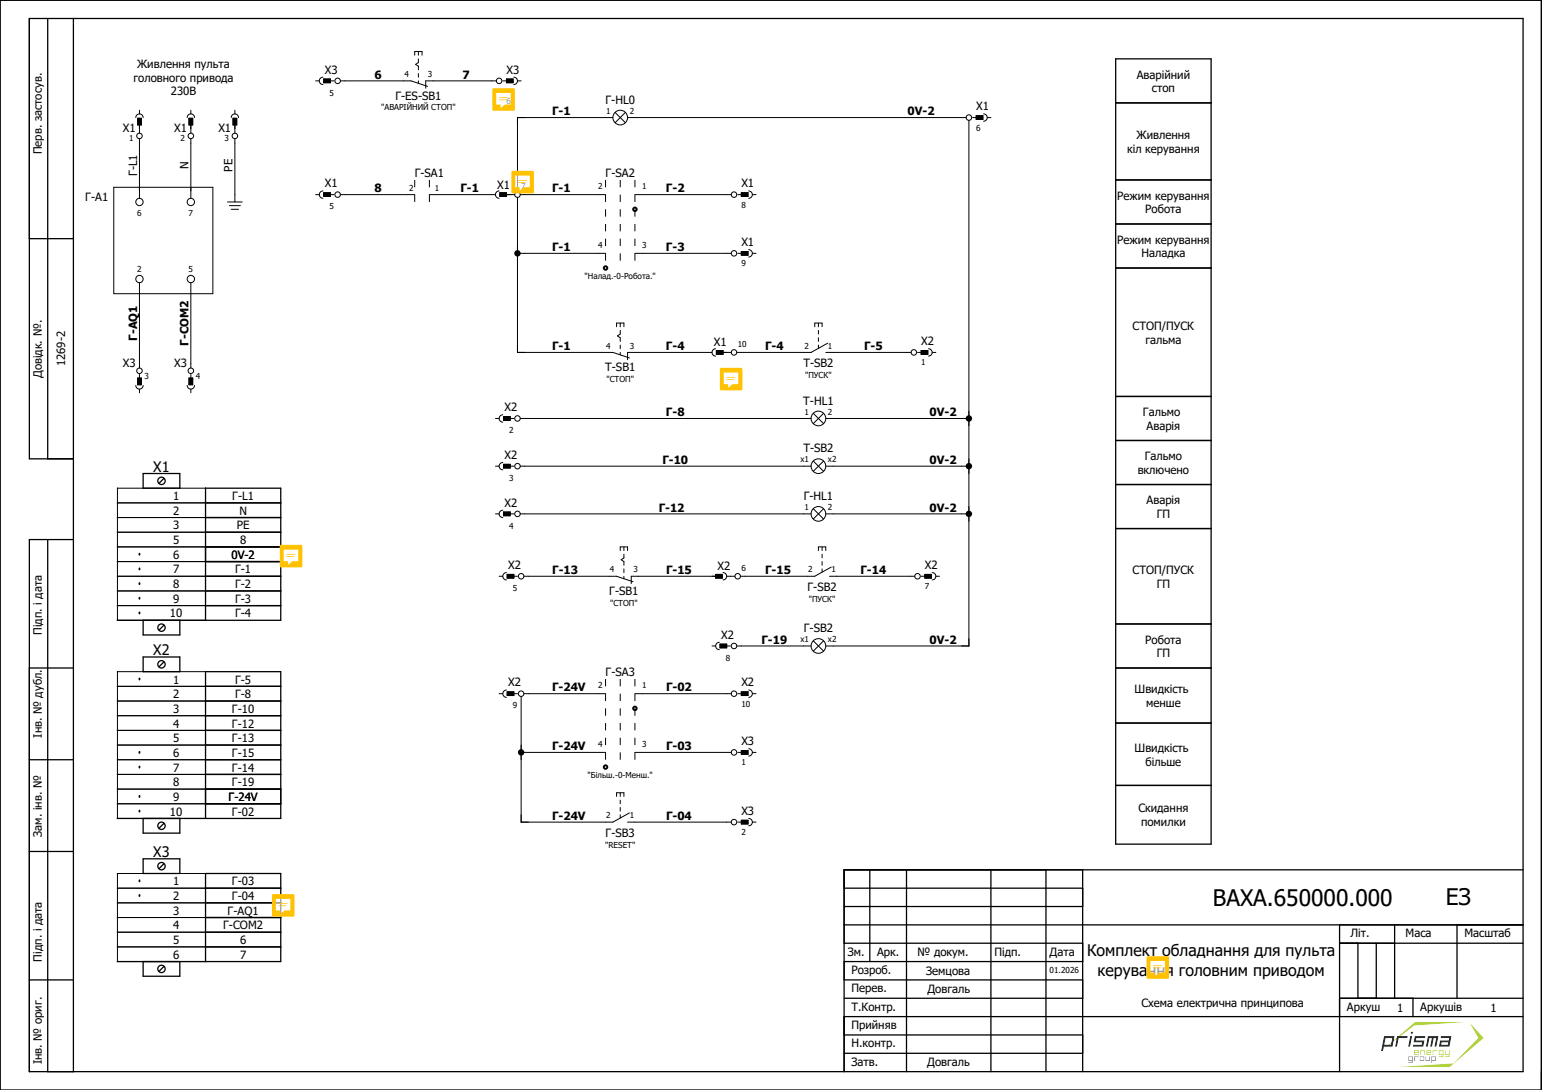
[picture p18: page 1]
Живлення пульта головного привода 230В; Живлення кіл керування; Режим керування Робота; Режим керування Наладка; СТОП/ПУСК гальма; Гальмо Аварія; Гальмо включено; Аварія ГП; СТОП/ПУСК ГП; Робота ГП; Швидкість менше; Швидкість більше; Скидання помилки; Аварійний стоп; "СТОП" 4; "ПУСК" 2; Г-COM2; "АВАРІЙНИЙ СТОП" 4; "Налад.-0-Робота." 4; "ПУСК"; "Більш.-0-Менш." 4; "RESET" 2

Довідк. №. Перв. застосув. Інв. № ориг. Підп. і дата Зам. інв. № Інв. № дубл. Підп. і дата

1 | Г-COM2 5 Г-AQ1 4 Г-03 2 Г-04 3 6 6 7

ВАХА.650000.000 ЕЗ

Комплект обладнання для пульта керування головним приводом Схема електрична принципова | Літ. | Маса | Масштаб

Зм. | Арк. | № докум. | Підп. | Дата
Розроб. | | Земцова | | 01.2026
Перев. | | Довгаль
Т.Контр. | | | | | Аркуш | Аркушів
Прийняв
Н.контр.
Затв. | Довгаль

Зм. | Арк. | № докум. | Підп. | Дата
| | Розроб. | Земцова | | 01.2026 | Комплект обладнання для пульта керування головним приводом Перелік елементів | Літ. | Аркуш | Аркушів
| | Перев.

# ВАХА.650000.000 ПЕ3

Довідк. №. Перв. застосув. Інв. № ориг. Підп. і дата Зам. інв. № Інв. № дубл. Підп. і дата

1269-2

Позиц. познач. | Найменування | Артікул | Кіл-ть Примітка
| Вимірювач
Г-A1 | Вимірювач цифровий. Мультиметр Індикатор постійної напруги цифровий MT4Y-DV-4N | MT4Y-DV-4N | 1 | Autonics
| Кнопка
T-SB1;Г-SB1 | Кнопка 22 мм червона з поверненням, 1NC | XA2EA42 | 2 | Schneider Electric
T-SB2;Г-SB2 | Кнопка 22мм 24В зелена з підсвічуванням, 1NO | XA2EW33B1 | 2 | Schneider Electric
Г-SB3 | Кнопка 22 мм чорна з поверненням, 1NO | XA2EA21 | 1 | Schneider Electric
Г-ES-SB1 | Кнопка аварійного останову 22 мм червона, повернення поворотом 1NC | XA2ES442 | 1 | Schneider Electric
| Перемикач
Г-SA2;Г-SA3 | Перемикач 22 мм 3 позиції | XA2ED33 | 2 | Schneider Electric
Г-SА1 | Перемикач 22 мм 2 позицій | XA2ED21 | 1 | Schneider Electric
| Сигнальна лампа
T-HL1;Г-HL1 | Сигнальна лампа 22мм 24В червона XA2EVB4LC | XA2EVB4LC | 2 | Schneider Electric
Г-HL0 | Сигнальна лампа 22 мм 24В зелена | XA2EVB3LC | 1 | Schneider Electric

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

# ВАХА.650000.000 ПЕ3(К)

Довідк. №. Перв. застосув. Інв. № ориг. Підп. і дата Зам. інв. № Інв. № дубл. Підп. і дата

1269-2

Найменування | Артікул | Кіл-ть Примітка

X1

Кінцевий стопор CLIPFIX 35 | 3022218 | 1 | Phoenix Contact
Двохярусна клемма UKK 3-MSTB-5,08 колір сірий | 2770888 | 9 | Phoenix Contact
Тримач маркування KLM 3 | 0811969 | 1 | Phoenix Contact
Кінцевий стопор CLIPFIX 35 | 3022218 | 1 | Phoenix Contact
Двохярусна клемма UKK 3-MSTB-5,08 колір сірий | 2770888 | 10 | Phoenix Contact
Тримач маркування KLM 3 | 0811969 | 1 | Phoenix Contact

X2

X3

Кінцевий стопор CLIPFIX 35 | 3022218 | 1 | Phoenix Contact
Двохярусна клемма UKK 3-MSTB-5,08 колір сірий | 2770888 | 6 | Phoenix Contact
Тримач маркування KLM 3 | 0811969 | 1 | Phoenix Contact

рамки 1 | Текст надпису | Кіл. Номер
2 | ГАЛЬМО АВАРІЯ | 1

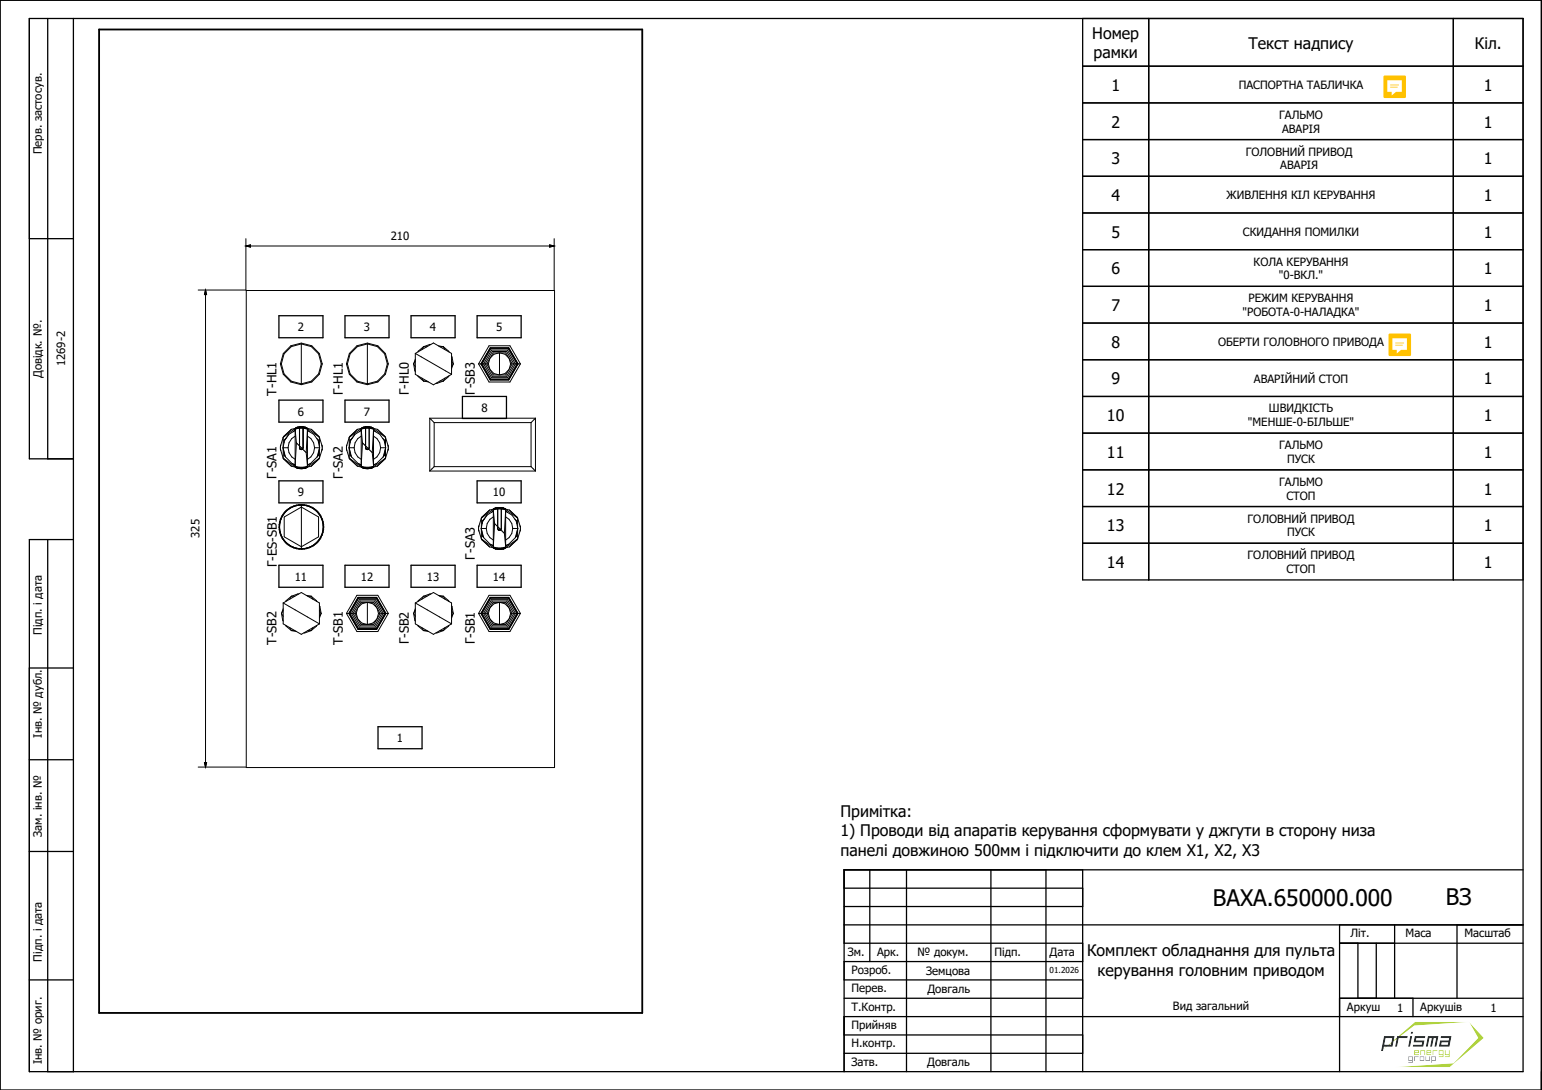
[picture p19: page 4]
ШВИДКІСТЬ "МЕНШЕ-0-БІЛЬШЕ"

Довідк. №. Перв. застосув. Інв. № ориг. Підп. і дата Зам. інв. № Інв. № дубл. Підп. і дата

ПАСПОРТНА ТАБЛИЧКА

3 | ГОЛОВНИЙ ПРИВОД АВАРІЯ | 1

4 | ЖИВЛЕННЯ КІЛ КЕРУВАННЯ | 1

5 | СКИДАННЯ ПОМИЛКИ | 1

6 | КОЛА КЕРУВАННЯ "0-ВКЛ." | 1

7 | РЕЖИМ КЕРУВАННЯ "РОБОТА-0-НАЛАДКА" | 1

8 | ОБЕРТИ ГОЛОВНОГО ПРИВОДА | 1

9 | АВАРІЙНИЙ СТОП | 1

11 | ГАЛЬМО ПУСК | 1

12 | ГАЛЬМО СТОП | 1

13 | ГОЛОВНИЙ ПРИВОД ПУСК | 1

ГОЛОВНИЙ ПРИВОД СТОП 14 | 1

Примітка:
1) Проводи від апаратів керування сформувати у джгути в сторону низа
панелі довжиною 500мм і підключити до клем Х1, Х2, Х3

ВАХА.650000.000 ВЗ

Комплект обладнання для пульта керування головним приводом Вид загальний | Літ. | Маса | Масштаб

Зм. | Арк. | № докум. | Підп. | Дата
Розроб. | | Земцова | | 01.2026
Перев. | | Довгаль
Т.Контр. | | | | | Аркуш | Аркушів
