alexeyfedorenkofau/Ur-Pak-1269/ИД/Завзаказ/1269/КД/1269-2 Пульт ГП/1269-2 Комплект обладнання для пульта керування головним приводом Замечания.pdf

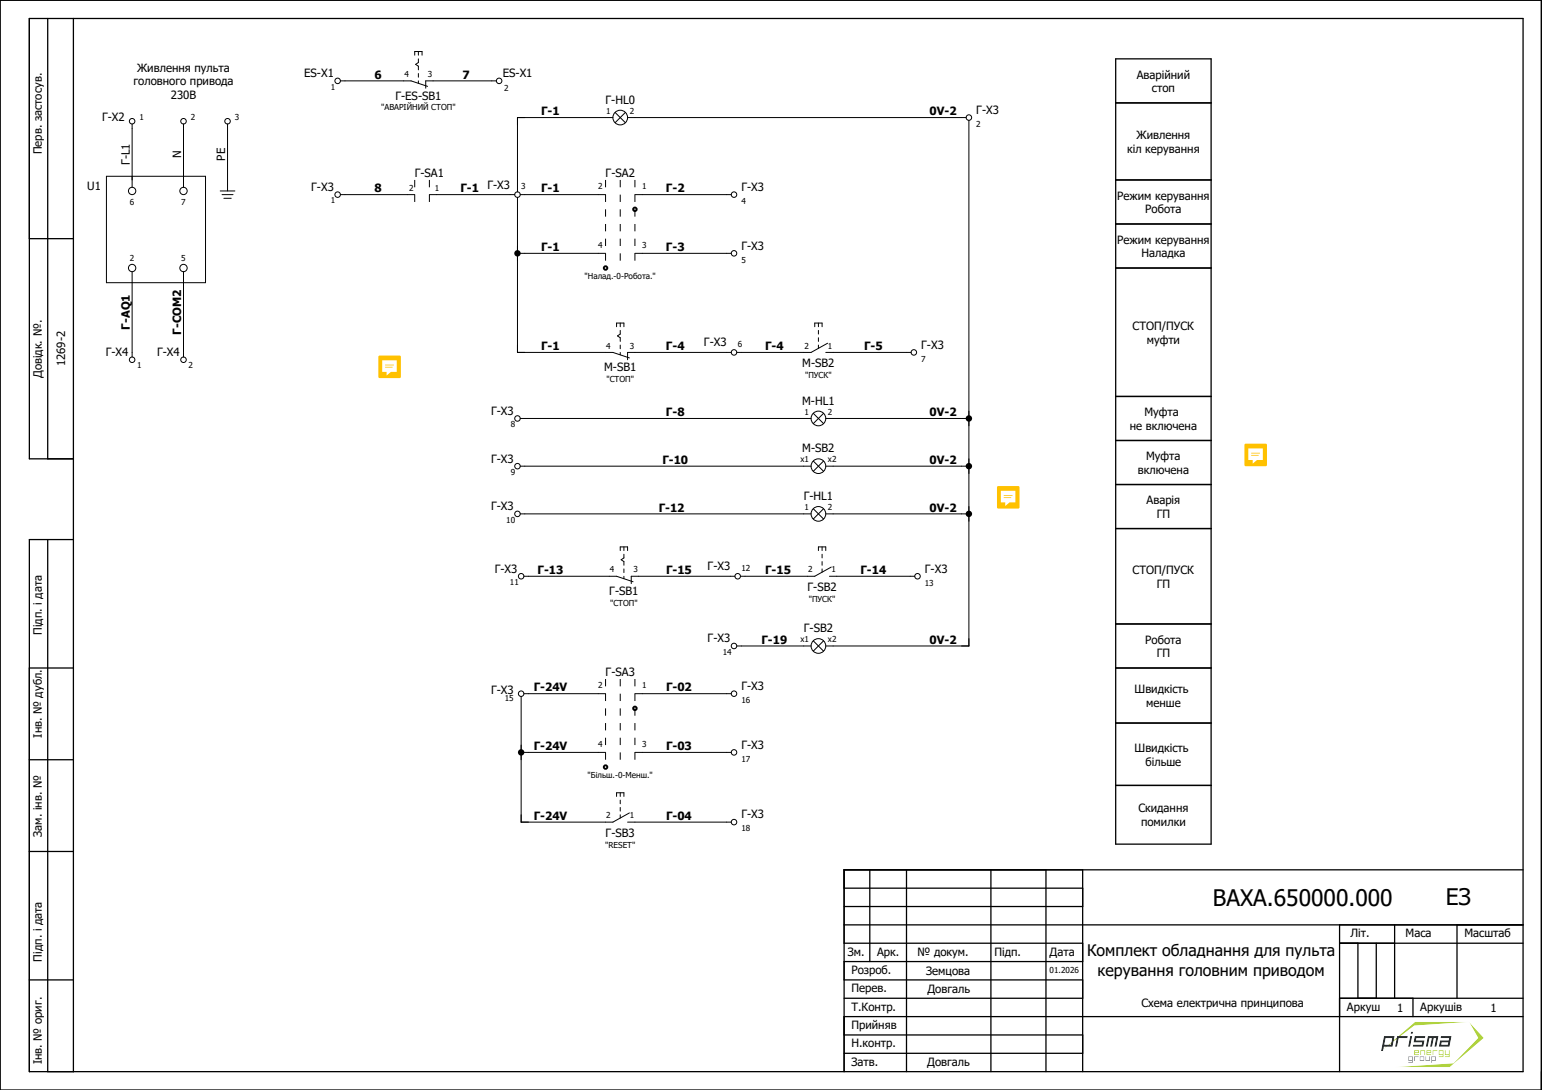
[picture p20: page 1]
Живлення пульта головного привода 230В; Живлення кіл керування; Режим керування Робота; Режим керування Наладка; СТОП/ПУСК муфти; Муфта не включена; Муфта включена; Аварія ГП; СТОП/ПУСК ГП; Робота ГП; Швидкість менше; Швидкість більше; Скидання помилки; Аварійний стоп; "СТОП"; "ПУСК"; Г-COM2; Г-ES-SB1 "АВАРІЙНИЙ СТОП"; "Налад.-0-Робота."; "Більш.-0-Менш."; "RESET"

Довідк. №. Перв. застосув. Інв. № ориг. Підп. і дата Зам. інв. № Інв. № дубл. Підп. і дата

ВАХА.650000.000 ЕЗ

Комплект обладнання для пульта керування головним приводом Схема електрична принципова | Літ. | Маса | Масштаб

Зм. | Арк. | № докум. | Підп. | Дата
Розроб. | | Земцова | | 01.2026
Перев. | | Довгаль
Т.Контр. | | | | | Аркуш 1 | Аркушів 1
Прийняв
Н.контр.
Затв. | Довгаль

рамки 1 | Текст надпису | Кіл. Номер
| ПАСПОРТНА ТАБЛИЧКА | 1

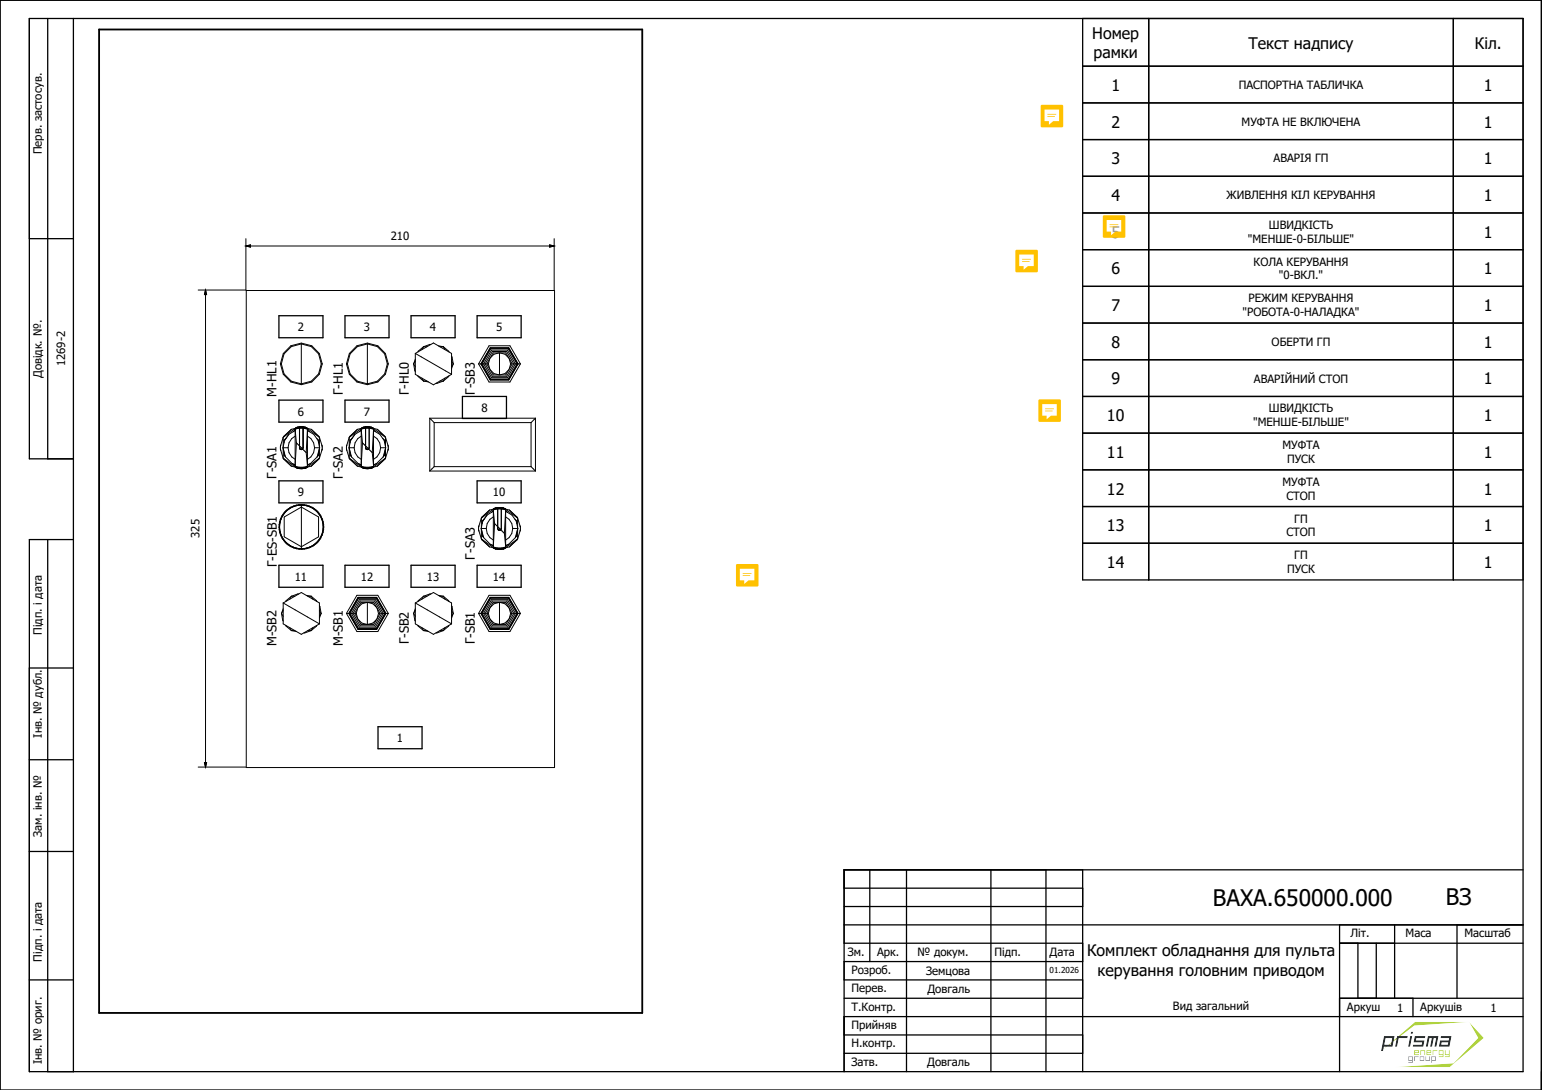
[picture p21: page 2]
ШВИДКІСТЬ "МЕНШЕ-БІЛЬШЕ"

Довідк. №. Перв. застосув. Інв. № ориг. Підп. і дата Зам. інв. № Інв. № дубл. Підп. і дата

2 | МУФТА НЕ ВКЛЮЧЕНА | 1

3 | АВАРІЯ ГП | 1

4 | ЖИВЛЕННЯ КІЛ КЕРУВАННЯ | 1

5 | ШВИДКІСТЬ "МЕНШЕ-0-БІЛЬШЕ" | 1

6 | КОЛА КЕРУВАННЯ "0-ВКЛ." | 1

7 | РЕЖИМ КЕРУВАННЯ "РОБОТА-0-НАЛАДКА" | 1

8 | ОБЕРТИ ГП | 1

9 | АВАРІЙНИЙ СТОП | 1

11 | МУФТА ПУСК | 1

12 | МУФТА СТОП | 1

13 | ГП СТОП | 1

14 | ГП ПУСК | 1

ВАХА.650000.000 ВЗ

Комплект обладнання для пульта керування головним приводом Вид загальний | Літ. | Маса | Масштаб

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
