alexeyfedorenkofau/Ur-Pak-1269/(commit log)

2026-01-29 Готово к наладке
    [1269-4_Комплектація .xls, 1269_8217.xls, 2025_11_17_ФГМ.- ИД в схему.xlsx, Призма Енерджи 8210_1269_17268.xls, Разметка пультов.dwg, Спецификация 1269-1.xls, Специфікація 1269-2.xlsm, Специфікація 1269-3.xlsm]
2026-02-25 Добавлено изменение скорости главного привода
    [1269-4_Комплектація .xls, наличие 1269-1.xlsx, наличие 1269-2.xlsx, наличие 1269-3.xlsx]
